apollo-lhc/Cornell_CM_Rev1_HW/README.md

# CU_PCB_6089-103
Cornell files for 6089-103 PCB, including schematics, layout, documentation
