apollo-lhc/Cornell_CM_Rev1_HW/Docs/TM4C_controller_pin_specs.xlsx

 | GPIO pin that needs to be configured
 | Alternate function pin that needs to be configured
 | Analog input
 | Pin with a pre-defined function
Pin Number | Pin Name | Pin Type | Buffer Type | Description | Signal Name
1 | AIN15 | I | Analog | Analog-to-digital converter input 15 | VCC_M1V8, direct measure of always-on 1.8v maintenance supply
2 | AIN14 | I | Analog | Analog-to-digital converter input 14 | VCC_M3V3, divided-by-2 measure of always-on 3.3v maintenance supply
3 | AIN13 | I | Analog | Analog-to-digital converter input 13 | VCC_2V5, divided-by-2 measure of 2.5v legacy timing supply.
4 | AIN12 | I | Analog | Analog-to-digital converter input 12 | VCC_12V, divided-by-6 measure of always-on 12v main input supply.
5 | PQ0 | O | TTL | GPIO port Q bit 0 | TM4C_TO_VU7P_0: This output to the VU7P is currently undefined
6 | PQ1 | I | TTL | GPIO port Q bit 1 | TM4C_FROM_VU7P_0: This input from the VU7P is currently undefined
7 | VDD | Power |  | Positive supply for I/O and some logic | VCC_M3V3: 3.3 volts from the management regulator. It is present whenever the board has 12v supplied.
8 | VDDA | Power |  | The positive supply for the analog circuits (ADC, Analog Comparators, etc.). | VCC_M3V3
9 | VREFA+ | Power |  | A reference voltage used to specify the voltage at which the ADC converts to a maximum value. | VREF_2.5V: This 2.5v voltage sets the value that will correspond to the ADC full scale valu of 4095 (0xfff)
10 | GNDA | Power |  | The ground reference for the analog circuits (ADC, Analog Comparators, etc.). | GND
11 | PQ2 | I | TTL | GPIO port Q bit 2 | TM4C_DIP_SW_2: Wired to position #4 of switch SW5, the VU7P DIP SWITCH. A HI level means that the VU7P should be powered; a LO level means that the VU7P should be left unpowered. The pullup on the switch is energized from the VCC_M3V3 source, so it is valid whenever the board has 12V supplied.
12 | AIN0 | I | Analog | Analog-to-digital converter input 0 | V_MGTY1_AVTT, direct measure of 1.2v VU7P GTY AVTT supply
13 | AIN1 | I | Analog | Analog-to-digital converter input 1 | V_MGTY1_AVCC, direct measure of 0.9v VU7P GTY AVCC supply
14 | AIN2 | I | Analog | Analog-to-digital converter input 2 | V_MGTY1_VCCAUX, direct measure of 1.8v VU7P GTY VCCAUX supply
15 | AIN3 | I | Analog | Analog-to-digital converter input 3 | V_VCCINT, direct measure of 0.85v VU7P VCCINT supply
16 | VDD | Power |  | Positive supply for I/O and some logic | VCC_M3V3: 3.3 volts from the management regulator. It is present whenever the board has 12v supplied.
17 | GND | Power |  | Ground reference for logic and I/O pins | GND
18 | AIN16 | I | Analog | Analog-to-digital converter input 16 | VCC_3V3, divided-by-2 measure of 3.3v board-wide supply
19 | AIN17 | I | Analog | Analog-to-digital converter input 17 | V_MGTY2_VCCAUX, direct measure of 1.8v VU7P GTY VCCAUX supply
20 | AIN18 | I | Analog | Analog-to-digital converter input 18 | V_MGTY2_AVCC, direct measure of 0.9v VU7P GTY AVCC supply
21 | AIN19 | I | Analog | Analog-to-digital converter input 19 | V_MGTY2_AVTT, direct measure of 1.2v VU7P GTY AVTT supply
22 | PC7 | I | TTL | GPIO port C bit 7 | V_MGTY1_AVTT_OK
23 | PC6 | I | TTL | GPIO port C bit 6 | V_MGTY1_AVCC_OK
24 | PC5 | I | TTL | GPIO port C bit 5 | V_MGTY2_AVCC_OK
25 | PC4 | I | TTL | GPIO port C bit 4 | V_MGTY2_AVTT_OK
26 | VDD | Power |  | Positive supply for I/O and some logic | VCC_M3V3: 3.3 volts from the management regulator. It is present whenever the board has 12v supplied.
27 | PQ3 | O | TTL | GPIO port Q bit 3 | V_FPGA_PROGRAM: Momentarily pulse this output HI to force the VU7P to restart its configuration process
28 | VDD | Power |  | Positive supply for I/O and some logic | VCC_M3V3: 3.3 volts from the management regulator. It is present whenever the board has 12v supplied.
29 | PH0 | I | TTL | GPIO port H bit 0 | VCC_1V8_PG
30 | PH1 | I | TTL | GPIO port H bit 1 | VCC_3V3_PG
31 | PH2 | I | TTL | GPIO port H bit 2 | V_VCCINT_PG_B
32 | PH3 | I | TTL | GPIO port H bit 3 | V_VCCINT_PG_A
33 | U0Rx | I | TTL | UART Module 0 receive | BLADE_IPMC_TX
34 | U0Tx | O | TTL | UART Module 0 transmit | BLADE_IPMC_RX
35 | U4Rx | I | TTL | UART Module 4 receive | FRONT_PANEL_UART_RX
36 | U4Tx | O | TTL | UART Module 4 transmit | FRONT_PANEL_UART_TX
37 | PA4 | O | TTL | GPIO port A bit 4 | CTRL_V_VCCINT_PWR_EN
38 | PA5 | O | TTL | GPIO port A bit 5 | CTRL_VCC_1V8_PWR_EN
39 | VDD | Power |  | Positive supply for I/O and some logic | VCC_M3V3: 3.3 volts from the management regulator. It is present whenever the board has 12v supplied.
40 | I2C6SCL | I/O | OD | I2C module 6 clock. Note that this signal has an active pull-up. The corresponding port pin should not be configured as open drain. | FPGA_I2C_SCL
41 | I2C6SDA | I/O | OD | I2C module 6 data | FPGA_I2C_SDA
42 | PF0 | O | TTL | GPIO port F bit 0 | /FPGA_I2C_RESET
43 | PF1 | O | TTL | GPIO port F bit 1 | CTRL_VCC_3V3_PWR_EN
44 | PF2 | O | TTL | GPIO port F bit 2 | CTRL_K_VCCINT_PWR_EN
45 | PF3 | O | TTL | GPIO port F bit 3 | /PWR_I2C_RESET
46 | PF4 | I/O | TTL | GPIO port F bit 4 | TM4C_TP1: The use and direction of this pin is currently undefined. Configure it as an input. It connects to a surface-pad on the bottom side of the PCB.
47 | VDD | Power |  | Positive supply for I/O and some logic | VCC_M3V3: 3.3 volts from the management regulator. It is present whenever the board has 12v supplied.
48 | GND | Power |  | Ground reference for logic and I/O pins | GND
49 | I2C1SCL | I/O | OD | I2C module 1 clock. Note that this signal has an active pull-up. The corresponding port pin should not be configured as open drain. | PWR_I2C_SCL
50 | I2C1SDA | I/O | OD | I2C module 1 data | PWR_I2C_SDA
51 | I2C2SCL | I/O | OD | I2C module 2 clock. Note that this signal has an active pull-up. The corresponding port pin should not be configured as open drain. | CLOCKS_I2C_SCL
52 | I2C2SDA | I/O | OD | I2C module 2 data | CLOCKS_I2C_SDA
53 | I2C3SCL | I/O | OD | I2C module 3 clock. Note that this signal has an active pull-up. The corresponding port pin should not be configured as open drain. | V_OPTICS_I2C_SCL
54 | I2C3SDA | I/O | OD | I2C module 3 data | V_OPTICS_I2C_SDA
55 | I2C4SCL | I/O | OD | I2C module 4 clock. Note that this signal has an active pull-up. The corresponding port pin should not be configured as open drain. | K_OPTICS_I2C_SCL
56 | I2C4SDA | I/O | OD | I2C module 4 data | K_OPTICS_I2C_SDA
57 | PQ5 | O | TTL | GPIO port Q bit 5 | /CLOCKS_I2C_RESET
58 | PQ6 | O | TTL | GPIO port Q bit 6 | /V_OPTICS_I2C_RESET
59 | PK7 | O | TTL | GPIO port K bit 7 | /K_OPTICS_I2C_RESET
60 | PK6 | I | TTL | GPIO port K bit 6 | K_VCCINT_PG_B
61 | PK5 | I | TTL | GPIO port K bit 5 | K_VCCINT_PG_A
62 | PK4 | O | TTL | GPIO port K bit 4 | BLADE_POWER_OK: Assert this signal HI when the power-up sequence is done.
63 | VDD | Power |  | Positive supply for I/O and some logic | VCC_M3V3: 3.3 volts from the management regulator. It is present whenever the board has 12v supplied.
64 | /WAKE | I | TTL | An external input that brings the processor out of Hibernate mode when asserted. | Tied to GND. This function is not used.
65 | /HIB | O | TTL | An output that indicates the processor is in Hibernate mode | No connect
66 | XOSC0 | I | Analog | Hibernation module oscillator crystal input or an external clock reference input. Note that this is either a crystal or a 32.768-kHz oscillator for the Hibernation module RTC. | Tied to GND.
67 | XOSC1 | O | Analog | Hibernation module oscillator crystal output. Leave unconnected when using a single-ended clock source. | No connect
68 | VBAT | Power |  | Power source for the Hibernation module. It is normally connected to the positive terminal of a battery and serves as the battery backup/Hibernation module power-source supply. | VCC_M3V3: 3.3 volts from the management regulator. It is present whenever the board has 12v supplied. If a battery is not used, this pin connects directly to the VDD source.
69 | VDD | Power |  | Positive supply for I/O and some logic | VCC_M3V3: 3.3 volts from the management regulator. It is present whenever the board has 12v supplied.
70 | /RESET | I | TTL | System reset input | TM4C_ENABLE: This will be asserted high when: a) BLADE_POWER_EN is HI (either from the board being operated "stand alone" or the signal driven HI by the service module) b) AND both management supplies are good (VCC_M3V3 and VCC_M1V8) c) AND the front panel "RESET" switch is not activated.
71 | PM7 | I/O | TTL | GPIO port M bit 7 | BLADE_POWER_EN: this signal is used by the ZYNQ to signal to the MCU to enable or disable blade power on the CM. Configure it as an input with 2 mA internal pull-up.
72 | PM6 | I/O | TTL | GPIO port M bit 6 | BLADE_ZYNQ_GPIO1: The use and direction of this pin is currently undefined. Configure it as an input.
73 | PM5 | I/O | TTL | GPIO port M bit 5 | BLADE_ZYNQ_GPIO2: The use and direction of this pin is currently undefined. Configure it as an input.
74 | PM4 | I | TTL | GPIO port M bit 4 | K_MGTH_AVTT_OK
75 | PM3 | I | TTL | GPIO port M bit 3 | K_MGTH_AVCC_OK
76 | PM2 | I | TTL | GPIO port M bit 2 | K_MGTY_AVCC_OK
77 | PM1 | I | TTL | GPIO port M bit 1 | K_MGTY_AVTT_OK
78 | PM0 | I | TTL | GPIO port M bit 0 | /K_FPGA_DONE: This input will be asserted LO when the KU15P configuration process has completed successfully.
79 | VDD | Power |  | Positive supply for I/O and some logic | VCC_M3V3: 3.3 volts from the management regulator. It is present whenever the board has 12v supplied.
80 | GND | Power |  | Ground reference for logic and I/O pins | GND
81 | PL0 | O | TTL | GPIO port L bit 0 | K_FPGA_PROGRAM: Momentarily pulse this output HI to force the KU15P to restart its configuration process
82 | PL1 | I | TTL | GPIO port L bit 1 | TM4C_DIP_SW_1: Wired to position #4 of switch SW4, the KU15P DIP SWITCH. A HI level means that the KU15P should be powered; a LO level means that the KU15P should be left unpowered. The pullup on the switch is energized from the VCC_M3V3 source, so it is valid whenever the board has 12V supplied.
83 | PL2 | O | TTL | GPIO port L bit 2 | CTRL_K_MGTY_VCCAUX_PWR_EN
84 | PL3 | O | TTL | GPIO port L bit 3 | CTRL_K_MGTH_VCCAUX_PWR_EN
85 | PL4 | O | TTL | GPIO port L bit 4 | CTRL_K_MGTY_AVCC_PWR_EN
86 | PL5 | O | TTL | GPIO port L bit 5 | CTRL_K_MGTH_AVCC_PWR_EN
87 | VDDC | Power |  | Positive supply for most of the logic function, including the processor core and most peripherals. The voltage on this pin is 1.2 V and is supplied by the on-chip LDO. The VDDC pins should only be connected to each other and an external capacitor as specified in Table 26-15 on page 1577 . | TM4C_VDDC: Tied to TM4C pin #115 and capacitor C791.
88 | OSC0 | I | Analog | Main oscillator crystal input or an external clock reference input. | TIed to GND. This design uses the 16 MHz internal oscillator "PIOSC".
89 | OSC1 | O | Analog | Main oscillator crystal output. Leave unconnected when using a single-ended clock source. | No connect
90 | VDD | Power |  | Positive supply for I/O and some logic | VCC_M3V3: 3.3 volts from the management regulator. It is present whenever the board has 12v supplied.
91 | I2C0SCL | I/O | OD | I2C module 0 clock. Note that this signal has an active pull-up. The corresponding port pin should not be configured as open drain. | BLADE_MASTER_I2C_SCL
92 | I2C0SDA | I/O | OD | I2C module 0 data | BLADE_MASTER_I2C_SDA
93 | PL7 | I | TTL | GPIO port L bit 7 | TM4C_FROM_KU15P_0: This input from the KU15P is currently undefined
94 | PL6 | O | TTL | GPIO port L bit 6 | TM4C_TO_KU15P_0: This output to the KU15P is currently undefined
95 | U1Rx | I | TTL | UART Module 1 receive | BLADE_ZYNQ_TX
96 | U1Tx | O | TTL | UART Module 1 transmit | BLADE_ZYNQ_RX
97 | TDO | O | TTL | JTAG TDO | JTAG_TDO | DO NOT PROGRAM
98 | TDI | I | TTL | JTAG TDI | JTAG_TDI | DO NOT PROGRAM
99 | TMS | I | TTL | JTAG TMS | JTAG_TMS | DO NOT PROGRAM
100 | TCK | I | TTL | JTAG TCK | JTAG_TCK | DO NOT PROGRAM
101 | VDD | Power |  | Positive supply for I/O and some logic | VCC_M3V3: 3.3 volts from the management regulator. It is present whenever the board has 12v supplied.
102 | PQ4 | O | TTL | GPIO port Q bit 4 | CTRL_K_MGTY_AVTT_PWR_EN
103 | PP2 | O | TTL | GPIO port P bit 2 | CTRL_K_MGTH_AVTT_PWR_EN
104 | PP3 | I/O | TTL | GPIO port P bit 3 | TM4C_TP2: The use and direction of this pin is currently undefined. Configure it as an input. It connects to a surface-pad on the bottom side of the PCB.
105 | PP4 | I/O | TTL | GPIO port P bit 4 | TM4C_TP3: The use and direction of this pin is currently undefined. Configure it as an input. It connects to a surface-pad on the bottom side of the PCB.
106 | PP5 | O | TTL | GPIO port P bit 5 | ID_EEPROM_WP: If jumper J16 is in the 2-to-3 position, then this pin controlls the write-protect pin on the ID EEPROM. A logic-0 allows writing. A logic-1 disables writing.
107 | PN0 | O | TTL | GPIO port N bit 0 | CTRL_V_MGTY2_AVTT_PWR_EN
108 | PN1 | O | TTL | GPIO port N bit 1 | CTRL_V_MGTY1_AVTT_PWR_EN
109 | PN2 | O | TTL | GPIO port N bit 2 | CTRL_V_MGTY2_AVCC_PWR_EN
110 | PN3 | O | TTL | GPIO port N bit 3 | CTRL_V_MGTY1_AVCC_PWR_EN
111 | PN4 | O | TTL | GPIO port N bit 4 | CTRL_V_MGTY2_VCCAUX_PWR_EN
112 | PN5 | O | TTL | GPIO port N bit 5 | CTRL_V_MGTY1_VCCAUX_PWR_EN
113 | VDD | Power |  | Positive supply for I/O and some logic | VCC_M3V3: 3.3 volts from the management regulator. It is present whenever the board has 12v supplied.
114 | GND | Power |  | Ground reference for logic and I/O pins | GND
115 | VDDC | Power |  | Positive supply for most of the logic function, including the processor core and most peripherals. The voltage on this pin is 1.2 V and is supplied by the on-chip LDO. The VDDC pins should only be connected to each other and an external capacitor as specified in Table 26-15 on page 1577 . | TM4C_VDDC: Tied to TM4C pin #87 and capacitor C791.
116 | PJ0 | O | TTL | GPIO port J bit 0 | TM4C_LED_BLUE: Assert this output HI to light the BLUE element of the TM4C RGB LED.
117 | PJ1 | O | TTL | GPIO port J bit 1 | TM4C_LED_GREEN: Assert this output HI to light the GREEN element of the TM4C RGB LED.
118 | PP0 | O | TTL | GPIO port P bit 0 | TM4C_LED_RED: Assert this output HI to light the RED element of the TM4C RGB LED.
119 | PP1 | I | TTL | GPIO port P bit 1 | /V_FPGA_DONE: This input will be asserted LO when the VU7P configuration process has completed successfully.
120 | AIN11 | I | Analog | Analog-to-digital converter input 11 | K_MGTH_AVTT, direct measure of 1.2v KU15P GTH AVTT supply
121 | AIN10 | I | Analog | Analog-to-digital converter input 10 | K_MGTH_AVCC, direct measure of 0.9v KU15P GTH AVCC supply
122 | VDD | Power |  | Positive supply for I/O and some logic | VCC_M3V3: 3.3 volts from the management regulator. It is present whenever the board has 12v supplied.
123 | AIN9 | I | Analog | Analog-to-digital converter input 9 | K_MGTH_VCCAUX, direct measure of 1.8v KU15P GTH VCCAUX supply
124 | AIN8 | I | Analog | Analog-to-digital converter input 8 | K_VCCINT, direct measure of 0.85v KU15P VCCINT supply
125 | AIN7 | I | Analog | Analog-to-digital converter input 7 | VCC_1V8, direct measure of 1.8v board-wide supply
126 | AIN6 | I | Analog | Analog-to-digital converter input 6 | K_MGTY_VCCAUX, direct measure of 1.8v KU15P GTY VCCAUX supply
127 | AIN5 | I | Analog | Analog-to-digital converter input 5 | K_MGTY_AVCC, direct measure of 0.9v KU15P GTY AVCC supply
128 | AIN4 | I | Analog | Analog-to-digital converter input 4 | K_MGTY_AVTT, direct measure of 1.2v KU15P GTY AVTT supply
