apollo-lhc/Cornell_CM_Rev1_HW/Orcad/6089-103-RevB_summary_BOM_with_inventory_23Jul2019.xlsx

Sheet: SCHEMATIC PARTS
6089-103
ATCA MEZZANINE BOARD, KU15P AND VU7P, MK1
Qty | 7
Item | quan/board | Reference | Description | Vendor | Vendor Number | Manufacturer | Manufacturer Number | Value | Footprint | Required | Min Excess | Min Qty | On Hand | At MPL | Short | Ordered | Received | Short | To MPL | Item | Unit Cost | Board Cost | Total Cost | Cost Source
1 | 3 | BR1,BR2,BR3 | BRACKET FOR FRONT PANEL, SCREW M3 4 PIN PCB RA | DigiKey | 36-7761-ND | Keystone | 7761 | KEYSTONE_7761 | KEYSTONE_7761 | 21 | 3 | 24 | 40 |  | -16 |  |  | -16 | 50 | 1 | $0.29 | $0.86 | $0.00
2 | 24 | C435,C436,C437,C438,C439,C440,C441,C442,C443,C444,C447,C448,C492,C493,C494,C495,C496,C497,C498,C499,C500,C501,C504,C505 | RES SMD 0 OHM JUMPER 1/16W 0402 | DigiKey | 311-0.0JRCT-ND | Yageo | RC0402JR-070RL | 0 | CAPC_EIA0402 | 168 | 10 | 178 |  |  |  |  |  | 0 | see item 40 | 2 |  | $0.00 | $0.00
3 | 8 | C579,C580,C581,C582,C953,C954,C957,C958 | CAP CER 820PF 50V NP0 0603 | DigiKey | 311-1775-1-ND | Yageo | CC0603JRNPO9BN821 | 820 PF | CAPC_EIA0603 | 56 | 4 | 60 | 30 | 40 | -10 |  |  | 0 | 100 | 3 | $0.11 | $0.91 | $0.00
4 | 5 | C882,C917,C918,C956,C959 | CAP CER 1000PF 50V X7R 0402 | DigiKey | 709-1133-1-ND | Johanson | 500R07W102KV4T | 1000 PF | CAPC_EIA0402 | 35 | 3 | 38 | 31 | 40 | -33 |  |  | 0 | 100 | 4 | $0.16 | $0.82 | $0.00
5 | 1 | C834 | CAP CER 3300PF 50V C0G/NP0 0603 | DigiKey | 490-6385-1-ND | Murata | GRM1885C1H332JA01D | 3.3 NF | CAPC_EIA0603 | 7 | 2 | 9 | 60 | 30 | -81 |  |  | 0 | 100 | 5 | $0.13 | $0.13 | $0.00
6 | 1 | C271 | CAP CER 10000PF 25V X7R 0402 | DigiKey | 490-1312-6-ND | Murata | GRM155R71E103KA01D | 0.01 UF | CAPC_EIA0402 | 7 | 2 | 9 | 47 | 40 | -78 |  |  | 0 | 100 | 6 | $0.08 | $0.08 | $0.00
7 | 16 | C17,C19,C21,C23,C25,C27,C29,C31,C365,C367,C369,C371,C373,C375,C377,C379 | CAP CER 0.047UF 25V X7R 0402 | DigiKey | 399-15998-1-ND | kemet | C0402C473K3RACAUTO | 0.047 UF | CAPC_EIA0402 | 112 | 7 | 119 | 290 | 51 | -222 |  |  | 0 | 150 | 7 | $0.11 | $1.71 | $0.00
8 | 20 | C770,C775,C779,C782,C785,C788,C797,C802,C806,C810,C811,C813,C814,C815,C816,C817,C818,C819,C820,C821 | CAP FILM 0.1UF 20% 16VDC 0805 | DigiKey | PCF1126CT-ND | Panasonic | ECP-U1C104MA5 | 0.1 UF | CAPC_EIA0805 | 140 | 9 | 149 | 136 | 47 | -34 |  |  | 0 | 150 | 8 | $0.32 | $6.34 | $0.00
9 | 342 | C1,C2,C3,C4,C9,C12,C13,C16,C20,C22,C24,C36,C37,C38,C39,C78,C90,C92,C93,C96,C97,C98,C99,C100,C101,C102,C103,C104,C109,C110,C113,C115,C116,C121,C124,C126,C127,C128,C129,C132,C133,C136,C137,C140,C141,C148,C149,C151,C155,C158,C159,C160,C161,C162,C165,C166,C171,C172,C173,C174,C181,C182,C185,C188,C189,C190,C191,C197,C200,C201,C204,C205,C210,C211,C214,C215,C216,C217,C222,C225,C227,C228,C230,C232,C233,C234,C235,C241,C242,C243,C244,C248,C249,C250,C251,C252,C257,C260,C264,C265,C268,C269,C270,C273,C281,C283,C284,C285,C286,C289,C293,C294,C295,C296,C297,C298,C300,C301,C302,C303,C304,C305,C308,C309,C310,C357,C358,C359,C360,C368,C372,C376,C380,C435,C436,C437,C438,C439,C440,C441,C442,C443,C444,C445,C446,C447,C448,C492,C493,C494,C495,C496,C497,C498,C499,C500,C501,C502,C503,C504,C505,C583,C584,C585,C586,C587,C588,C589,C590,C591,C592,C593,C594,C595,C596,C597,C598,C599,C600,C601,C602,C603,C604,C605,C606,C607,C608,C609,C610,C611,C612,C613,C614,C615,C616,C617,C618,C619,C620,C621,C622,C623,C624,C667,C668,C669,C670,C671,C672,C673,C674,C675,C676,C677,C678,C679,C680,C681,C682,C683,C684,C685,C686,C687,C688,C689,C690,C691,C692,C693,C694,C723,C724,C725,C726,C728,C729,C732,C733,C734,C735,C738,C739,C740,C741,C747,C752,C755,C756,C758,C760,C761,C762,C765,C766,C768,C769,C771,C772,C773,C774,C777,C778,C781,C783,C784,C786,C787,C789,C790,C792,C793,C794,C795,C796,C798,C799,C800,C801,C803,C804,C807,C808,C809,C812,C823,C824,C825,C826,C827,C828,C831,C832,C859,C860,C861,C862,C863,C864,C865,C866,C867,C868,C86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
27 | 1 | J1 | MGRID HDR SHRD RA /SLOTSTDF | DigiKey | WM9841-ND | Molex | 878335320 | CON_2X7_RA | CON_2X7_2MM_RA_XILINX | 7 | 2 | 9 | 12 |  | -3 |  |  | 0 | 15 | 27 | $1.09 | $1.09 | $0.00
28 | 6 | J2,J3,J4,J5,J7,J8 | CONN HEADER R/A 8POS 2MM | DigiKey | WM18614-ND | Molex | 877600816 | JUMPER_4X2 | HEADER_2MM_2X4_RA | 42 | 4 | 46 | 81 |  | -35 |  |  | 0 | 100 | 28 | $0.43 | $2.57 | $0.00
29 | 1 | J6 | HEADER 2X3 2MM RA, RS232 FOR CONTROLLER | DigiKey | WM18613-ND | Molex | 0877600616 | JUMPER_4X2 | HEADER_2MM_2x3_RA | 7 | 2 | 9 | 21 |  | -12 |  |  | 0 | 25 | 29 | $0.44 | $0.44 | $0.00
30 | 3 | J9,J10,J11 | HEADER 2X3 50MIL | DigiKey | SAM1156-03-ND | Samtec | FTS-103-01-L-D | JUMPER_DIFF | JUMPER_2X3_50MIL | 21 | 3 | 24 | 40 |  | -16 |  |  | 0 | 50 | 30 | $0.59 | $1.76 | $0.00
31 | 1 | J12 | HEADER 1X2 50MIL | DigiKey | SAM1156-01-ND | Samtec | FTS-101-01-L-D | JUMPER | JUMPER_1X2_50MIL | 7 | 2 | 9 | 30 |  | -21 |  |  | 0 | 50 | 31 | $0.22 | $0.22 | $0.00
32 | 3 | J13,J14,J15 | HEADER 2X2 50MIL | DigiKey | SAM1156-02-ND | Samtec | FTS-102-01-L-D | JUMPER_2X2 | JUMPER_2X2_50MIL | 21 | 3 | 24 | 39 |  | -15 |  |  | 0 | 50 | 32 | $0.41 | $1.22 | $0.00
33 | 1 | J16 | CONN HEADER VERT 3POS 1.27MM | DigiKey | S9014E-03-ND | Sullins | GRPB031VWVN-RC | JUMPER_3X1 | JUMPER_1X3_50MIL | 7 | 2 | 9 | 11 |  | -2 |  |  | 0 | 15 | 33 | $0.23 | $0.23 | $0.00
34 | 1 | J17 | TERM BLOCK HDR 4POS VERT 3.81MM | DigiKey | A98202-ND | TE | 284517-4 | TB4 | TB4 | 7 | 2 | 9 | 9 |  | 0 |  |  | 0 | 12 | 34 | $0.94 | $0.94 | $0.00
35 | 4 | L1,L2,L3,L4 | FERRITE BEAD 600 OHM 0805 1LN | DigiKey | 240-2399-2-ND | Laird | HZ0805E601R-10 | 600 OHM | IND_EIA0805 | 28 | 3 | 31 | 53 | 30 | -52 |  |  | 0 | 100 | 35 | $0.13 | $0.53 | $0.00
36 | 75 | L5,L6,L7,L8,L9,L10,L11,L12,L13,L14,L15,L16,L17,L18,L19,L20,L21,L22,L23,L24,L25,L26,L27,L28,L29,L30,L31,L32,L33,L34,L35,L36,L37,L38,L39,L40,L41,L42,L43,L44,L45,L46,L47,L48,L49,L50,L51,L52,L53,L54,L55,L56,L57,L58,L59,L60,L61,L62,L63,L64,L65,L66,L67,L68,L69,L70,L71,L72,L73,L74,L75,L76,L77,L78,L79 | 1µH Shielded Multilayer Inductor 2.5A 55 mOhm 1008 | DigiKey | 732-9689-6-ND | Wurth | 74479887210C | 1.0 UH | IND_1008 | 525 | 28 | 553 | 728 | 40 | -215 |  |  | 0 | 1000 | 36 | $0.47 | $35.18 | $0.00
37 | 1 | P1 | CONN, RIGHT-ANGLE POWER/SIGNAL HEADER | Samtec | ET60T-D02-3-08-000-S-R1-S | Samtec | ET60T-D02-3-08-000-S-R1-S | ET60T | ET60T-02-24-00-X-RT1-GP | 7 | 2 | 9 | 7 |  | 2 | 4 |  | 4 | 10 | 37 | $6.11 | $6.11 | $24.44
38 | 2 | P2,P3 | CONN, RIGHT-ANGLE ERM8 2X13 | Samtec | ERM8-013-01-S-D-RA-TR | Samtec | ERM8-013-01-S-D-RA-TR | ERM8 | ERM8-RA-2X13 | 14 | 2 | 16 | 22 |  | -6 |  |  | 0 | 21 | 38 | $5.94 | $11.88 | $0.00
39 | 27 | Q1,Q2,Q3,Q4,Q5,Q6,Q7,Q8,Q9,Q10,Q11,Q12,Q13,Q14,Q15,Q16,Q17,Q18,Q19,Q20,Q21,Q22,Q23,Q24,Q25,Q26,Q27 | MOSFET N-CH 20V 1.5A 1.8V LOGIC LEVEL TUMT3 | DigiKey | RUF015N02TLDKR-ND | Rohm | RUF015N02TL | FET_N_1.8V | RUF015N02_FET | 189 | 11 | 200 | 250 | 18 | -68 |  |  | 0 | 100 | 39 | $0.36 | $9.59 | $0.00 | get more
40 | 6 | R90,R91,R145,R146,R448,R489 | RES SMD 0 OHM JUMPER 1/16W 0402 | DigiKey | 311-0.0JRCT-ND | Yageo | RC0402JR-070RL | 0 | RESC_EIA0402 | 42 | 4 | 46 | 1000 |  | -954 |  |  | 0 | 10000 | 40 | $0.0013 | $0.01 | $0.00
41 | 80 | R73,R74,R75,R76,R77,R78,R79,R80,R153,R154,R155,R156,R157,R158,R159,R160,R191,R192,R230,R251,R252,R253,R254,R255,R256,R337,R338,R342,R343,R379,R381,R387,R389,R393,R394,R399,R400,R418,R420,R421,R427,R428,R429,R430,R439,R440,R441,R442,R449,R450,R461,R462,R472,R474,R479,R480,R481,R485,R518,R521,R522,R523,R527,R535,R661,R662,R663,R665,R698,R699,R700,R702,R703,R714,R717,R718,R726,R727,R728,R729 | RES SMD 0.0OHM JUMPER 1/10W 0603 | DigiKey | 311-0.0GRTR-ND | Yageo | RC0603JR-070RL | 0 | RESC_EIA0603 | 560 | 30 | 590 | 1000 |  | -410 |  |  | 0 | 5000 | 41 |  | $0.00 | $0.00
42 | 19 | R11,R25,R27,R72,R81,R83,R85,R92,R95,R98,R101,R107,R109,R113,R116,R123,R130,R133,R136 | RES SMD 33 OHM 1% 1/10W 0603 | DigiKey | 311-33.0HRDKR-ND | Yageo | RC0603FR-0733RL | 33 | RESC_EIA0603 | 133 | 8 | 141 | 1000 |  | -859 |  |  | 0 | 5000 | 42 | $0.0029 | $0.06 | $0.00
43 | 138 | R12,R18,R33,R34,R35,R36,R37,R38,R39,R40,R41,R42,R43,R44,R45,R46,R47,R48,R49,R50,R51,R52,R53,R54,R55,R56,R57,R58,R59,R60,R61,R62,R63,R64,R65,R66,R67,R119,R120,R129,R131,R138,R139,R161,R162,R163,R164,R165,R166,R167,R168,R169,R170,R171,R172,R173,R174,R175,R176,R177,R178,R179,R180,R181,R182,R183,R184,R185,R186,R187,R188,R189,R190,R348,R349,R350,R351,R352,R353,R354,R355,R356,R357,R358,R359,R360,R361,R362,R363,R364,R365,R366,R367,R368,R369,R370,R371,R372,R373,R374,R375,R376,R377,R540,R541,R542,R543,R544,R545,R546,R547,R548,R549,R550,R551,R552,R553,R554,R555,R556,R557,R558,R559,R560,R561,R562,R563,R564,R565,R566,R567,R568,R569,R570,R571,R572,R573,R574 | RES SMD 49.9 OHM 1% 1/10W 0402 | DigiKey | 311-49.9LRDKR-ND | Yageo | RC0402FR-0749R9L | 49p9 | RESC_EIA0402 | 966 | 50 | 1016 | 2000 |  | -984 |  |  | 0 | 10000 | 43 | $0.0018 | $0.25 | $0.00
~~44~~ | ~~6~~ | ~~R3,R4,R8,R9,R679,R680~~ | ~~RES SMD 59 OHM 1% 1/10W 0603~~ | ~~DigiKey~~ | ~~311-59.0HRDKR-ND~~ | ~~Yageo~~ | ~~RC0603FR-0759RL~~ | ~~59~~ | ~~RESC_EIA0603~~ | ~~42~~ | ~~4~~ | ~~46~~ |  |  |  |  |  | ~~0~~ | ~~5000~~ | ~~44~~ | ~~$0.00321~~ | ~~$0.02~~ | ~~$0.00~~
44 | 6 | R3,R4,R8,R9,R679,R680 | RES SMD 150 OHM 1% 1/10W 0603 | DigiKey | 311-150HRDKR-ND | Yageo | RC0603FR-07150RL | 150 | RESC_EIA0603 | 42 | 4 | 46 | 1000 |  | -954 |  |  | 0 | 5000 | 44 | $0.00321 | $0.02 | $0.00
45 | 49 | R84,R87,R88,R97,R100,R110,R111,R112,R117,R121,R125,R127,R132,R137,R142,R143,R147,R150,R151,R152,R452,R483,R486,R487,R490,R491,R492,R493,R494,R496,R497,R500,R502,R503,R504,R505,R506,R507,R508,R509,R510,R511,R512,R513,R514,R515,R516,R517,R519 | RES SMD 100 OHM 0.1% 1/16W 0402 | DigiKey | YAG2301CT-ND | Yageo | RT0402BRD07100RL | 100 | RESC_EIA0402 | 343 | 19 | 362 | 800 | 50 | -488 |  |  | 0 | 1000 | 45 | $0.06 | $2.94 | $0.00
46 | 6 | R89,R99,R141,R465,R466,R467 | RES SMD 240 OHM 1% 1/16W 0402 | DigiKey | 311-240LRCT-ND | Yageo | RC0402FR-07240RL | 240 | RESC_EIA0402 | 42 | 4 | 46 | 1000 |  | -954 |  |  | 0 | 10000 | 46 | $0.0018 | $0.01 | $0.00
47 | 2 | R524,R534 | RES SMD 249 OHM 0.1% 1/5W 0805 | DigiKey | TNP249ABCT-ND | Vishay | TNP249ABCT-ND | 249 | RESC_EIA0805 | 14 | 2 | 16 | 59 |  | -43 |  |  | 0 | 100 | 47 | $0.38 | $0.76 | $0.00
48 | 7 | R1,R5,R6,R10,R677,R678,R681 | RES SMD 270 OHM 1% 1/10W 0603 | DigiKey | 311-270HRDKR-ND | Yageo | RC0603FR-07270RL | 270 | RESC_EIA0603 | 49 | 4 | 53 | 1000 |  | -947 |  |  | 0 | 5000 | 48 | $0.0029 | $0.02 | $0.00
49 | 8 | R329,R330,R331,R332,R579,R580,R581,R582 | RES SMD 300 OHM 1% 1/10W 0603 | DigiKey | 311-300HRTR-ND | Yageo | RC0603FR-07300RL | 300 | RESC_EIA0603 | 56 | 4 | 60 | 1000 |  | -940 |  |  | 0 | 5000 | 49 | $0.0029 | $0.02 | $0.00
50 | 17 | R13,R19,R20,R30,R31,R69,R71,R102,R468,R469,R470,R471,R473,R475,R476,R676,R682 | RES SMD 1K OHM 1% 1/16W 0402 | DigiKey | 311-1.00KLRCT-ND | Yageo | RC0402FR-071KL | 1K | RESC_EIA0402 | 119 | 7 | 126 | 1000 |  | -874 |  |  | 0 | 10000 | 50 | $0.0018 | $0.03 | $0.00
51 | 92 | R257,R258,R261,R262,R265,R266,R269,R270,R273,R274,R277,R278,R281,R282,R285,R286,R289,R290,R293,R294,R297,R298,R301,R302,R305,R306,R309,R310,R341,R344,R345,R378,R380,R382,R383,R385,R388,R391,R395,R398,R401,R404,R406,R410,R411,R412,R414,R415,R416,R417,R587,R588,R603,R604,R607,R608,R611,R612,R615,R616,R619,R620,R623,R624,R627,R628,R631,R632,R635,R636,R639,R640,R643,R644,R650,R651,R652,R655,R656,R657,R674,R675,R683,R684,R686,R687,R689,R690,R692,R693,R695,R696 | RES SMD 2.2K OHM 1% 1/10W 0603 | DigiKey | 311-2.20KHRCT-ND | Yageo | RC0603FR-072K2L | 2.2k | RESC_EIA0603 | 644 | 34 | 678 | 1000 |  | -322 |  |  | 0 | 5000 | 51 | $0.0029 | $0.27 | $0.00
~~52~~ | ~~50~~ | ~~R259,R260,R263,R264,R267,R268,R271,R272,R275,R276,R279,R280,R283,R284,R287,R288,R291,R292,R295,R296,R299,R300,R303,R304,R307,R308,R311,R312,R601,R602,R605,R606,R609,R610,R613,R614,R617,R618,R621,R622,R625,R626,R629,R630,R633,R634,R637,R638,R641,R642~~ | ~~RES SMD 3.3K OHM 1% 1/10W 0603~~ | ~~DigiKey~~ | ~~311-3.30KHRDKR-ND~~ | ~~Yageo~~ | ~~RC0603FR-073K3L~~ | ~~3.3K~~ | ~~RESC_EIA0603~~ | ~~350~~ | ~~19~~ | ~~369~~ |  |  |  |  |  | ~~0~~ | ~~5000~~ | ~~52~~ |  | ~~$0.00~~ | ~~$0.00~~
52 | 58 | R259,R260,R263,R264,R267,R268,R271,R272,R275,R276,R279,R280,R283,R284,R287,R288,R291,R292,R295,R296,R299,R300,R303,R304,R307,R308,R311,R312,R314,R317,R320,R323,R590,R593,R596,R599,R601,R602,R605,R606,R609,R610,R613,R614,R617,R618,R621,R622,R625,R626,R629,R630,R633,R634,R637,R638,R641,R642 | RES SMD 3.3K OHM 1% 1/10W 0603 | DigiKey | 311-3.30KHRDKR-ND | Yageo | RC0603FR-073K3L | 3.3K | RESC_EIA0603 | 406 | 22 | 428 | 1000 |  | -572 |  |  | 0 | 5000 | 52 |  | $0.00 | $0.00
~~53~~ | ~~12~~ | ~~R213,R214,R219,R220,R333,R334,R335,R336,R575,R576,R577,R578~~ | ~~RES SMD 3.74K OHM 1% 1/10W 0603~~ | ~~DigiKey~~ | ~~P3.74KHDKR-ND~~ | ~~Panasonic~~ | ~~ERJ-3EKF3741V~~ | ~~3.74K~~ | ~~RESC_EIA0603~~ | ~~84~~ | ~~6~~ | ~~90~~ |  |  |  |  |  | ~~0~~ | ~~200~~ | ~~53~~ | ~~$0.06~~ | ~~$0.71~~ | ~~$0.00~~
53 | 4 | R213,R214,R219,R220 | RES SMD 3.74K OHM 1% 1/10W 0603 | DigiKey | P3.74KHDKR-ND | Panasonic | ERJ-3EKF3741V | 3.74K | RESC_EIA0603 | 28 | 3 | 31 | 115 | 38 | -122 |  |  | 0 | 200 | 53 | $0.06 | $0.24 | $0.00
54 | 63 | R2,R7,R14,R15,R16,R17,R21,R22,R23,R24,R93,R96,R103,R104,R105,R106,R114,R118,R122,R124,R126,R128,R135,R140,R144,R148,R149,R313,R316,R319,R322,R405,R407,R409,R413,R422,R443,R453,R454,R455,R456,R457,R460,R484,R498,R501,R591,R594,R597,R600,R647,R648,R649,R653,R654,R658,R659,R666,R667,R704,R705,R712,R713 | RES SMD 4.7K OHM 1% 1/10W 0603 | DigiKey | 311-4.70KHRDKR-ND | Yageo | RC0603FR-074K7L | 4.7K | RESC_EIA0603 | 441 | 24 | 465 | 1000 |  | -535 |  |  | 0 | 5000 | 54 |  | $0.00 | $0.00
~~55~~ | ~~111~~ | ~~R26,R70,R82,R86,R94,R108,R115,R134,R193,R196,R197,R200,R201,R204,R205,R208,R209,R212,R215,R216,R217,R218,R221,R222,R223,R224,R225,R226,R242,R314,R315,R317,R318,R320,R321,R323,R324,R339,R340,R346,R347,R384,R386,R390,R392,R396,R397,R402,R403,R408,R423,R424,R425,R426,R431,R432,R433,R434,R436,R438,R444,R445,R446,R447,R458,R495,R499,R520,R525,R526,R528,R529,R530,R531,R532,R533,R536,R537,R538,R539,R589,R590,R592,R593,R595,R596,R598,R599,R668,R669,R670,R671,R672,R673,R685,R688,R691,R694,R697,R706,R707,R708,R709,R710,R711,R720,R721,R722,R723,R724,R725~~ | ~~RES SMD 10K OHM 1% 1/10W 0603~~ | ~~DigiKey~~ | ~~311-10.0KHRDKR-ND~~ | ~~Yageo~~ | ~~RC0603FR-0710KL~~ | ~~10K~~ | ~~RESC_EIA0603~~ | ~~777~~ | ~~40~~ | ~~817~~ |  |  |  |  |  | ~~0~~ | ~~5000~~ | ~~55~~ |  | ~~$0.00~~ | ~~$0.00~~
55 | 92 | R26,R70,R82,R86,R94,R108,R115,R134,R215,R216,R217,R218,R221,R222,R223,R224,R225,R226,R315,R318,R321,R324,R339,R340,R346,R347,R384,R386,R390,R392,R396,R397,R402,R403,R408,R423,R424,R425,R426,R431,R432,R433,R434,R436,R438,R444,R445,R446,R447,R458,R495,R499,R520,R525,R526,R528,R529,R530,R531,R532,R533,R536,R537,R538,R539,R589,R592,R595,R598,R668,R669,R670,R671,R672,R673,R685,R688,R691,R694,R697,R706,R707,R708,R709,R710,R711,R720,R721,R722,R723,R724,R725 | RES SMD 10K OHM 1% 1/10W 0603 | DigiKey | 311-10.0KHRDKR-ND | Yageo | RC0603FR-0710KL | 10K | RESC_EIA0603 | 644 | 34 | 678 | 1000 |  | -322 |  |  | 0 | 5000 | 55 |  | $0.00 | $0.00
56 | 2 | R228,R242 | RES SMD 11K OHM 1% 1/10W 0603 | DigiKey | 311-11.0KHRDKR-ND | Yageo | RC0603FR-0711KL | 11.0K | RESC_EIA0603 | 14 | 2 | 16 | 1000 |  | -984 |  |  | 0 | 5000 | 56 | $0.0029 | $0.01 | $0.00
57 | 1 | R227 | RES SMD 12.1K OHM 1% 1/10W 0603 | DigiKey | 311-12.1KHRDKR-ND | Yageo | RC0603FR-0712K1L | 12.1K | RESC_EIA0603 | 7 | 2 | 9 | 1000 |  | -991 |  |  | 0 | 5000 | 57 | $0.0029 | $0.0029 | $0.00
58 | 1 | R233 | RES SMD 13.3K OHM 1% 1/10W 0603 | DigiKey | 311-13.3KHRDKR-ND | Yageo | RC0603FR-0713K3L | 13.3K | RESC_EIA0603 | 7 | 2 | 9 | 1000 |  | -991 |  |  | 0 | 5000 | 58 | $0.0029 | $0.0029 | $0.00
59 | 1 | R232 | RES SMD 14.7K OHM 1% 1/10W 0603 | DigiKey | 311-14.7KHRDKR-ND | Yageo | RC0603FR-0714K7L | 14.7K | RESC_EIA0603 | 7 | 2 | 9 | 1000 |  | -991 |  |  | 0 | 5000 | 59 | $0.0029 | $0.0029 | $0.00
60 | 4 | R245,R246,R248,R249 | RES SMD 16.2KOHM 0.1% 1/10W 0603 | DigiKey | P16.2KDBCT-ND | Panasonic | ERA-3AEB1622V | 16.2K | RESC_EIA0603 | 28 | 3 | 31 | 34 | 39 | -42 |  |  | 0 | 100 | 60 | $0.17 | $0.69 | $0.00
61 | 4 | R326,R328,R584,R586 | RES SMD 20K OHM 0.1% 1/10W 0603 | DigiKey | P20KDBCT-ND | Panasonic | ERA-3AEB203V | 20K | RESC_EIA0603 | 28 | 3 | 31 | 42 | 40 | -51 |  |  | 0 | 100 | 61 | $0.17 | $0.69 | $0.00
62 | 1 | R229 | RES SMD 21.5K OHM 1% 1/10W 0603 | DigiKey | 311-21.5KHRDKR-ND | Yageo | RC0603FR-0721K5L | 21.5K | RESC_EIA0603 | 7 | 2 | 9 | 1000 |  | -991 |  |  | 0 | 5000 | 62 | $0.0029 | $0.0029 | $0.00
63 | 1 | R234 | RES SMD 23.7K OHM 1% 1/10W 0603 | DigiKey | 311-23.7KHRDKR-ND | Yageo | RC0603FR-0723K7L | 23.7K | RESC_EIA0603 | 7 | 2 | 9 | 1000 |  | -991 |  |  | 0 | 5000 | 63 | $0.0029 | $0.0029 | $0.00
64 | 1 | R29 | RES SMD 34.8KOHM 0.1% 1/10W 0603 | DigiKey | P34.8KDBCT-ND | Panasonic | ERA-3AEB3482V | 34.8K | RESC_EIA0603 | 7 | 2 | 9 | 47 | 40 | -78 |  |  | 0 | 100 | 64 | $0.17 | $0.17 | $0.00
 | 1 | R231 | RES SMD 38.3KOHM 0.1% 1/10W 0603 | DigiKey | 311-38.3KHRTR-ND | Yageo | RC0603FR-0738K3L | 38,3K | RESC_EIA0603 | 7 | 2 | 9 | 5000 |  | -4991 |  |  | 0 | 100 | 64 | $0.17 | $0.17 | $0.00
65 | 4 | R325,R327,R583,R585 | RES SMD 40K OHM 0.1% 0.15W 0603 | DigiKey | PAT40KACT-ND | Vishay | PAT0603E4002BST1 | 40K | RESC_EIA0603 | 28 | 3 | 31 | 14 | 20 | -3 |  |  | 0 | 50 | 65 | $0.88 | $3.52 | $0.00
66 | 2 | R645,R646 | RES SMD 47K OHM 1% 1/10W 0603 | DigiKey | 311-47.0KHRDKR-ND | Yageo | RC0603FR-0747KL | 47K | RESC_EIA0603 | 14 | 2 | 16 | 1000 |  | -984 |  |  | 0 | 5000 | 66 | $0.0029 | $0.01 | $0.00
67 | 1 | R250 | RES SMD 61.9KOHM 0.1% 1/10W 0603 | DigiKey | P61.9KDBCT-ND | Panasonic | ERA-3AEB6192V | 61.9K | RESC_EIA0603 | 7 | 2 | 9 | 48 | 40 | -79 |  |  | 0 | 100 | 67 | $0.17 | $0.17 | $0.00
68 | 2 | R240,R243 | RES SMD 90.9K OHM 1% 1/10W 0603 | DigiKey | 311-90.9KHRDKR-ND | Yageo | RC0603FR-0790K9L | 90.9K | RESC_EIA0603 | 14 | 2 | 16 | 1000 |  | -984 |  |  | 0 | 5000 | 68 | $0.0029 | $0.01 | $0.00
69 | 2 | R241,R244 | RES SMD 100K OHM 1% 1/10W 0603 | DigiKey | 311-100KHRDKR-ND | Yageo | RC0603FR-07100KL | 100K | RESC_EIA0603 | 14 | 2 | 16 | 1000 |  | -984 |  |  | 0 | 5000 | 69 | $0.0029 | $0.01 | $0.00
70 | 1 | R28 | RES SMD 110K OHM 0.1% 1/10W 0603 | DigiKey | P110KDBCT-ND | Panasonic | ERA-3AEB114V | 110K | RESC_EIA0603 | 7 | 2 | 9 | 51 | 40 | -82 |  |  | 0 | 100 | 70 | $0.17 | $0.17 | $0.00
71 | 1 | R247 | RES SMD 147K OHM 0.1% 1/16W 0603 | DigiKey | A124705CT-ND | TE | RN73C1J147KBTD | 147K | RESC_EIA0603 | 7 | 2 | 9 | 48 | 40 | -79 |  |  | 0 | 100 | 71 | $0.47 | $0.47 | $0.00
72 | 3 | SW1,SW2,SW3 | SWITCH TACTILE SPST-NO 0.05A 12V | DigiKey | SW1103CT-ND | Omron | B3U-3100P-B | SPST-NO | SWITCH_B3U_3100P_B | 21 | 3 | 24 | 40 | 1 | -17 |  |  | 0 | 50 | 72 | $0.70 | $2.11 | $0.00
73 | 2 | SW4,SW5 | SWITCH SLIDE DIP SPST 25MA 24V | DigiKey | CT2184LPST-ND | CTS | 218-4LPST | DIP-4 | SW_DIP_4POS_50MIL | 14 | 2 | 16 | 44 |  | -28 |  |  | 0 | 50 | 73 | $0.97 | $1.94 | $0.00
74 | 7 | U1,U5,U6,U92,U93,U102,U103 | IC I/O EXPANDER I2C 16B 24TSSOP | DigiKey | 296-24827-1-ND | TI | TCA9555PWR | TCA9555 | TSSOP-24 | 49 | 4 | 53 | 62 | 10 | -19 |  |  | 0 | 100 | 74 | $1.05 | $7.32 | $0.00
75 | 8 | U2,U3,U4,U36,U91,U94,U100,U101 | IC I2C SW 8CH W/RESET 24TSSOP | DigiKey | 296-34905-2-ND | TI | TCA9548APWR | TCA9548A | TSSOP-24 | 56 | 4 | 60 | 60 | 10 | -10 |  |  | 0 | 100 | 75 | $1.05 | $8.44 | $0.00
76 | 10 | U7,U9,U37,U41,U50,U55,U60,U67,U78,U86 | IC BUFFER NON-INVERT 5.5V SOT5 | DigiKey | 296-18012-1-ND | TI | SN74LVC1G125DRLR | 74LVC1G125 | SOT5_DRL | 70 | 5 | 75 | 59 | 29 | -13 |  |  | 0 | 125 | 76 | $0.29 | $2.85 | $0.00
77 | 1 | U8 | IC REDRIVER 1CH 2GBPS 8VSSOP | Mouser | 296-13625-5-ND | TI | SN65LVDS100DGK | 65LVDS100 | TSSOP-8 | 7 | 2 | 9 | 9 |  | 0 |  |  | 0 | 12 | 77 | $5.57 | $5.57 | $0.00
78 | 1 | U10 | IC CLK BUFFER 1:3 2GHZ 16MLF | DigiKey | SY89872UMG-DKR-ND | Microchip | SY89872UMG | SY89872 | QFN-16 | 7 | 2 | 9 | 10 |  | -1 |  |  | 0 | 12 | 78 | $9.68 | $9.68 | $0.00 | CHANGE DIGIKEY NUMBER IN SCHEMATIC
79 | 1 | U11 | IC CLK BUFFER 1:4 2.5GHZ 16MLF | DigiKey | SY89832UMG-TR-ND | Microchip | SY89832UMG-TR | SY89832U | QFN-16 | 7 | 2 | 9 | 10 |  | -1 |  |  | 0 | 12 | 79 | $6.55 | $6.55 | $0.00
80 | 1 | U12 | IC FF D-TYPE SNGL 16QFN | DigiKey | NB7V52MMNHTBGOSCT-ND | ON Semi | NB7V52MMNHTBG | NB7V52M | QFN-16 | 7 | 2 | 9 | 10 | 3 | -4 |  |  | 0 | 12 | 80 | $12.83 | $12.83 | $0.00
81 | 1 | U13 | CONN SFP RCPT 20POS SLD R/A SMD | DigiKey | UE75-A20-6000TCT-ND | Amphenol | UE75-A20-6000T | SFP_CONN_WITH_CAGE | SFP_CONN_NATE | 7 | 2 | 9 | 11 |  | -2 |  |  | 0 | 12 | 81 | $1.02 | $1.02 | $0.00 | on-hand
82 | 1 | U13A | CONN SFP CAGE PRESS-FIT R/A | DigiKey | U77-A1118-200TCT-ND | Amphenol | U77-A1118-200T | SFP_CONN_WITH_CAGE | SFP_CONN_NATE | 7 | 2 | 9 | 11 |  | -2 |  |  | 0 | 9 | 82 | $1.61 | $1.61 | $0.00 | on-hand
83 | 1 | U14 | IC CLOCK/DATA RECOVERY 32LFCSP | DigiKey | ADN2814ACPZ-ND | Analog Devices | ADN2814ACPZ | ADN2814 | LFCSP_5MM_32 | 7 | 2 | 9 | 10 |  | -1 |  |  | 0 | 12 | 83 | $21.36 | $21.36 | $0.00
84 | 8 | U15,U16,U17,U18,U118,U119,U120,U121 | DC DC CONVERTER 0.6-3.3V 66W 20 AMP | DigiKey | 555-1430-6-ND | GE | IND072 | IND072 | IND072 | 56 | 4 | 60 | 67 |  | -7 |  |  | 0 | 67 | 84 | $16.30 | $130.42 | $0.00
85 | 1 | U19 | IC REG LINEAR 2.5V 1.5A SOT223-3 | DigiKey | LT1963AEST-2.5#PBF-ND | Linear | LT1963AEST-2.5#PBF | LT1963A | LT1963A_SOT-223 | 7 | 2 | 9 | 10 | 3 | -4 |  |  | 0 | 12 | 85 | $6.18 | $6.18 | $0.00
86 | 25 | U20A,U29A,U104A,U106A,U108A,U116A, U21A,U30A,U105A,U107A,U109A,U117A, U22A,U23A,U24A,U25A,U26A,U27A,U28A,U110A,U111A,U112A,U113A,U114A,U115A | CONN, FIREFLY POWER | Samtec | UCC8-010-1-H-S-1-A | Samtec | UCC8-010-1-H-S-1-A | UCC8 | CONN_SAMTEC_UCC8 | 175 | 10 | 185 | 186 |  | -1 |  |  | 0 | 248 | 86 | $2.67 | $66.75 | $0.00
87 | 25 | U20B,U29B,U104B,U106B,U108B,U116B, U21B,U30B,U105B,U107B,U109B,U117B, U22B,U23B,U24B,U25B,U26B,U27B,U28B,U110B,U111B,U112B,U113B,U114B,U115B | CONN, FIREFLY SIGNAL | Samtec | UEC5-019-2-H-D-RA-1 | Samtec | UEC5-019-2-H-D-RA-1 | UEC5 | CONN_SAMTEC_UEC5 | 175 | 10 | 185 | 192 |  | -7 |  |  | 0 | 248 | 87 | $9.49 | $237.25 | $0.00
88 | 1 | U31 | DC DC CONVERTER 0.9-5V, 3A | DigiKey | 296-43922-1-ND | TI | TPS82130SILT | TPS82130 | TPS82130 | 7 | 2 | 9 | 10 |  | -1 |  |  | 0 | 15 | 88 | $3.58 | $3.58 | $0.00
89 | 1 | U32 | IC VOLT SUPERVISOR 3.3V SOT23-6 | DigiKey | 296-17195-1-ND | TI | TPS3808G33DBVR | TPS3808-3.3 | SOT23-6 | 7 | 2 | 9 | 0 | 10 | -1 |  |  | 0 | 25 | 89 | $1.75 | $1.75 | $0.00
90 | 1 | U33 | IC VOLT SUPERVISOR 1.8V SOT23-6 | DigiKey | 296-17192-1-ND | TI | TPS3808G18DBVR | TPS3808-1.8 | SOT23-6 | 7 | 2 | 9 | 6 | 10 | -7 |  |  | 0 | 25 | 90 | $1.71 | $1.71 | $0.00
91 | 9 | U34,U69,U70,U71,U72,U73,U74,U75,U76 | IC GATE AND 1CH 2-INP SOT5 | DigiKey | 296-18011-1-ND | TI | SN74LVC1G08DRLR | 74LVC1G08 | SOT5_DRL | 63 | 5 | 68 | 57 | 30 | -19 |  |  | 0 | 120 | 91 | $0.26 | $2.35 | $0.00
92 | 1 | U35 | IC EEPROM 2K I2C 400KHZ 8SOIC | DigiKey | 24LCS52-I/SN-ND | Microchip | 24LCS52-I/SN | 24LCS52 | SOIC050P240-8 | 7 | 2 | 9 | 9 |  | 0 |  |  | 0 | 12 | 92 | $0.91 | $0.91 | $0.00 | P/N IS 24LCS52T - DOES THE 'T' MAKE A DIFFERENCE
93 | 6 | U38,U40,U45,U46,U47,U48 | IC TRNSLTR UNIDIRECTIONAL SC70-5 | DigiKey | 296-34900-6-ND | TI | SN74AUP1T34DCKR | 74AUP1T34 | SC-70-5 | 42 | 4 | 46 | 40 | 11 | -5 |  |  | 0 | 30 | 93 | $0.74 | $4.47 | $0.00
94 | 1 | U39 | IC VREF SERIES 2.5V SOT23-6 | DigiKey | LT1790BIS6-2.5#TRMPBFCT-ND | Linear | LT1790BIS6-2.5#TRMPBF | LT1790-2.5V | TSOT23-6 | 7 | 2 | 9 | 8 | 1 | 0 |  |  | 0 | 12 | 94 | $4.40 | $4.40 | $0.00
95 | 7 | U42,U49,U53,U57,U62,U77,U84 | IC BUFFER NON-INVERT 5.5V SOT5 | DigiKey | 296-18013-1-ND | TI | SN74LVC1G126DRLR | 74LVC1G126 | SOT5_DRL | 49 | 4 | 53 | 42 | 31 | -20 |  |  | 0 | 100 | 95 | $0.30 | $2.09 | $0.00
96 | 4 | U43,U59,U88,U97 | 312.5MHz LVDS XO Oscillator 3.3V Enable/Disable | DigiKey | 336-2696-ND | Silicon Labs | 530BC312M500DG | OSC_SI530_312.5MHZ | OSC_SI530 | 28 | 3 | 31 | 36 |  | -5 |  |  | 0 | 38 | 96 | $24.57 | $98.29 | $0.00
97 | 12 | U44,U56,U58,U61,U64,U68,U79,U80,U83,U87,U89,U96 | Clock Fanout Buffer, Multiplexer IC 1.25GHz 16-VFQFN | DigiKey | 336-4763-6-ND | Silicon Labs | SI53340-B-GM | SI53340 | QFN-16 | 84 | 6 | 90 | 99 |  | -9 |  |  | 0 | 110 | 97 | $1.82 | $21.86 | $0.00
98 | 4 | U51,U54,U85,U99 | IC REG LINEAR 1.8V 2A 20HTSSOP | DigiKey | 296-20791-1-ND | TI | TPS75218QPWPREP | TPS75218 | TPS75218 | 28 | 3 | 31 | 33 |  | -2 |  |  | 0 | 50 | 98 | $4.92 | $19.66 | $0.00
99 | 1 | U52 | IC MCU 32BIT 1MB FLASH 128TQFP | DigiKey | 296-43658-1-ND | TI | TM4C1290NCPDTI3R | TM4C1290NCPDT | LQFP128 | 7 | 2 | 9 | 10 |  | -1 |  |  | 0 | 12 | 99 | $10.99 | $10.99 | $0.00
100 | 2 | U63,U82 | 200MHz LVDS XO Oscillator 3.3V Enable/Disable | DigiKey | 336-2666-ND | Silicon Labs | 510BBA200M000AAG | OSC_SI510_200MHZ | OSC_SI510 | 14 | 2 | 16 | 20 |  | -4 |  |  | 0 | 20 | 100 | $4.19 | $8.38 | $0.00 | 14 back ordered
101 | 1 | U81 | SI5340 FREQUENCY SYNTHESIZER | DigiKey | 336-3768-ND | Silicon Labs | SI5340A-D-GM | SI5340 | QFN44 | 7 | 2 | 9 | 10 |  | -1 |  |  | 0 | 12 | 101 | $13.78 | $13.78 | $0.00 | look into programming issue
102 | 1 | U90 | IC REG LDO 1.8V 0.3A TSOT23-5 | DigiKey | ADP1713AUJZ-1.8-R7CT-ND | Analog Devices | ADP1713AUJZ-1.8-R7 | ADP1713_1V8 | SOT23-5 | 7 | 2 | 9 | 16 | 15 | -22 |  |  | 0 | 40 | 102 | $1.54 | $1.54 | $0.00
103 | 2 | U95,U98 | NOR Flash Serial-SPI 1.8V 1Gbit 4bit 6ns 16-Pin SOP-II | Mouser | MT25QU01GBBB8ESF-0SIT | Micron | MT25QU01GBBB8ESF-0SIT | MT25QU01 | MT25QU01_SO16 | 14 | 2 | 16 | 16 |  | 0 |  |  | 0 | 20 | 103 | $16.09 | $32.18 | $0.00
104 | 5 | U122,U123,U124,U125,U126 | DC DC CONVERTER, 2 X 0.6-5.2V 40 AMP | DigiKey | 454-1792-6-ND | Artesyn | LGA80D-00DADJJ | LGA80D | LGA80D | 35 | 3 | 38 | 42 |  | -4 |  |  | 0 | 43 | 104 | $34.69 | $173.43 | $0.00
105a | 1 | X1 | CRYSTAL 48.0000MHZ 8PF SMD | DigiKey | 1253-1377-1-ND | Kyocera | CX3225SB48000D0FPJC1 | 48 MHz | CRYSTAL_SMD4 | 7 | 2 | 9 | 0 | 3 | 6 | 10 |  | 10 | 12 | 105 | $1.52 | $1.52 | #REF!
105b |  |  |  |  | 535-14093-1-ND | Abracon | ABM8W-48.0000MHZ-8-B1U-T3 |  |  |  |  |  | 10
106 | 1 | C830 | CAP CER TBD |  |  |  |  | DNP | CAPC_EIA0603 | 0 |  |  |  |  |  |  |  |  |  | 106 |  | $0.00 | $0.00
107 | 18 | H1,H2,H3,H4,H5,H6,H7,H8,H9,H10,H11,H12,H13,H14,H15,H16,H17,H18 | HOLE FOR M2.5 SCREW, PART OF PCB |  |  |  |  | DNP | HOLE_M2P5_STANDOFF | 0 |  |  |  |  |  |  |  |  |  | 107 |  | $0.00 | $0.00
108 | 2 | J18,J19 | FPGA TEST CONN, CONN_2MM_2X7_VERT |  |  |  |  | DNP | CONN_2MM_2X7_VERT | 0 |  |  |  |  |  |  |  |  |  | 108 |  | $0.00 | $0.00
109 | 26 | PM1,PM2,PM3,PM4,PM5,PM6,PM7,PM8,PM9,PM10,PM11,PM12,PM13,PM14,PM15,PM16,PM17,PM18,PM19,PM20,PM21,PM22,PM23,PM24,PM25,PM26 | THRU_HOLE TEST POINT, PART OF PCB |  |  |  |  | DNP | TESTPT_C55H35 | 0 |  |  |  |  |  |  |  |  |  | 109 |  | $0.00 | $0.00
110 | 17 | R419,R435,R437,R451,R459,R463,R464,R477,R478,R482,R488,R660,R664,R701,R715,R716,R719 | RES SMD 0.0OHM JUMPER 1/10W 0603 | DigiKey | 311-0.0GRDKR-ND | Yageo | RC0603JR-070RL | DNP | RESC_EIA0603 | 0 |  |  |  |  |  |  |  |  |  | 110 |  | $0.00 | x
~~111~~ | ~~10~~ | ~~R194,R195,R198,R199,R202,R203,R206,R207,R210,R211~~ | ~~RES SMD 10K OHM 1% 1/10W 0603~~ | ~~DigiKey~~ | ~~311-10.0KHRDKR-ND~~ | ~~Yageo~~ | ~~RC0603FR-0710KL~~ | ~~DNP~~ | ~~RESC_EIA0603~~ | ~~0~~ |  |  |  |  |  |  |  |  |  | 111 |  | $0.00 | $0.00
111 | 20 | R193,R194,R195,R196,R197R198,R199,R200,R201,R202,R203,R204,R205,R206,R207,R208,R209,R210,R211,R212 | RES SMD 10K OHM 1% 1/10W 0603 | DigiKey | 311-10.0KHRDKR-ND | Yageo | RC0603FR-0710KL | DNP | RESC_EIA0603 | 0
112 | 5 | R235,R236,R237,R238,R239, | RES SMD TBD 1/10W 0603 | DigiKey | TBD | TBD | TBD | DNP | RESC_EIA0603 | 0 |  |  |  |  |  |  |  |  |  | 112 |  | $0.00 | $0.00
113 | 2 | R32,R68 | RESISTOR | DigiKey |  |  |  | DNP | RESC_EIA0402 | 0 |  |  |  |  |  |  |  |  |  | 113 |  | $0.00 | $0.00
114 | 2 | SP1,SP2 | SPLICE PLATE, CORNELL DWG 6089-114-RevA | - | - | - | - | DNP | SPLICE_PLATE_APOLLO | 0 |  |  |  |  |  |  |  |  |  | 114 |  | $0.00 | $0.00
115 | 3 | TP1,TP2,TP3 | TEST POINT, PART OF PCB |  |  |  |  | DNP | TESTPT_SMPAD | 0 |  |  |  |  |  |  |  |  |  | 115 |  | $0.00 | $0.00
116 | 1 | U65 | FPGA KU15P IN A1760 PACKAGE |  |  |  |  | DNP | FPGA_A1760_IRONWOOD_6082 | 0 |  |  |  |  |  |  |  |  |  | 116 |  | $0.00 | $0.00
117 | 1 | U66 | FPGA VU7P IN B2104 PACKAGE |  |  |  |  | DNP | FPGA_B2104_IRONWOOD_6444 | 0 |  |  |  |  |  |  |  |  |  | 117 |  | $0.00 | $0.00
118 | 148 | VA1,VA2,VA3,VA4,VA5,VA6,VA7,VA8,VA9,VA10,VA11,VA12,VA13,VA14,VA15,VA16,VA17,VA18,VA19,VA20,VA21,VA22,VA23,VA24,VA25,VA26,VA27,VA28,VA29,VA30,VA31,VA32,VA33,VA34,VA35,VA36,VA37,VA38,VA39,VA40,VA41,VA42,VA43,VA44,VA45,VA46,VA47,VA48,VA49,VA50,VA51,VA52,VA53,VA54,VA55,VA56,VA57,VA58,VA59,VA60,VA61,VA62,VA63,VA64,VA65,VA66,VA67,VA68,VA69,VA70,VA71,VA72,VA73,VA74,VA75,VA76,VA77,VA78,VA79,VA80,VA81,VA82,VA83,VA84,VA85,VA86,VA87,VA88,VA89,VA90,VA91,VA92,VA93,VA94,VA95,VA96,VA97,VA98,VA99,VA100,VA101,VA102,VA103,VA104,VA105,VA106,VA107,VA108,VA109,VA110,VA111,VA112,VA113,VA114,VA115,VA116,VA117,VA118,VA119,VA120,VA121,VA122,VA123,VA124,VA125,VA126,VA127,VA128,VA129,VA130,VA131,VA132,VA133,VA134,VA135,VA136,VA137,VA138,VA139,VA140,VA141,VA142,VA143,VA144,VA145,VA146,VA147,VA148 | VIA ARRAY, PART OF PCB |  |  |  |  | DNP | VIA_ARRAY_19H10 | 0 |  |  |  |  |  |  |  |  |  | 118 |  | $0.00 | $0.00
119 | 8 | R333,R334,R335,R336,R575,R576,R577,R578 | RESISTOR |  |  |  |  | DNP | RESC_EIA0603
 | 2396
 |  |  |  |  |  |  |  |  |  |  |  |  |  |  |  |  |  |  |  |  |  | $1217.50 | #REF!

Sheet: OTHER PARTS PER BOARD
6089-103
ATCA MEZZANINE BOARD, KU15P AND VU7P, MK1
Qty | 10
Item | quan/board | Description | Vendor | Vendor Number | Manufacturer | Manufacturer Number | Value | Required | Min Excess | Min Qty | On Hand | Get More | Ordered | Received | Short | Unit Cost | Board Cost | Total Cost | Cost Source
 | 1 | HEAT SINK, KU15P, CORNELL DWG 6089-104-RevA | Xometry |  |  |  | KU15P HEATSINK | 10 | 2 | 12 |  |  | 10 |  | 10 | $172.00 | $172.00 | $1720.00 | $34 in quantity
 | 1 | HEAT SINK, VU7P, CORNELL DWG 6089-107-RevA | Xometry |  |  |  | VU7P HEATSINK | 10 | 2 | 12 |  |  | 10 |  | 10 | $172.00 | $172.00 | $1720.00 | $34 in quantity
 | 2 | HEAT SINK MOUNTING PLATE, CORNELL DWG 6089-108-RevA |  |  |  |  | HEATSINK PLATE | 20 | 3 | 23 | 16 |  |  |  | 0 | $21.95 | $43.90 | $0.00
 | 1 | HEAT SINK, FIREFLY (LEFT SIDE), CORNELL DWG 6089-110-RevA |  |  |  |  | FIREFLY HEATSINK (LEFT SIDE) | 10 | 2 | 12 |  |  | 10 |  | 10 | $126.63 | $126.63 | $1266.30
 | 1 | HEAT SINK, FIREFLY (RIGHT SIDE), CORNELL DWG 6089-111-RevA |  |  |  |  | FIREFLY HEATSINK (RIGHT SIDE) | 10 | 2 | 12 |  |  | 10 |  | 10 | $126.63 | $126.63 | $1266.30
 | 2 | SPLICE PLATE, CORNELL DWG 6089-114-RevA | - | - | - | - | DNP | 20 | 3 | 23 |  |  |  |  | 0 | $18.04 | $36.09 | $0.00
 | 1 | FRONT SUBPANEL, CORNELL DWG 6089-115-RevA | - | - | - | - | DNP | 10 | 2 | 12 |  |  |  |  | 0 | $70.00 | $70.00 | $0.00
 | 12 | PEMNUT, M3 THREAD, 3 MM LONG 12 FOR SPLICE PLATES | D.B. Roberts | SOA-M3-3 | Penn Engineering | SOA-M3-3 |  | 120 | 8 | 128 |  |  | 119 | 119 | 0 | $0.18 | $2.22 | $22.02
 | 12 | SPRING, PRESSURE 12 FOR FPGA HEAT SINK | Alpha Novatech | S001YJ24 | Alpha Novatech | S001YJ24 |  | 120 | 8 | 128 |  |  | 125 | 125 | 0 | $0.95 | $11.40 | $118.75
 | 12 | HEX STANDOFF M3 SS 10 MM 12 FOR FPGA HEATSINK | DigiKey | 36-24473-ND | Keystone | 24473 | 10 MM X M3 | 120 | 8 | 128 |  |  | 150 | 150 | 0 | $1.42 | $17.08 | $213.45
 | 6 | HEX STANDOFF M2.5X0.45 BRASS 8MM 6 FOR FIREFLY HEATSINK | DigiKey | AE10868-ND | Assmann | V6516B | 8 MM X M2.5 | 60 | 5 | 65 |  |  | 100 | 100 | 0 | $0.13 | $0.76 | $12.70
 | 8 | HEX STANDOFF M2.5 30 MM 8 FOR FRONT PANEL FIBER FEEDTHRUS | DigiKey | 732-12883-ND | Wurth | 970300154 | 30 MM X M2.5 | 80 | 6 | 86 |  |  | 100 | 100 | 0 | $0.87 | $6.95 | $86.86
 | 8 | HEX STANDOFF M2.5 45 MM 8 FOR FRONT PANEL FIBER FEEDTHRUS | DigiKey | 732-13036-ND | Wurth | 970450155 | 45 MM X M2.5 | 80 | 6 | 86 |  |  | 100 | 0 | 100 | $1.04 | $8.32 | $104.06
 | 4 | HEX STANDOFF M2.5 20 MM 4 FOR TOP COVER | DigiKey | 732-12874-ND | Wurth | 970200154 | 20 MM X M2.5 | 40 | 4 | 44 |  |  | 50 | 50 | 0 | $0.55 | $2.20 | $27.44
 | 6 | HEX STANDOFF M2.5 10 MM, MALE-FEMALE 6 FOR TOP COVER | DigiKey | AE10793-ND | Assmann | V6622C | 10 MM X M2.5 M-F | 60 | 5 | 65 |  |  | 100 | 100 | 0 | $0.16 | $0.98 | $16.40
 | 12 | SCREW, M3-0.5, 6 MM LONG, FLAT HEAD, 12 FOR FPGA HEATSINK | Grainger | 6HB74 |  |  |  | 120 | 8 | 128 |  |  | 200 | 200 | 0 | $0.05 | $0.65 | $10.90
 | 27 | SCREW,M3-0.5, 6 MM LONG, CHEESEHEAD 12 FOR FPGA HEATSINK 12 FOR SPLICE PLATE 3 FOR FRONT SUBPANEL | Grainger | 6GE39 |  |  |  | 270 | 15 | 285 |  |  | 400 | 400 | 0 | $0.06 | $1.51 | $22.40
 | 12 | FLAT WASHER, M3, 7 MM OD, 0.5 MM THICK 12 FOR FPGA HEATSINK | Grainger | 26WC30 |  |  |  | 120 | 8 | 128 |  |  | 600 | 600 | 0 | $0.01 | $0.17 | $8.40
 | 0 | FLAT WASHER, M2.5, 6 MM OD, 0.5 MM THICK | Grainger | 22UH30 |  |  |  | 0 | 2 | 2 |  |  | 500 | 500 | 0 | $0.01 | $0.00 | $7.00
 | 27 | LOCK WASHER, M3 12 FOR FPGA HEATSINK 12 FOR SPLICE PLATE 3 FOR FRONT SUBPANEL | Grainger | 22UK30 |  |  |  | 270 | 15 | 285 |  |  | 350 | 350 | 0 |  | $0.00
 | 28 | LOCK WASHER, M2.5 12 FOR FIREFLY HEATSINKS 16 FOR FRONT PANEL FIBER FEEDTHRUS | Grainger | 22UK29 |  |  |  | 280 | 16 | 296 |  |  | 500 | 500 | 0 |  | $0.00
 | 4 | MTP FEEDTHRU, GANGED 1X6, STRAIGHT | FiberTronics | 12697 | US Conec | 12697 |  | 40 | 4 | 44 |  |  | 12 | 12 | 0 | $32.48 | $129.92 | $389.76
 | 7 | LIGHTPIPE, CLEAR, 0.125" LENGTH | DigiKey | 350-3721-ND | Dialight | 51513010125F |  | 70 | 5 | 75 |  |  | 100 | 0 | 100 | $0.43 | $2.99 | $42.70
 | 1 | FPGA SOCKET FOR VU7P IN B2104 PACKAGE | Ironwood |  |  |  | FPGA_VU7P_B2104 | 10 | 2 | 12 |  |  |  |  | 0 |  | $0.00
 | 1 | FPGA SOCKET FOR KU150 IN A1760 PACKAGE | Ironwood |  |  |  | FPGA_KU15P_A1760 | 10 | 2 | 12 |  |  |  |  | 0 |  | $0.00 | $0.00
 |  |  |  |  |  |  |  |  |  |  |  |  |  |  |  |  | $0.00
 |  |  |  |  |  |  |  |  |  |  |  |  |  |  |  |  | $932.40

Sheet: SHARED PARTS
6089-103
ATCA MEZZANINE BOARD, KU15P AND VU7P, MK1
Qty | 10
Item | quan/board | Description | Vendor | Vendor Number | Manufacturer | Manufacturer Number | Value | Footprint | Required | Min Excess | Min Qty | Get More | Ordered | Received | Short | Unit Cost | Total Cost | Cost Source
 | HARDWARE |  |  |  |  |  |  |  |  | 2 | 2 |  |  |  | 0
 |  |  |  |  |  |  |  |  |  | 2 | 2 |  |  |  | 0
 | SHARED | THERM PAD 320MMX320MM W/ADH GRAY | DigiKey | 1168-1222-ND | t-Global | H48-6-320-320-1.0-1A |  |  |  | 2 | 2 |  | 1 | 1 | 0 | $39.85 | $39.85
 | SHARED | CABLE USB EMBD UART 3.3V .1"HDR | DigiKey | 768-1015-ND | FTDI | TTL-232R-3V3 |  |  |  | 2 | 2 |  | 1 | 1 | 0 | $20.00 | $20.00
 | SHARED | CONN HOUSING 2MM 6POS | DigiKey | WM18031-ND | Molex | 0511100650 |  |  | 10 | 2 | 12 |  |  |  | 0 |  | $0.00
 | SHARED | CONN HOUSING 2MM 8POS | DigiKey | WM18032-ND | Molex | 0511100850 |  |  | 10 | 2 | 12 |  |  |  | 0 |  | $0.00
 | SHARED | CONN SOCKET 24-30AWG CRIMP GOLD | DigiKey | WM1128CT-ND | Molex | 0503948051 |  |  | 100 | 7 | 107 |  |  |  | 0 |  | $0.00
 | SHARED | CONN SHUNT 1.27MM BLACK W/HANDLE | DigiKey | 952-1731-ND | Harwin | M50-2000005 |  |  | 100 | 7 | 107 |  |  |  | 0 |  | $0.00
 | SHARED | CONN SHUNT 1.27MM BLACK | DigiKey | 952-1730-ND | Harwin | M50-1900005 |  |  | 100 | 7 | 107 |  |  |  | 0 |  | $0.00
 | SHARED | CONN SHUNT 2MM GOLD W/HANDLE | DigiKey | S9642-ND | Sullins | NPN02SXLN-RC |  |  | 100 | 7 | 107 |  |  |  | 0 |  | $0.00
 | SHARED | CONN SHUNT 2MM GOLD | DigiKey | SAM8748-ND | Samtec | 2SN-BK-G |  |  | 100 | 7 | 107 |  |  |  | 0 |  | $0.00
 |  |  |  |  |  |  |  |  |  | 2 | 2 |  |  |  | 0
 | Ordered but not used |  |  |  |  |  |  |  |  | 2 | 2 |  |  |  | 0 |  | $0.00
 | 0 | CAP TANT POLY 330UF 6.3V 2917 |  | 399-10418-1-ND | kemet | T520D337M006ATE009 | 330 UF | CAPTANT_7343_P1 | 0 | 2 | 2 |  | 500 | 500 | 0 | $0.79 | $392.50
 | 0 | CONN HEADER 8POS 2MM STR DL SMD | DigiKey | 609-2995-1-ND | Amphenol FCI | 98424-G52-08ALF | JUMPER_4X2 | CONN_2MM_2X4_VERT_SMD | 0 | 2 | 2 |  | 60 | 60 | 0 | $0.86 | $51.60
 | 0 | HEADER 1X6 100MIL, RS232 FOR CONTROLLER | DigiKey | 732-5319-ND | Wurth | 61300611121 | CON6 | CONN_1X6_VERT_100MIL | 0 | 2 | 2 |  | 12 | 12 | 0 | $0.28 | $3.35
 |  |  |  |  |  |  |  |  |  | 2 | 2 |  |  |  | 0
 | 1 | FPGA SOCKET FOR VU7P IN B2104 PACKAGE | Ironwood |  |  |  | FPGA_VU7P_B2104 | FPGA_B2104_IRONWOOD_6444 | 7 | 2 | 9 |  |  |  | 0 | 1000
 | 1 | FPGA SOCKET FOR KU150 IN A1760 PACKAGE | Ironwood |  |  |  | FPGA_KU15P_A1760 | FPGA_A1760_IRONWOOD_6082 | 7 | 2 | 9 |  |  |  | 0 | $1000.00 | $0.00
