apollo-lhc/Cornell_CM_Rev1_HW/Docs/IPMC_Inventory.md

The IPMC inventory has been moved to the documentation page: <https://apollo-lhc.gitlab.io/IPMC/04-ipmc-inventory/>
