apollo-lhc/Cornell_CM_Rev1_HW/Docs/ApolloSM_inventory.md

In principle these boards are allocated 5/5 to ATLAS and CMS.  The "Owner" column is an attempt to assign ownership of the working boards.  Once the 15 Rev 2 SM are in play the plan is for all 8 working Rev 1 SM to go to ATLAS temporarily.

Rev 1 SM

|  ID | Location | Working | Remote Access? | FPGAs (CM SN) | notes | (SM) Owner  | local IP |
| --- | --- | --- | --- | --- | --- | --- | --- |
| 001 | CERN TIF | yes | - | Cornell CMXX | VU7P-2 | CMS | |
| 002 | BU (can ship?) | yes | yes | Cornell CM | ATLAS SM/CM? | ATLAS  | 192.168.30.22 |
| 003 | _BU (assembly room)_ | _no_ | - | - | | - | |
| 004 | _BU (assembly room)_ | _no_ | - | - | | - | |
| 005 | CERN TIF | yes | yes | Cornell CMXX | | CMS | |
| 006 | BU (PRB3 lab?) | yes | yes | NO CM | | ATLAS  | 192.168.30.62 |
| 007 | UMASS Amherst | yes | yes | ATLAS Cornell CM | | ATLAS  | |
| 008 | MPI (ATLAS) | yes | - | MPI CM | | ATLAS  | |
| 009 | Cornell | yes | yes | Cornell CM08 | | CMS | |
| 010 | Cornell | yes | yes | Cornell CM07 | | CMS | |

Rev 2 SM

|  ID | Location | Working | Remote Access? | FPGAs (CM SN) | notes | Owner  | local IP|
| --- | --- | --- | --- | --- | --- | --- | --- |
| 201 | BU (Comtel Shelf 0x98) | yes | yes | MPI | | ? | 192.168.30.201 |
| 202 | BU (Comtel Shelf 0x96) | yes | yes | | | ? | 192.168.30.202|

Rev 2a SM

|  ID | Location | Working | Remote Access? | FPGAs (CM SN) | notes | Owner  | local IP|
| --- | --- | --- | --- | --- | --- | --- | --- |
| 1 | BU EDF  | no 3v3STBY short | no | | | ? | |
| 2 | BU (Schroff Shelf 0x90) | yes | yes (Dan only) | cornell | | ? | 192.168.30.12|
