apollo-lhc/Cornell_CM_Rev1_HW/Docs/FF_inventory.md

| Inventory | Used with VU7P | Used with KU15P | unused | total | |
| --- | --- | --- | --- | --- | --- |
| 25G x4 FireFly | 50 | 18 | 7 | 75 | |
| 14G x12 FireFly (long)  | 2 | 9 | 4 | 15 | 3 pieces are missing |
| 14G x12 FireFly (short) | 4 | 1 | 2 | 7 | short will not work in back row |
| VU7P | 7 | | 1 | 8 | |
| KU15P | | 7 | 0 | 7 | 2 on loan were returned |
