apollo-lhc/Cornell_CM_Rev1_HW/(list of files, cad)

Other CAD files:
Inventor/6089-104-RevA_HEATSINK_KU15P.ipt
Inventor/6089-107-RevA_HEATSINK_VU7P.ipt
Inventor/6089-110_FF_left_heatsink.ipt
Inventor/6089-111_FF_right_heatsink.ipt
