apollo-lhc/Cornell_CM_Rev1_HW/Orcad/atca_mezz_ku15p_vu7p_30Aug2019.pdf

# THIS IS A FLAT SCHEMATIC, NOT A HIERARCHICAL ONE. NETS USE "OFFPAGE

CONNECTOR" SYMBOLS TO GO FROM PAGE TO PAGE.

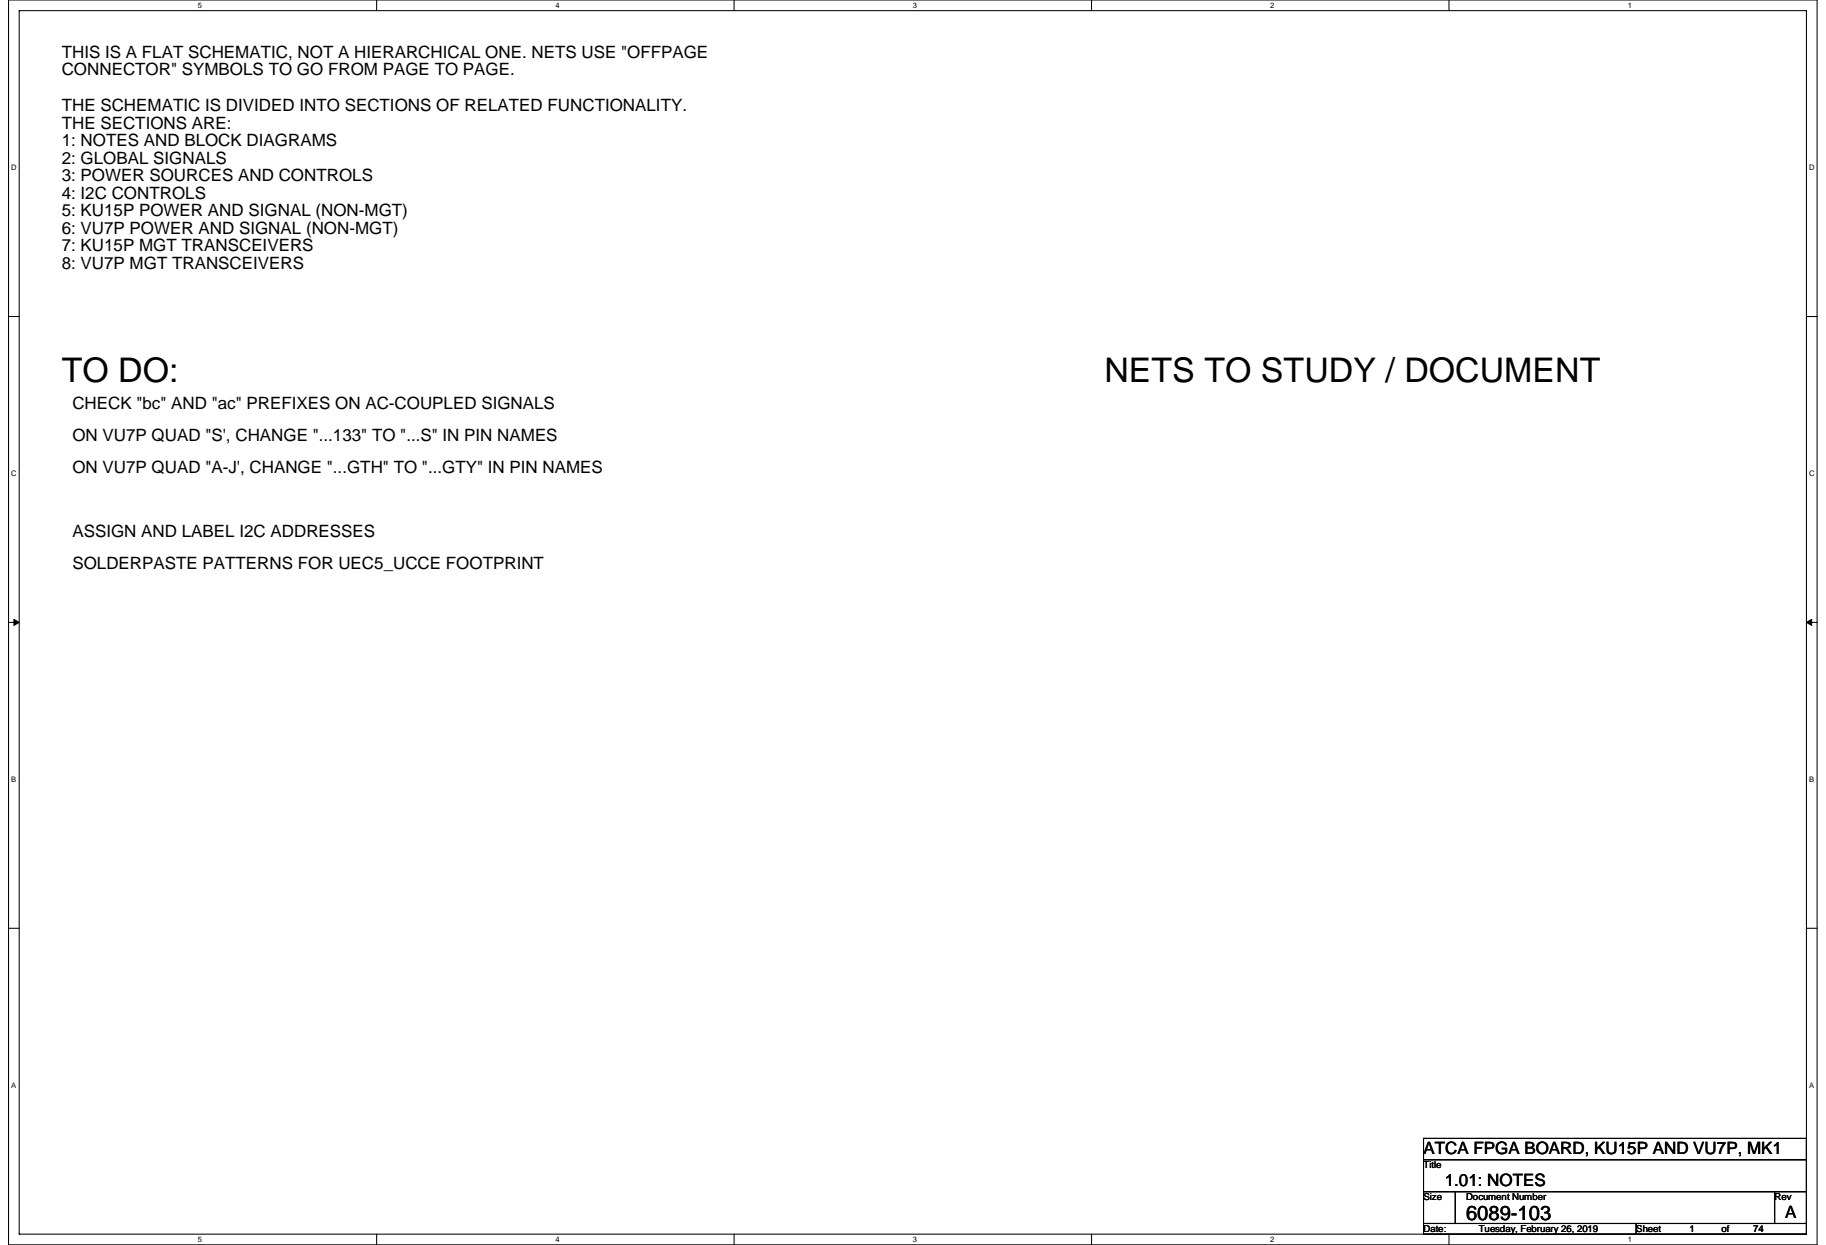
[picture p31: page 1]

THE SCHEMATIC IS DIVIDED INTO SECTIONS OF RELATED FUNCTIONALITY.
THE SECTIONS ARE:
1: NOTES AND BLOCK DIAGRAMS
2: GLOBAL SIGNALS
3: POWER SOURCES AND CONTROLS
4: I2C CONTROLS
5: KU15P POWER AND SIGNAL (NON-MGT)
6: VU7P POWER AND SIGNAL (NON-MGT)
7: KU15P MGT TRANSCEIVERS
8: VU7P MGT TRANSCEIVERS

C | TO DO: NETS TO STUDY / DOCUMENT CHECK "bc" AND "ac" PREFIXES ON AC-COUPLED SIGNALS ON VU7P QUAD "S', CHANGE "...133" TO "...S" IN PIN NAMES ON VU7P QUAD "A-J', CHANGE "...GTH" TO "...GTY" IN PIN NAMES ASSIGN AND LABEL I2C ADDRESSES SOLDERPASTE PATTERNS FOR UEC5_UCCE FOOTPRINT | C

ATCA FPGA BOARD, KU15P AND VU7P, MK1 Title 1.01: NOTES 1.01: NOTES 1.01: NOTES Size Document Number Rev 6089-103 A Date: Tuesday, February 26, 2019 Tuesday, February 26, 2019 Tuesday, February 26, 2019 Sheet 1 1 1 of 74 74 74

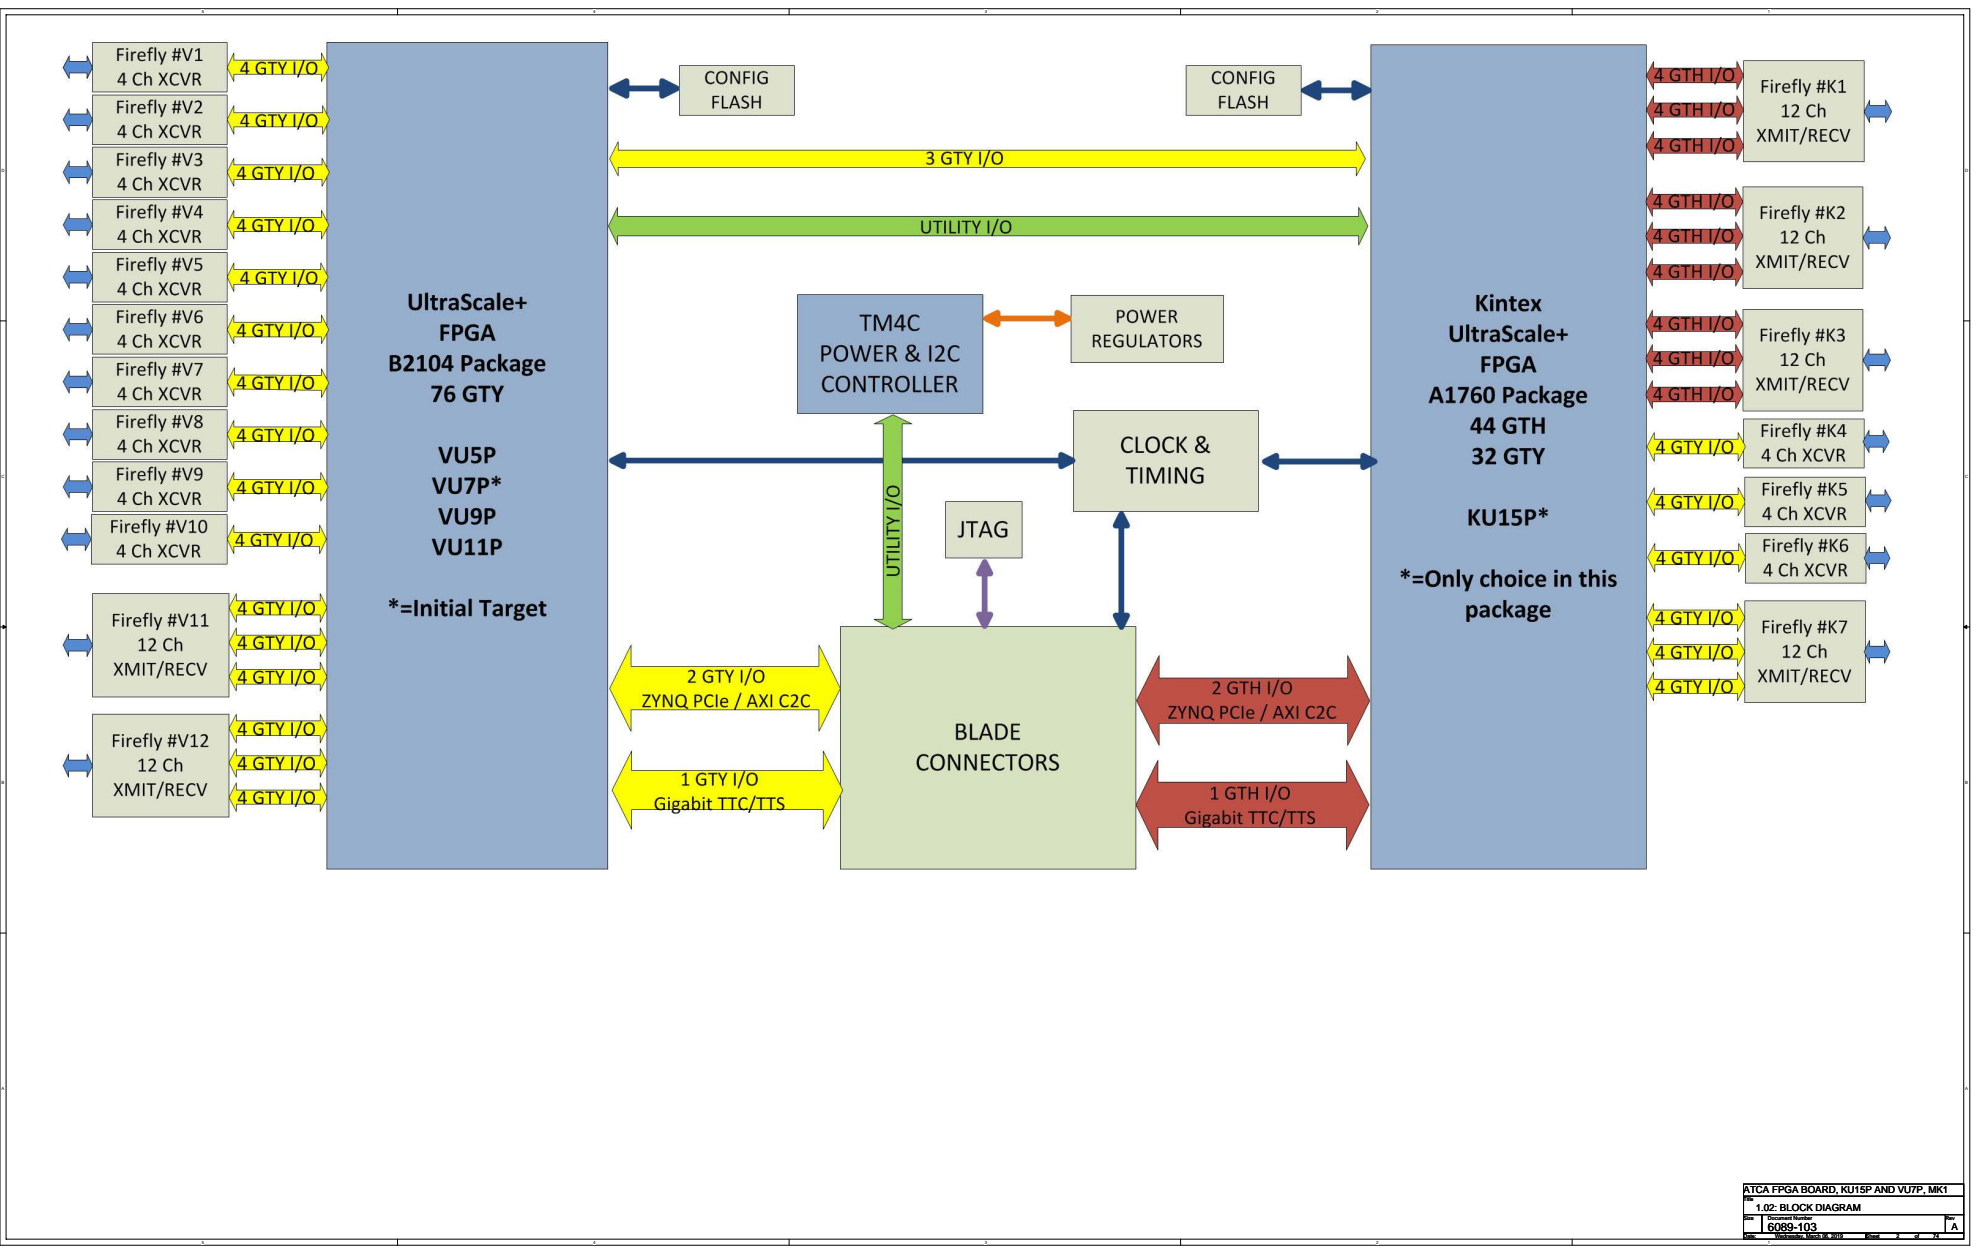
[picture p32: page 2]
1.02: BLOCK DIAGRAM; Wednesday, March 06, 2019

# FIREFLY #K1 12-PORT

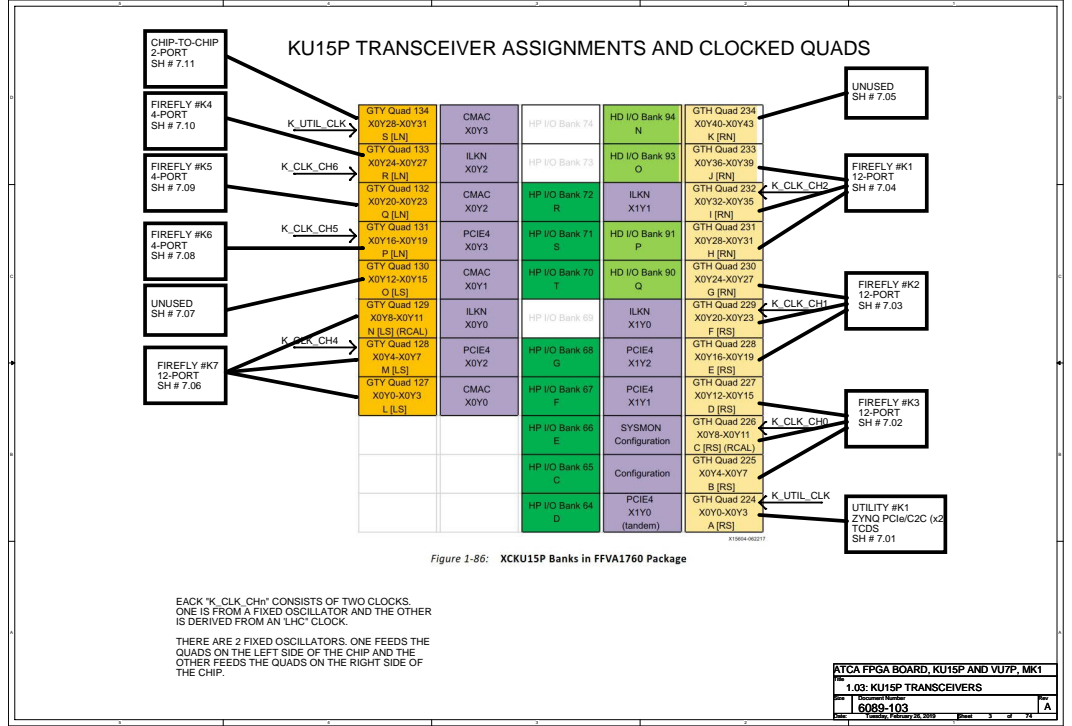
[picture p33: page 3]
FIREFLY #K4 4-PORT SH # 7.10; FIREFLY #K5 4-PORT; UNUSED SH # 7.05; K_CLK_CH2; K_UTIL_CLK; K_CLK_CH6

CHIP-TO-CHIP
2-PORT

KU15P TRANSCEIVER ASSIGNMENTS AND CLOCKED QUADS

C | SH # 7.09 SH # 7.04 K_CLK_CH5 FIREFLY #K6 4-PORT SH # 7.08 FIREFLY #K2 12-PORT UNUSED K_CLK_CH1 SH # 7.03 SH # 7.07 K_CLK_CH4 | C

B | FIREFLY #K7 12-PORT SH # 7.06 FIREFLY #K3 12-PORT K_CLK_CH0 SH # 7.02 K_UTIL_CLK UTILITY #K1 ZYNQ PCIe/C2C (x2) TCDS SH # 7.01 | B

EACK "K_CLK_CHn" CONSISTS OF TWO CLOCKS. ONE IS FROM A FIXED OSCILLATOR AND THE OTHER IS DERIVED FROM AN 'LHC" CLOCK. THERE ARE 2 FIXED OSCILLATORS. ONE FEEDS THE QUADS ON THE LEFT SIDE OF THE CHIP AND THE OTHER FEEDS THE QUADS ON THE RIGHT SIDE OF THE CHIP. 1.03: KU15P TRANSCEIVERS 1.03: KU15P TRANSCEIVERS 1.03: KU15P TRANSCEIVERS Tuesday, February 26, 2019 Tuesday, February 26, 2019 Tuesday, February 26, 2019 3 3 3 74 74 74

# VU7P TRANSCEIVER ASSIGNMENTS AND CLOCKED QUADS

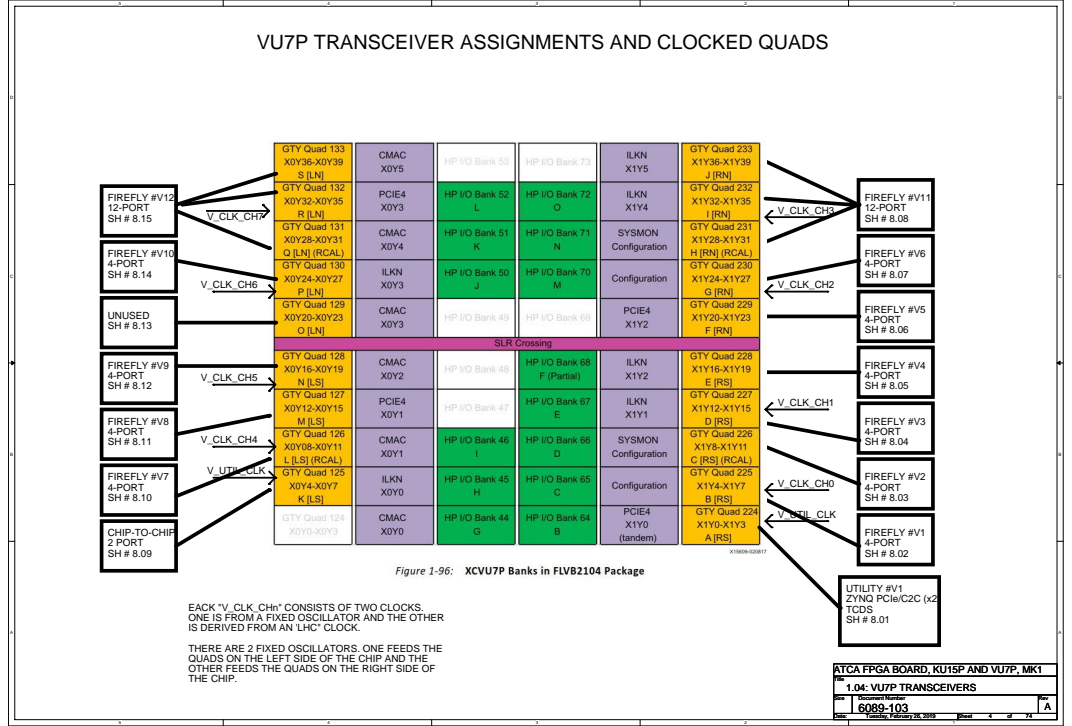
[picture p34: page 4]
4-PORT; 2 PORT

C | FIREFLY #V12 FIREFLY #V11 12-PORT V_CLK_CH3 12-PORT SH # 8.15 V_CLK_CH7 SH # 8.08 FIREFLY #V10 FIREFLY #V6 4-PORT 4-PORT SH # 8.14 SH # 8.07 V_CLK_CH6 V_CLK_CH2 FIREFLY #V5 UNUSED 4-PORT SH # 8.13 SH # 8.06 | C

B | FIREFLY #V9 FIREFLY #V4 4-PORT V_CLK_CH5 4-PORT SH # 8.12 SH # 8.05 V_CLK_CH1 FIREFLY #V8 FIREFLY #V3 4-PORT 4-PORT V_CLK_CH4 SH # 8.11 SH # 8.04 V_UTIL_CLK FIREFLY #V7 FIREFLY #V2 V_CLK_CH0 4-PORT 4-PORT SH # 8.10 SH # 8.03 V_UTIL_CLK CHIP-TO-CHIP FIREFLY #V1 | B

SH # 8.09 SH # 8.02 UTILITY #V1 ZYNQ PCIe/C2C (x2) EACK "V_CLK_CHn" CONSISTS OF TWO CLOCKS. TCDS ONE IS FROM A FIXED OSCILLATOR AND THE OTHER SH # 8.01 IS DERIVED FROM AN 'LHC" CLOCK. THERE ARE 2 FIXED OSCILLATORS. ONE FEEDS THE QUADS ON THE LEFT SIDE OF THE CHIP AND THE OTHER FEEDS THE QUADS ON THE RIGHT SIDE OF THE CHIP. 1.04: VU7P TRANSCEIVERS 1.04: VU7P TRANSCEIVERS 1.04: VU7P TRANSCEIVERS Tuesday, February 26, 2019 Tuesday, February 26, 2019 Tuesday, February 26, 2019 4 4 4 74 74 74

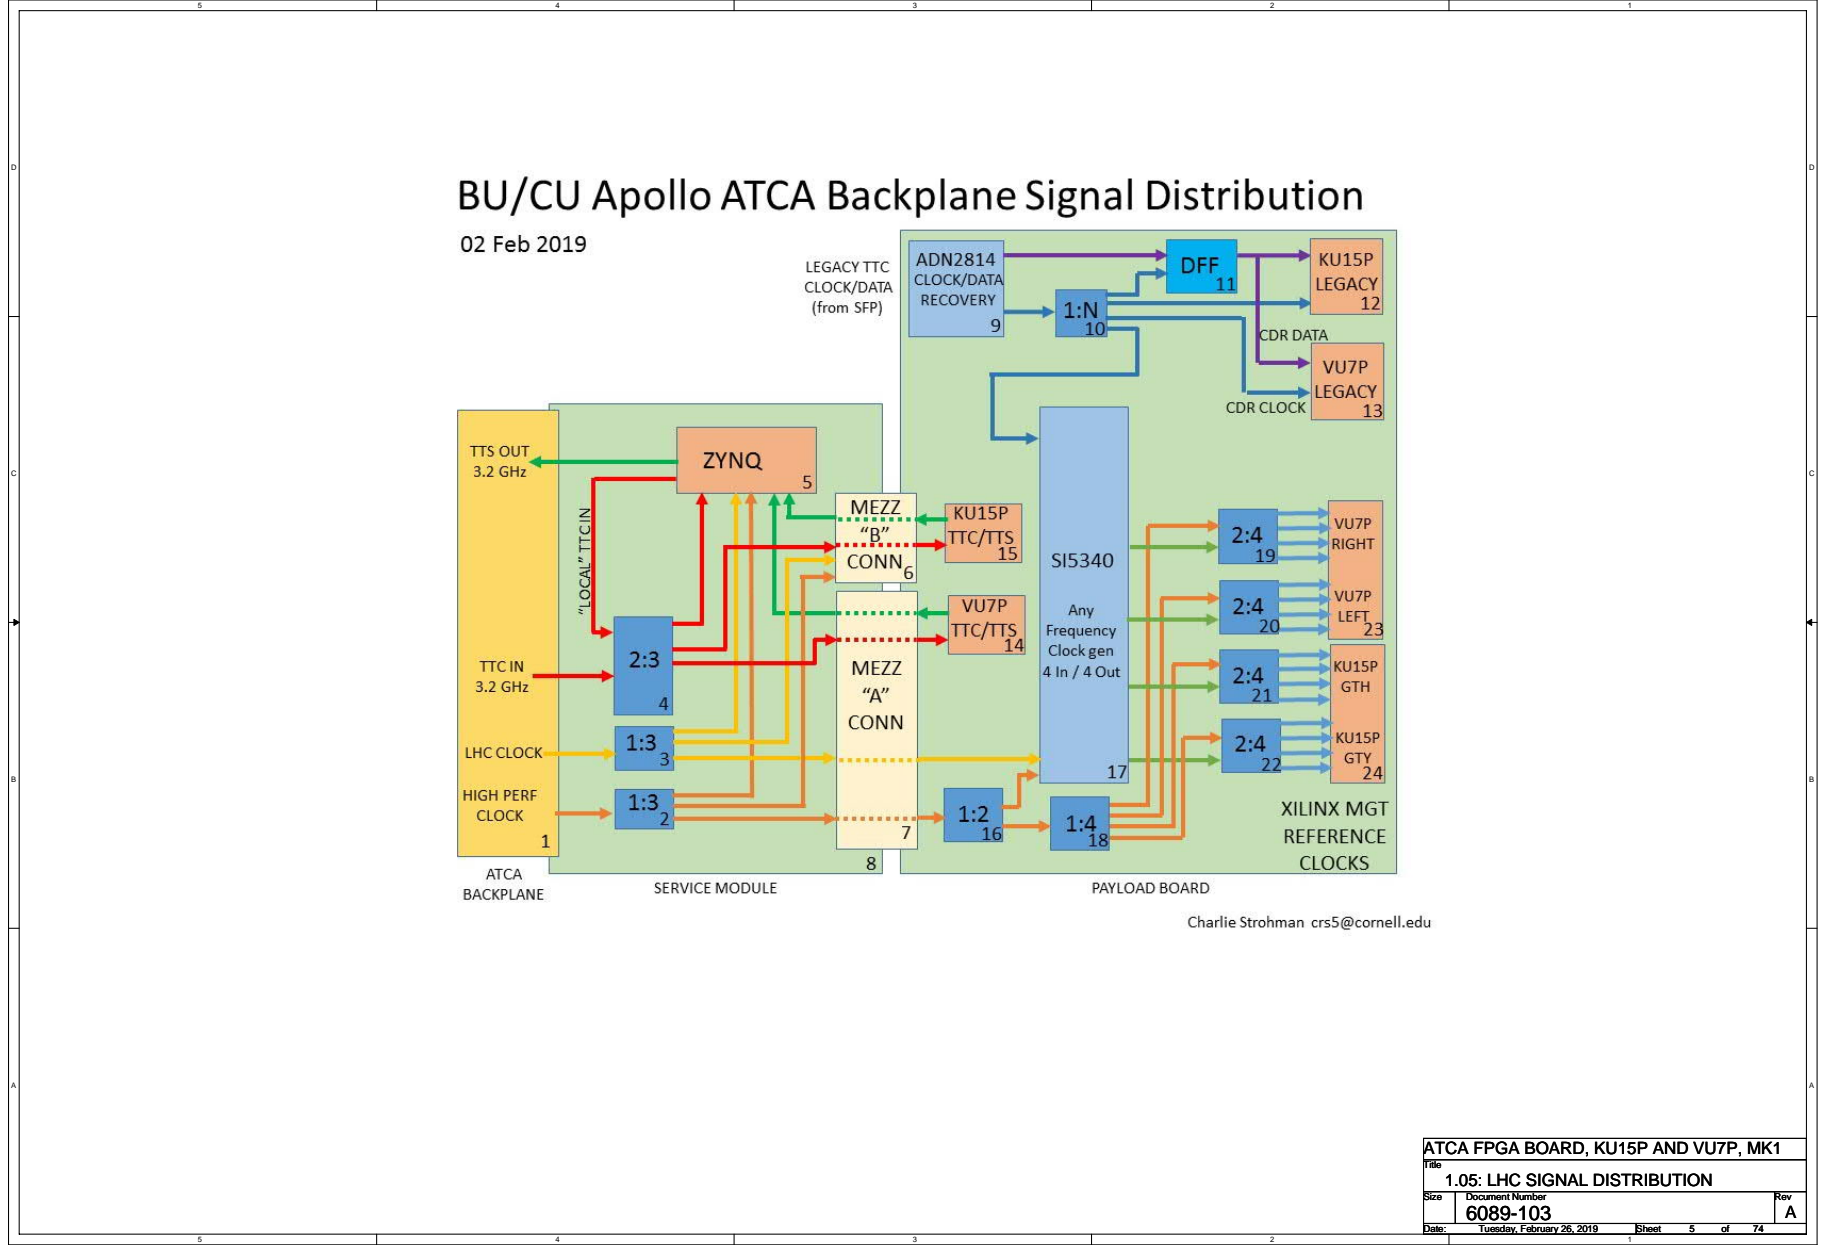
[picture p35: page 5]

1.05: LHC SIGNAL DISTRIBUTION 1.05: LHC SIGNAL DISTRIBUTION 1.05: LHC SIGNAL DISTRIBUTION Tuesday, February 26, 2019 Tuesday, February 26, 2019 Tuesday, February 26, 2019 5 5 5 74 74 74

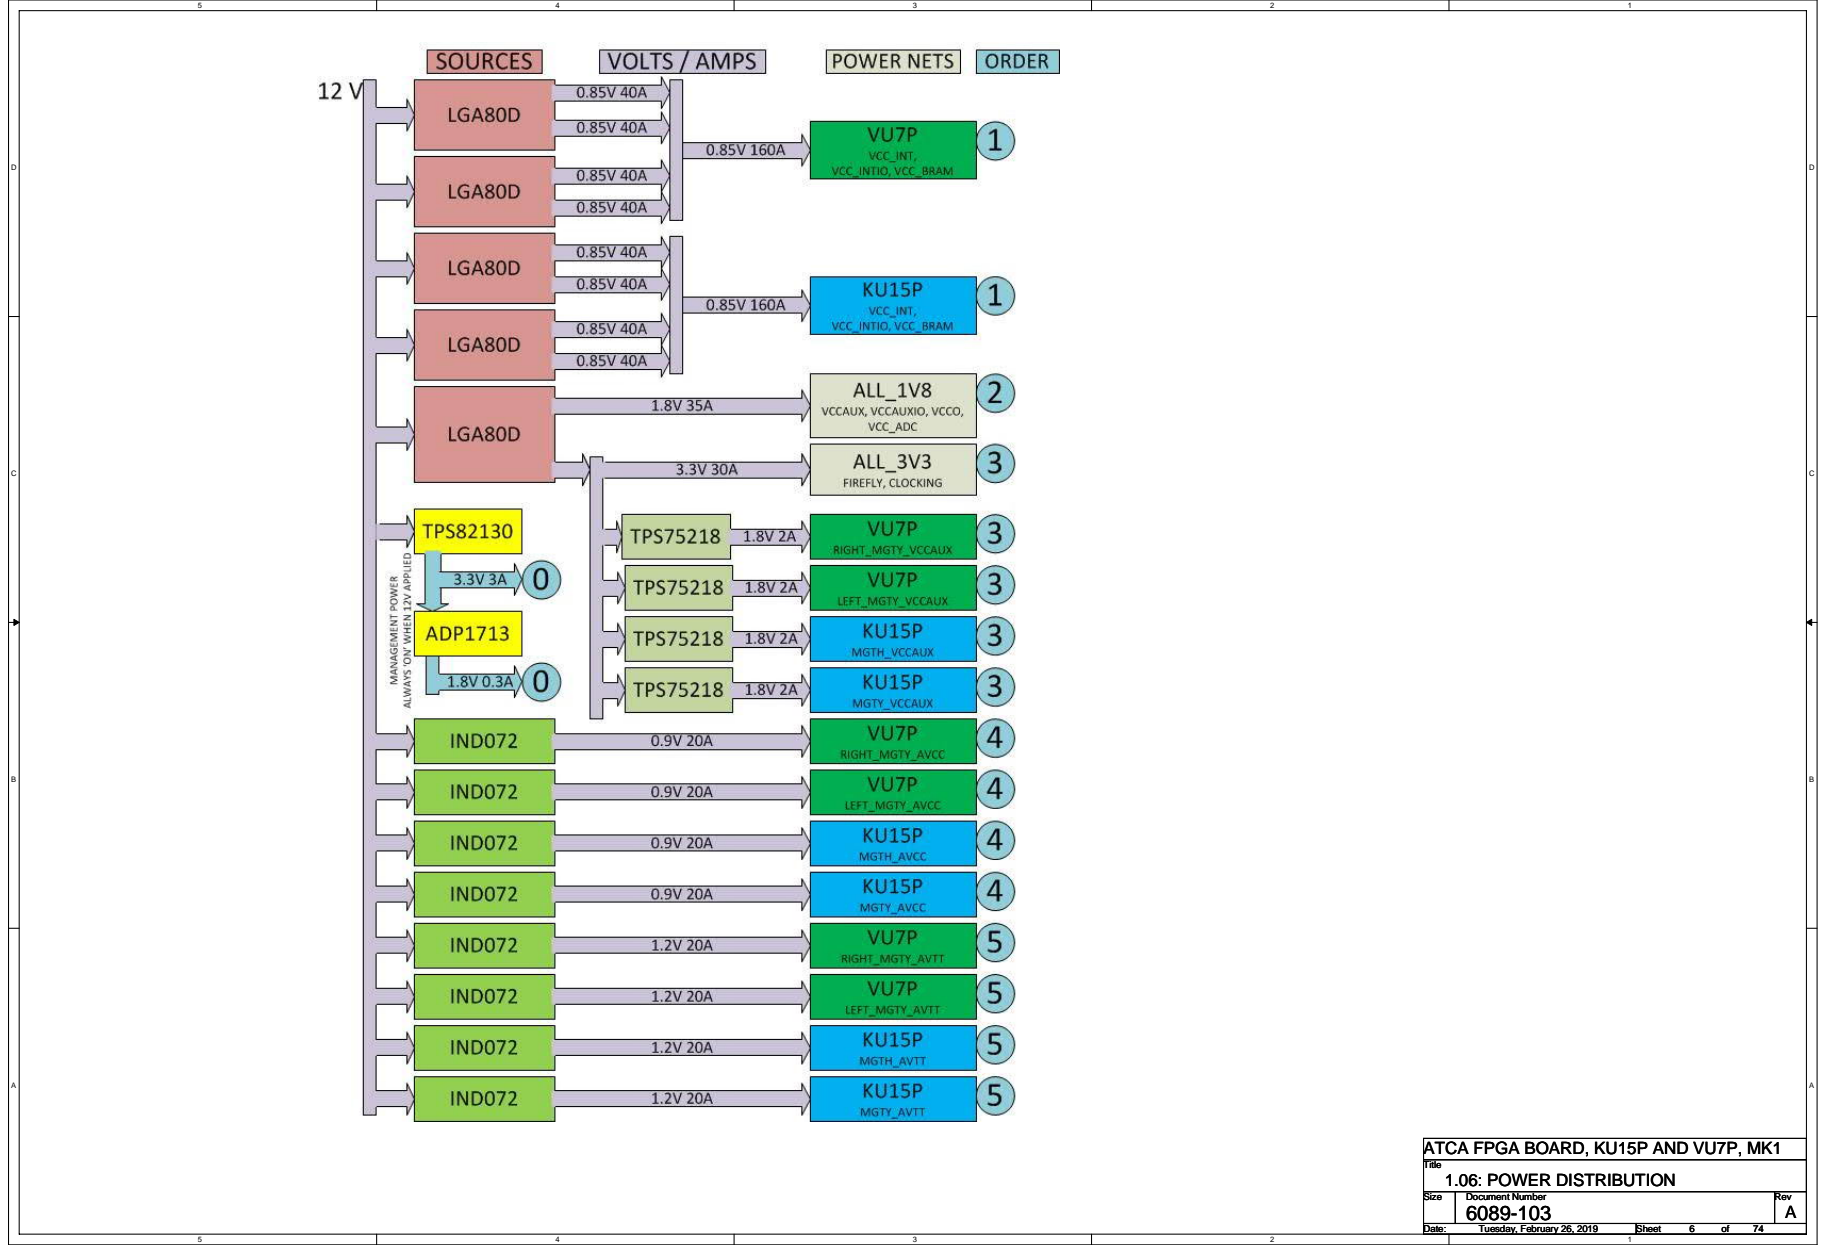
[picture p36: page 6]

1.06: POWER DISTRIBUTION 1.06: POWER DISTRIBUTION 1.06: POWER DISTRIBUTION Tuesday, February 26, 2019 Tuesday, February 26, 2019 Tuesday, February 26, 2019 6 6 6 74 74 74

## Bench Top Power Inlet

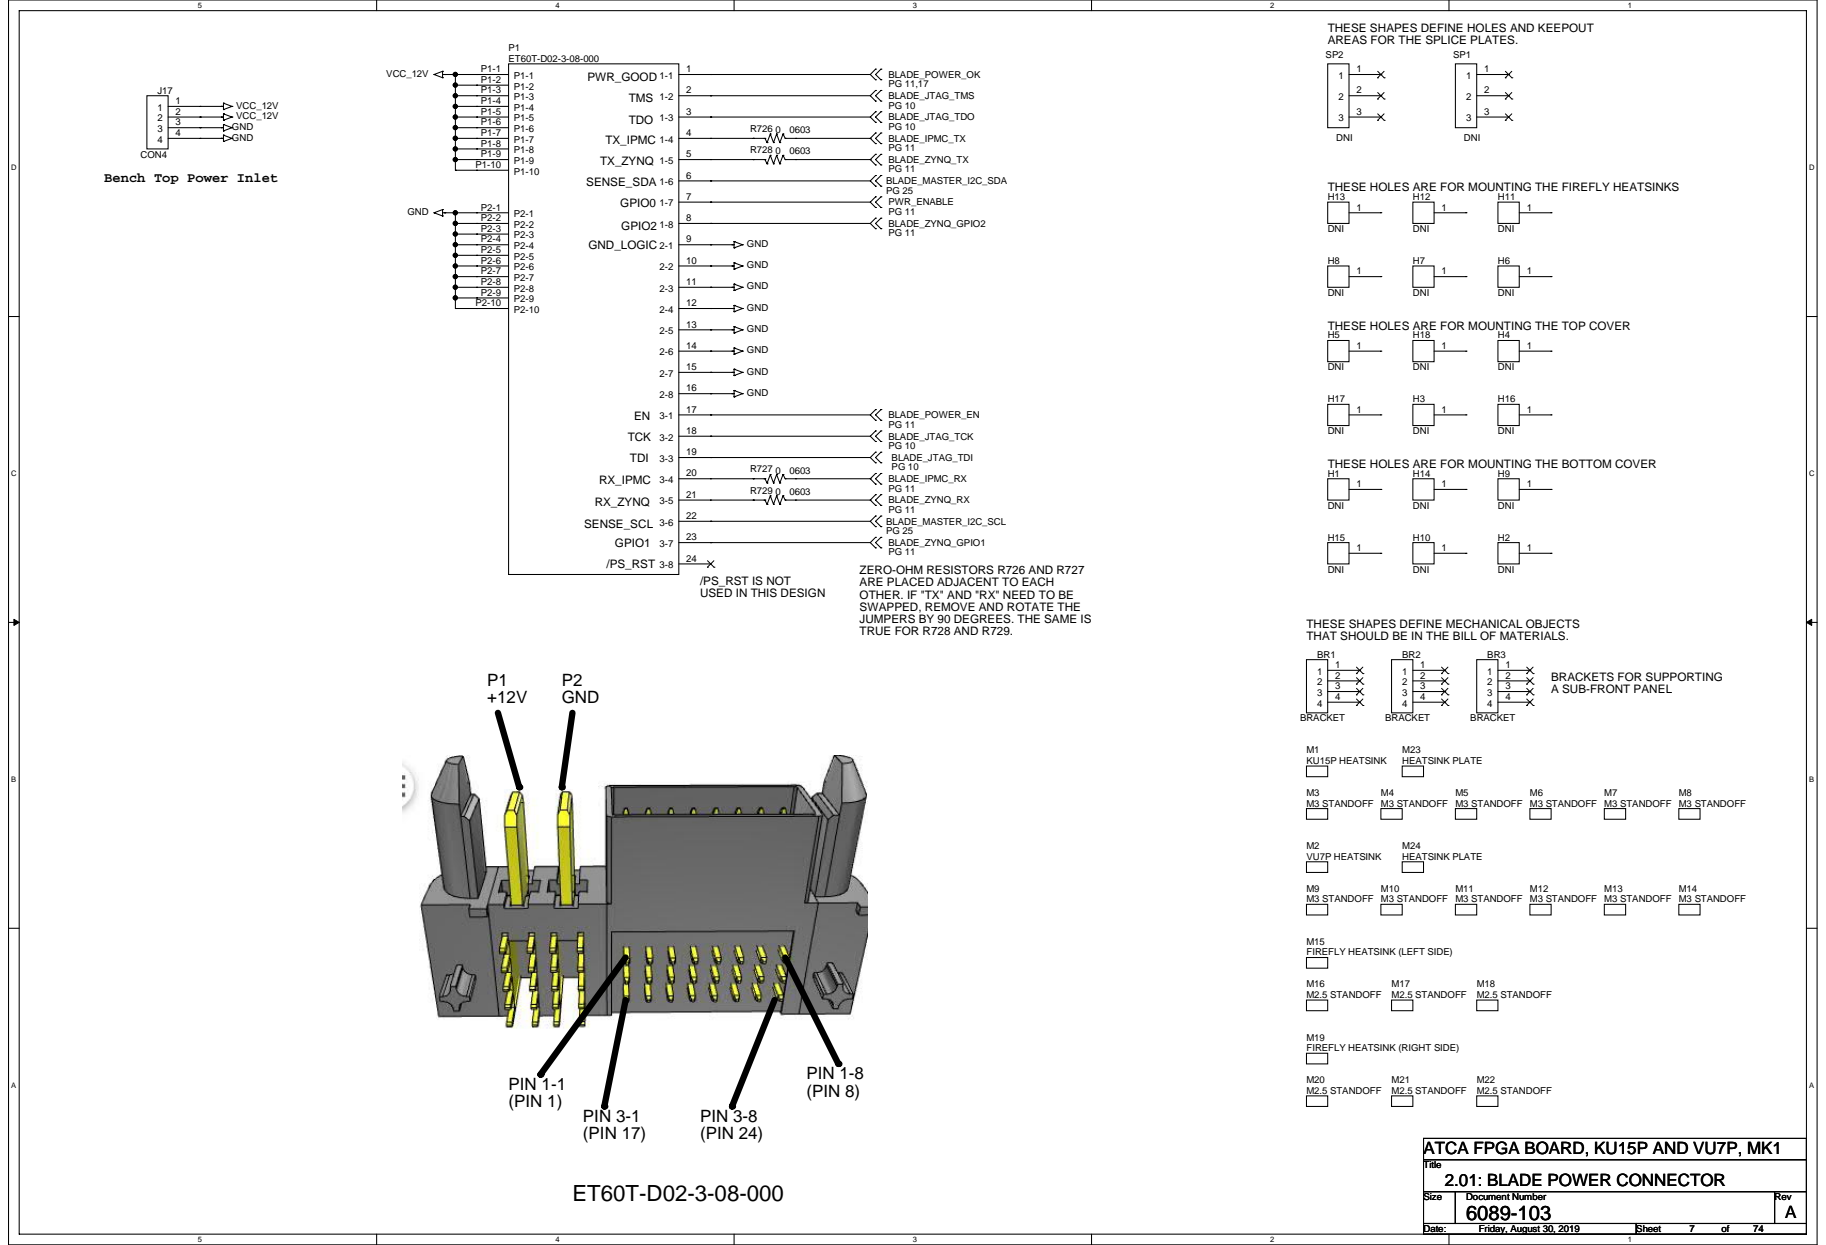
[picture p37: page 7]
SENSE_SCL; TMS; TDO; TCK; TDI; PWR_GOOD; SENSE_SDA; TX_IPMC; TX_ZYNQ; GPIO0; GPIO2; RX_IPMC; RX_ZYNQ; GPIO1; /PS_RST; GND_LOGIC; VCC_12V; GND; BLADE_POWER_OK PG 11,17 BLADE_JTAG_TMS PG 10 BLADE_JTAG_TDO PG 10 BLADE_IPMC_TX PG 11 BLADE_ZYNQ_TX PG 11 BLADE_MASTER_I2C_SDA PG 25 PWR_ENABLE PG 11 BLADE_ZYNQ_GPIO2 PG 11; DNI; CON4

THESE SHAPES DEFINE HOLES AND KEEPOUT
AREAS FOR THE SPLICE PLATES.

THESE HOLES ARE FOR MOUNTING THE FIREFLY HEATSINKS

THESE HOLES ARE FOR MOUNTING THE TOP COVER

BLADE_POWER_EN
BLADE_JTAG_TCK
BLADE_JTAG_TDI
BLADE_IPMC_RX
BLADE_ZYNQ_RX
BLADE_MASTER_I2C_SCL
BLADE_ZYNQ_GPIO1
ZERO-OHM RESISTORS R726 AND R727
ARE PLACED ADJACENT TO EACH
OTHER. IF "TX" AND "RX" NEED TO BE
SWAPPED, REMOVE AND ROTATE THE
JUMPERS BY 90 DEGREES. THE SAME IS

THESE HOLES ARE FOR MOUNTING THE BOTTOM COVER

/PS_RST IS NOT
USED IN THIS DESIGN

THESE SHAPES DEFINE MECHANICAL OBJECTS

B | TRUE FOR R728 AND R729. THAT SHOULD BE IN THE BILL OF MATERIALS. BR1 BR2 BR3 1 1 1 1 1 1 P1 P2 2 2 2 BRACKETS FOR SUPPORTING 2 2 2 3 3 3 A SUB-FRONT PANEL +12V GND 3 3 3 4 4 4 4 4 4 BRACKET BRACKET BRACKET M1 M23 KU15P HEATSINK HEATSINK PLATE M3 M4 M5 M6 M7 M8 M3 STANDOFF M3 STANDOFF M3 STANDOFF M3 STANDOFF M3 STANDOFF M3 STANDOFF M2 M24 VU7P HEATSINK HEATSINK PLATE M9 M10 M11 M12 M13 M14 M3 STANDOFF M3 STANDOFF M3 STANDOFF M3 STANDOFF M3 STANDOFF M3 STANDOFF | B

M15 FIREFLY HEATSINK (LEFT SIDE) M16 M17 M18 M2.5 STANDOFF M2.5 STANDOFF M2.5 STANDOFF M19 FIREFLY HEATSINK (RIGHT SIDE) PIN 1-8 PIN 1-1 M20 M21 M22 (PIN 8) M2.5 STANDOFF M2.5 STANDOFF M2.5 STANDOFF (PIN 1) PIN 3-1 PIN 3-8 (PIN 17) (PIN 24) 2.01: BLADE POWER CONNECTOR 2.01: BLADE POWER CONNECTOR 2.01: BLADE POWER CONNECTOR ET60T-D02-3-08-000 Friday, August 30, 2019 Friday, August 30, 2019 Friday, August 30, 2019 7 7 7 74 74 74

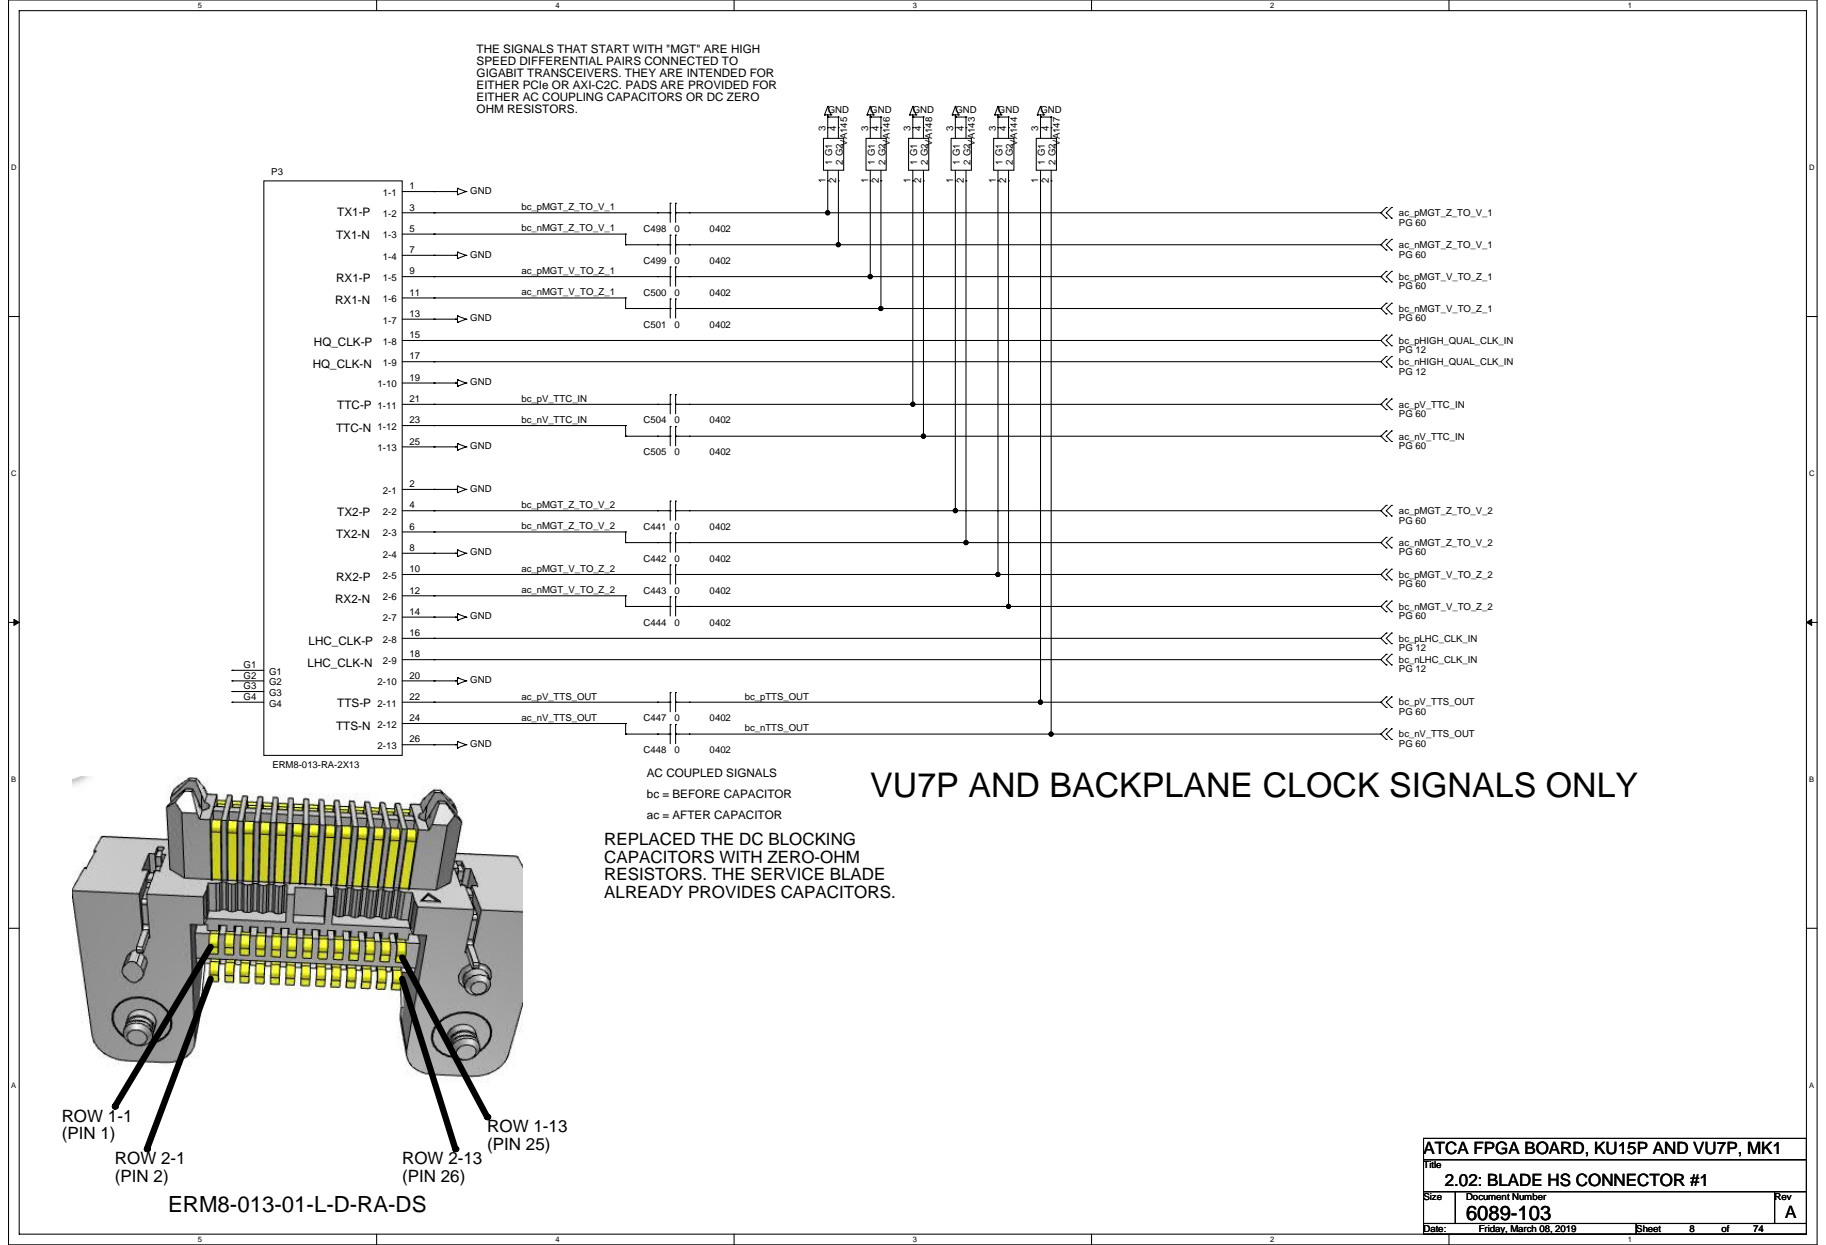
[picture p38: page 8]

THE SIGNALS THAT START WITH "MGT" ARE HIGH
SPEED DIFFERENTIAL PAIRS CONNECTED TO
GIGABIT TRANSCEIVERS. THEY ARE INTENDED FOR
EITHER PCIe OR AXI-C2C. PADS ARE PROVIDED FOR
EITHER AC COUPLING CAPACITORS OR DC ZERO
OHM RESISTORS.

AC COUPLED SIGNALS
bc = BEFORE CAPACITOR
ac = AFTER CAPACITOR
REPLACED THE DC BLOCKING
CAPACITORS WITH ZERO-OHM
RESISTORS. THE SERVICE BLADE
ALREADY PROVIDES CAPACITORS.

VU7P AND BACKPLANE CLOCK SIGNALS ONLY

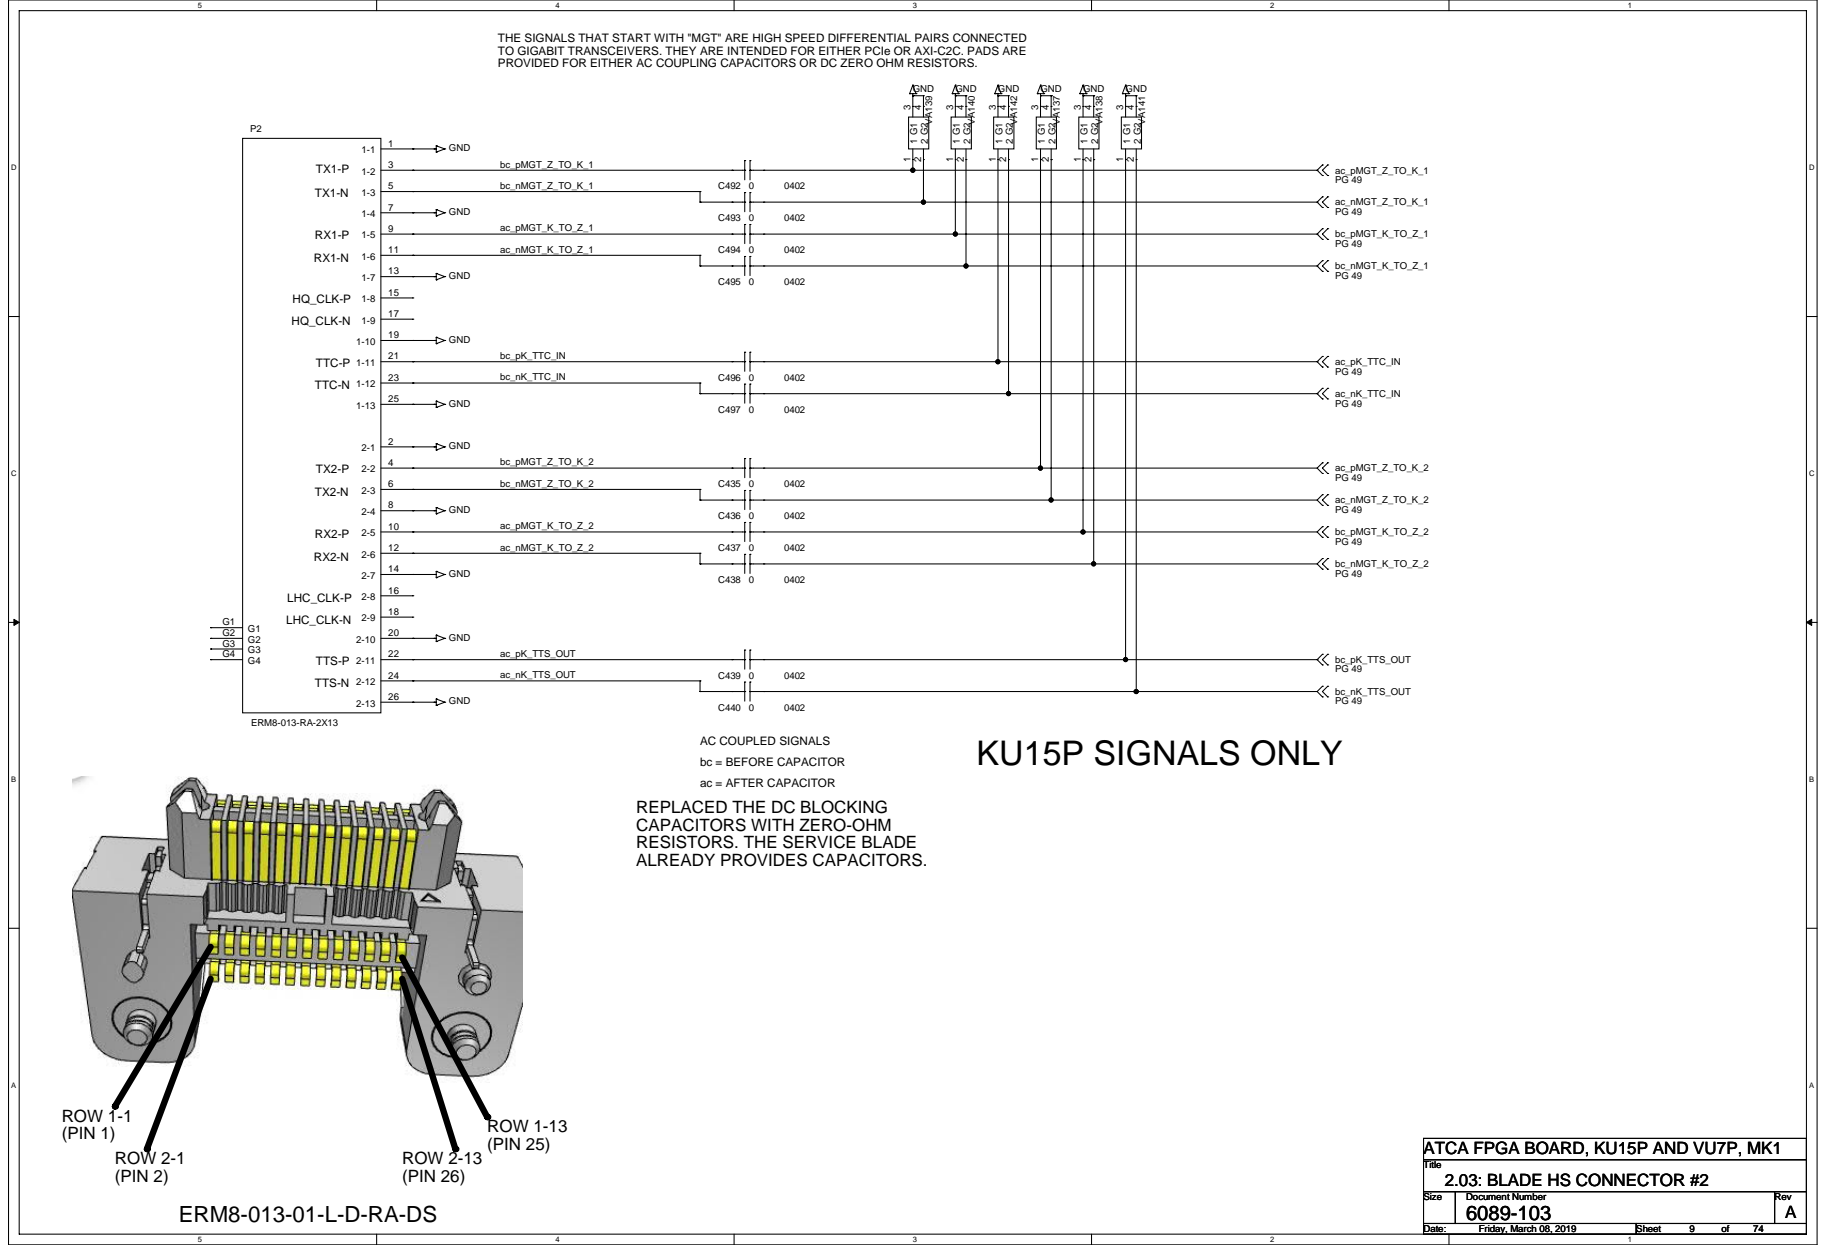
[picture p39: page 9]
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

REPLACED THE DC BLOCKING
CAPACITORS WITH ZERO-OHM
RESISTORS. THE SERVICE BLADE
ALREADY PROVIDES CAPACITORS.

# BLADE JTAG

# BLADE JTAG

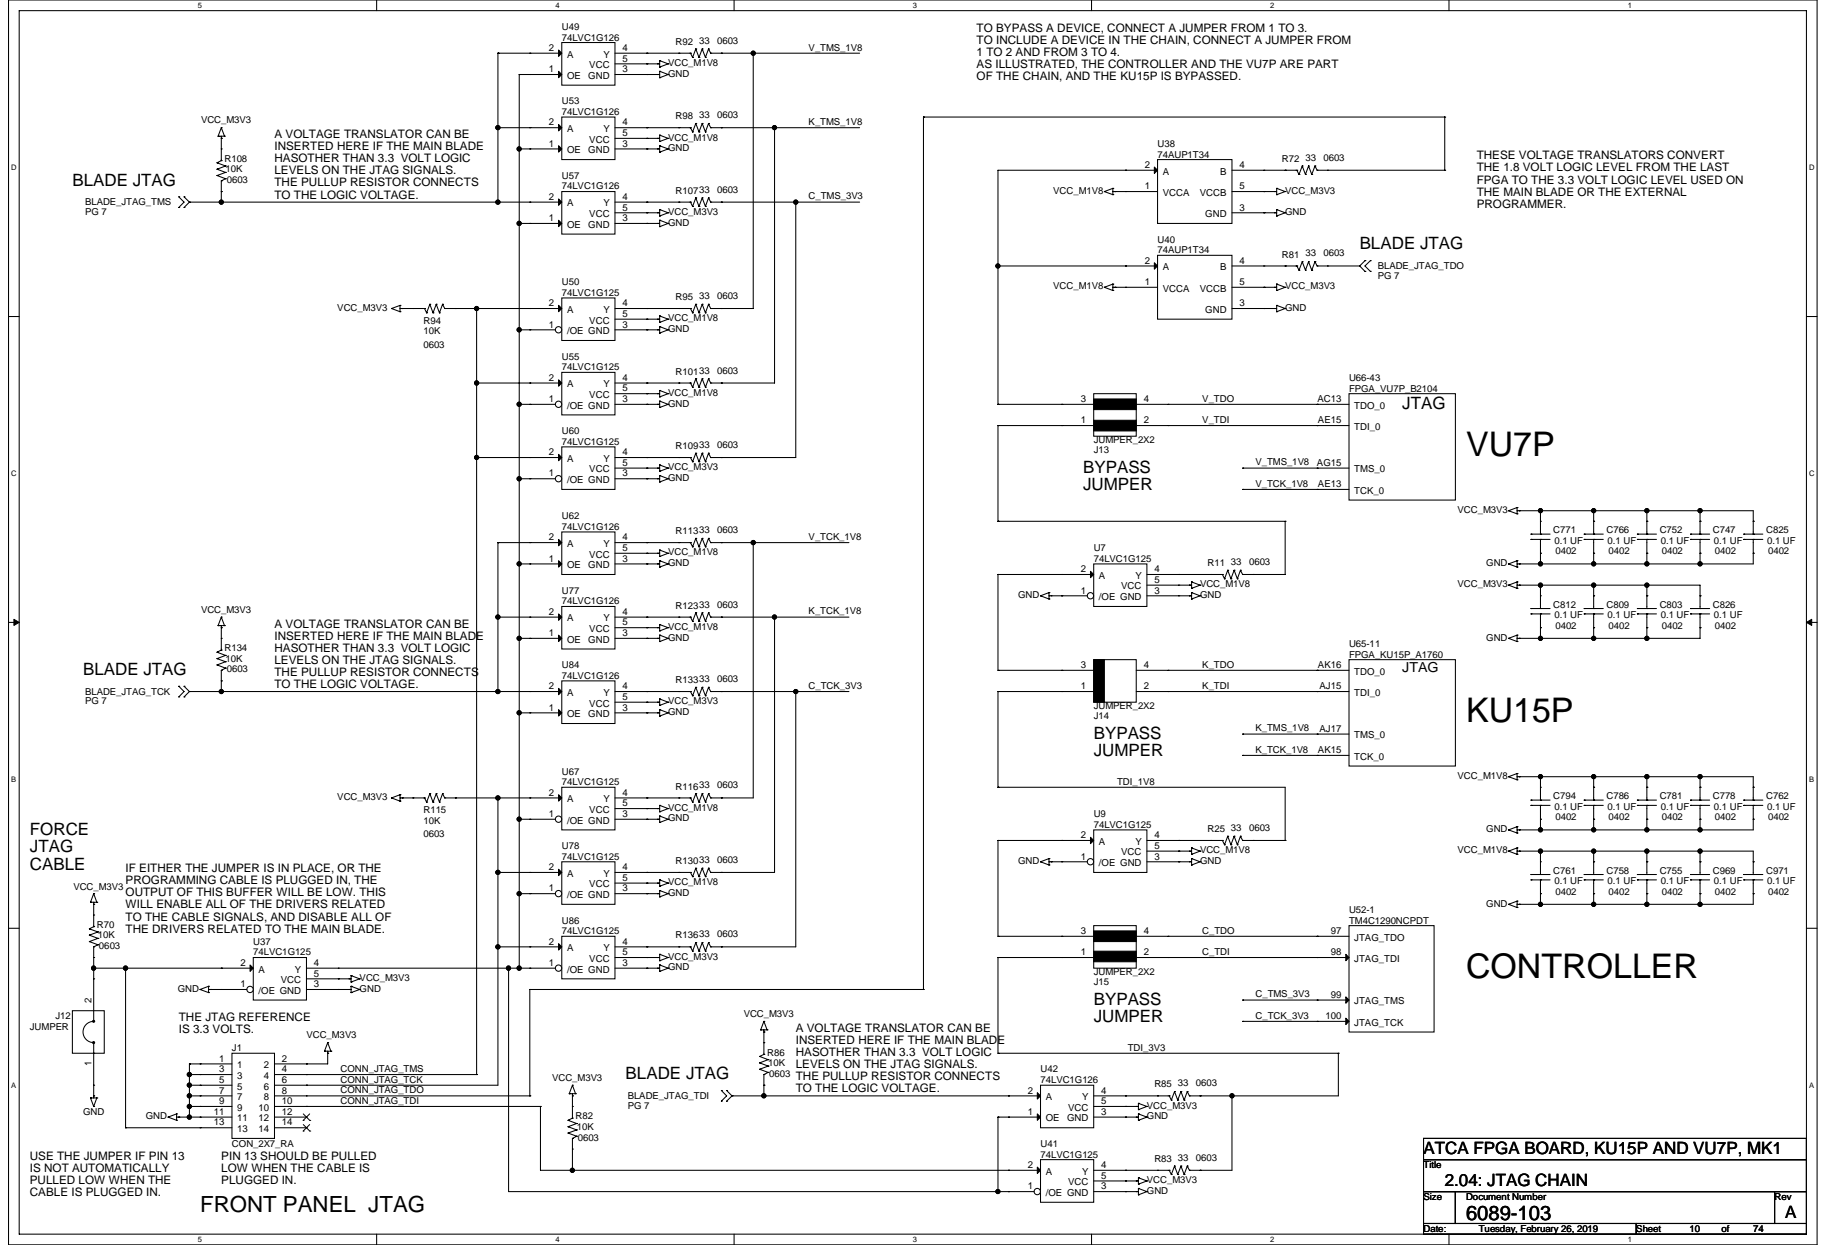
[picture p40: page 10]

TO BYPASS A DEVICE, CONNECT A JUMPER FROM 1 TO 3.
TO INCLUDE A DEVICE IN THE CHAIN, CONNECT A JUMPER FROM
1 TO 2 AND FROM 3 TO 4.
AS ILLUSTRATED, THE CONTROLLER AND THE VU7P ARE PART
OF THE CHAIN, AND THE KU15P IS BYPASSED.

A VOLTAGE TRANSLATOR CAN BE
INSERTED HERE IF THE MAIN BLADE
HASOTHER THAN 3.3 VOLT LOGIC
LEVELS ON THE JTAG SIGNALS.
THE PULLUP RESISTOR CONNECTS
TO THE LOGIC VOLTAGE.

THESE VOLTAGE TRANSLATORS CONVERT
THE 1.8 VOLT LOGIC LEVEL FROM THE LAST
FPGA TO THE 3.3 VOLT LOGIC LEVEL USED ON
THE MAIN BLADE OR THE EXTERNAL
PROGRAMMER.

IF EITHER THE JUMPER IS IN PLACE, OR THE
PROGRAMMING CABLE IS PLUGGED IN, THE
OUTPUT OF THIS BUFFER WILL BE LOW. THIS
WILL ENABLE ALL OF THE DRIVERS RELATED
TO THE CABLE SIGNALS, AND DISABLE ALL OF
THE DRIVERS RELATED TO THE MAIN BLADE.

USE THE JUMPER IF PIN 13
IS NOT AUTOMATICALLY
PULLED LOW WHEN THE
CABLE IS PLUGGED IN.

CON_2X7_RA
PIN 13 SHOULD BE PULLED
LOW WHEN THE CABLE IS
PLUGGED IN.
FRONT PANEL JTAG

# TM4C UART

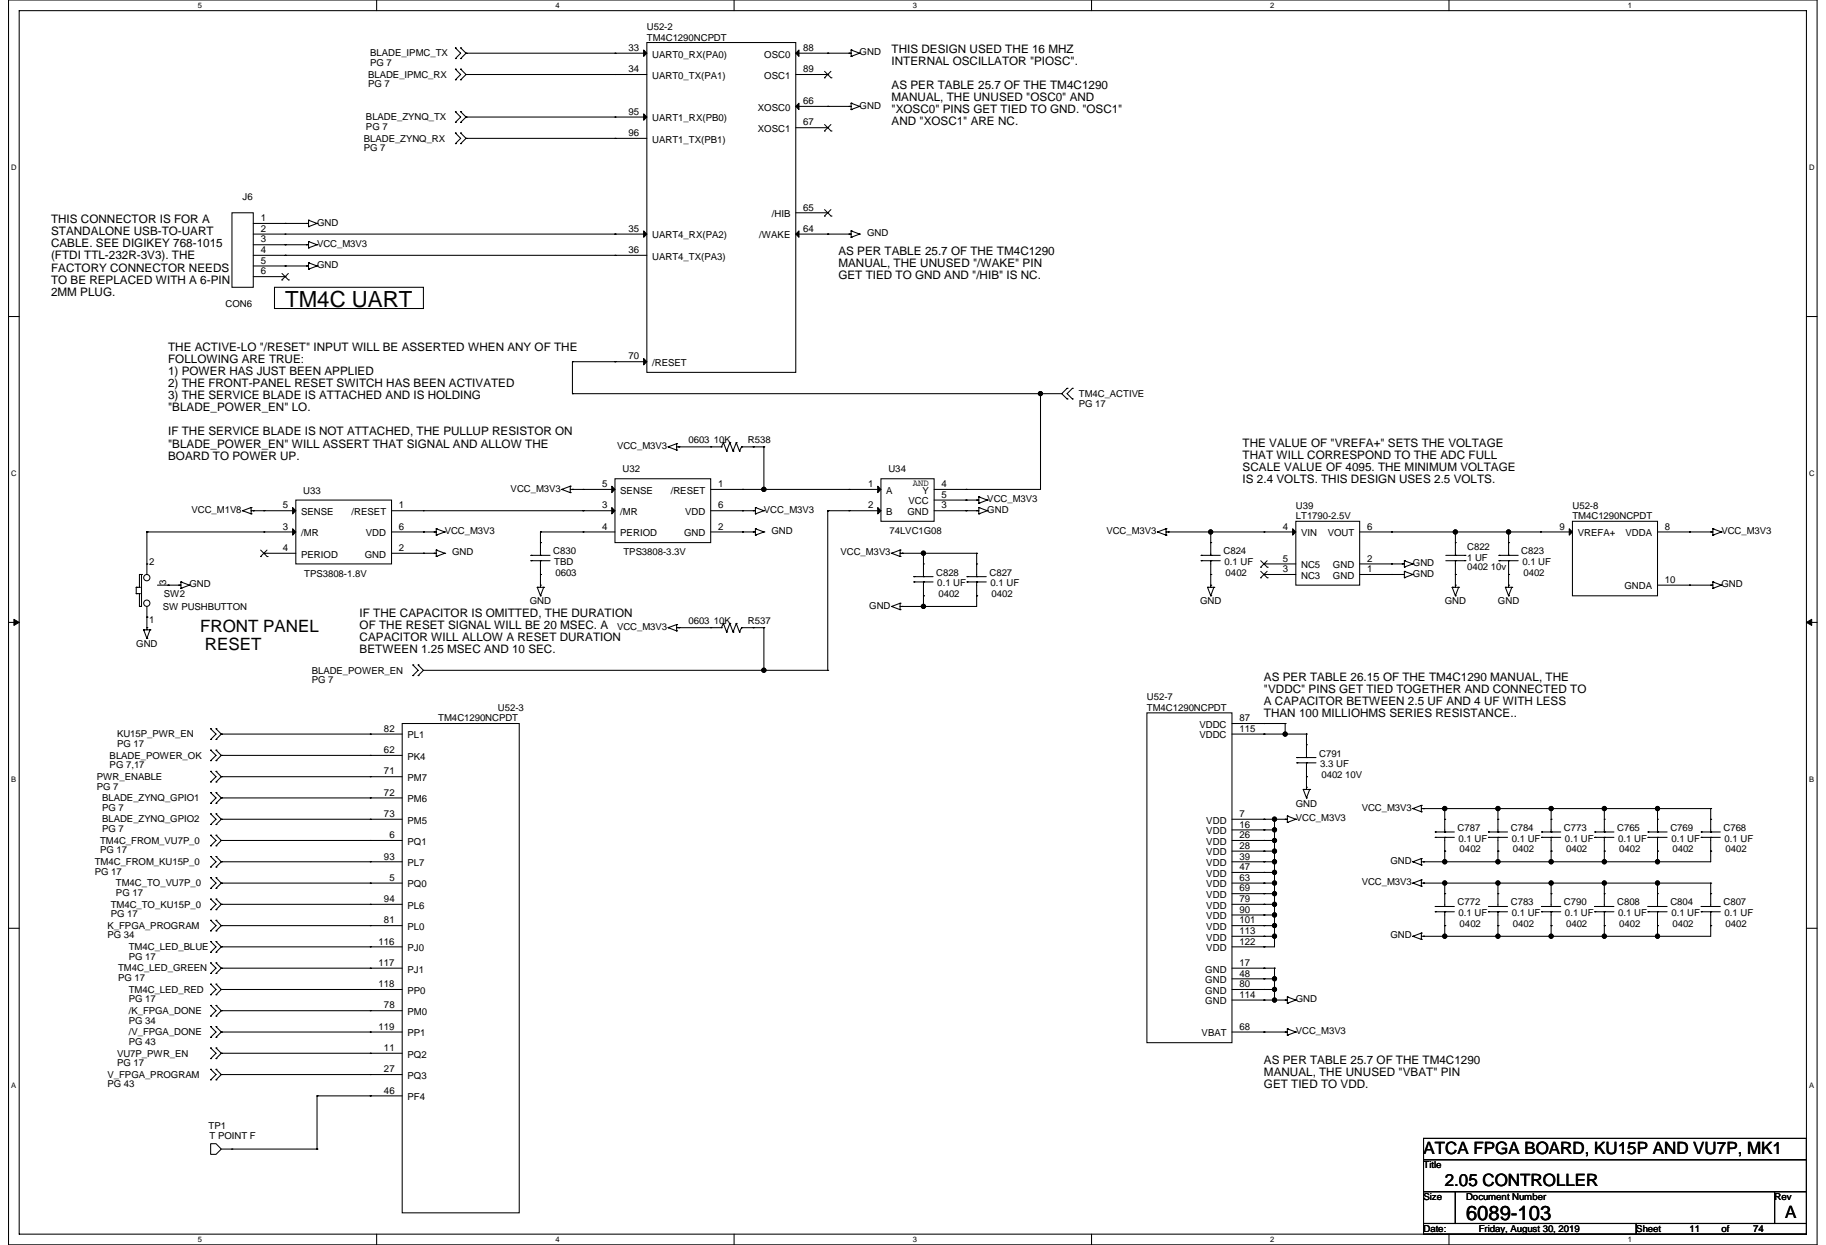
[picture p41: page 11]

THIS DESIGN USED THE 16 MHZ
GND
INTERNAL OSCILLATOR "PIOSC".
AS PER TABLE 25.7 OF THE TM4C1290
MANUAL, THE UNUSED "OSC0" AND
"XOSC0" PINS GET TIED TO GND. "OSC1"
AND "XOSC1" ARE NC.

THIS CONNECTOR IS FOR A
STANDALONE USB-TO-UART
CABLE. SEE DIGIKEY 768-1015
(FTDI TTL-232R-3V3). THE
FACTORY CONNECTOR NEEDS
TO BE REPLACED WITH A 6-PIN
2MM PLUG.

MANUAL, THE UNUSED "/WAKE" PIN
GET TIED TO GND AND "/HIB" IS NC.

C | THE ACTIVE-LO "/RESET" INPUT WILL BE ASSERTED WHEN ANY OF THE /RESET 70 FOLLOWING ARE TRUE: SENSE 5 /RESET 1 /MR 3 VDD 6 | VCC 5 VCC_M3V3 2 GND 3 | U39 U52-8 | C

1) POWER HAS JUST BEEN APPLIED
2) THE FRONT-PANEL RESET SWITCH HAS BEEN ACTIVATED
3) THE SERVICE BLADE IS ATTACHED AND IS HOLDING
"BLADE_POWER_EN" LO.
IF THE SERVICE BLADE IS NOT ATTACHED, THE PULLUP RESISTOR ON
"BLADE_POWER_EN" WILL ASSERT THAT SIGNAL AND ALLOW THE
BOARD TO POWER UP.

THE VALUE OF "VREFA+" SETS THE VOLTAGE
THAT WILL CORRESPOND TO THE ADC FULL
SCALE VALUE OF 4095. THE MINIMUM VOLTAGE
IS 2.4 VOLTS. THIS DESIGN USES 2.5 VOLTS.

IF THE CAPACITOR IS OMITTED, THE DURATION
OF THE RESET SIGNAL WILL BE 20 MSEC. A
CAPACITOR WILL ALLOW A RESET DURATION
BETWEEN 1.25 MSEC AND 10 SEC.

B | AS PER TABLE 26.15 OF THE TM4C1290 MANUAL, THE PG 7 "VDDC" PINS GET TIED TOGETHER AND CONNECTED TO U52-7 A CAPACITOR BETWEEN 2.5 UF AND 4 UF WITH LESS U52-3 TM4C1290NCPDT THAN 100 MILLIOHMS SERIES RESISTANCE.. TM4C1290NCPDT VDDC 87 PM6 72 BLADE_ZYNQ_GPIO1 GND | 3.3 UF | B

PG 17 PJ1 117 GND 17 PM0 78 /K_FPGA_DONE PG 34 PP1 119 VBAT 68 VCC_M3V3 /V_FPGA_DONE PG 43 PQ2 11 VU7P_PWR_EN AS PER TABLE 25.7 OF THE TM4C1290 PG 17 PQ3 27 MANUAL, THE UNUSED "VBAT" PIN V_FPGA_PROGRAM GET TIED TO VDD. PG 43 PF4 46 2.05 CONTROLLER 2.05 CONTROLLER 2.05 CONTROLLER Friday, August 30, 2019 Friday, August 30, 2019 Friday, August 30, 2019 11 11 11 74 74 74

1:2

| | | | DO WE NEED TO ADD A BUFFER U81-1 SI5340 R110 100 0402 SI53340

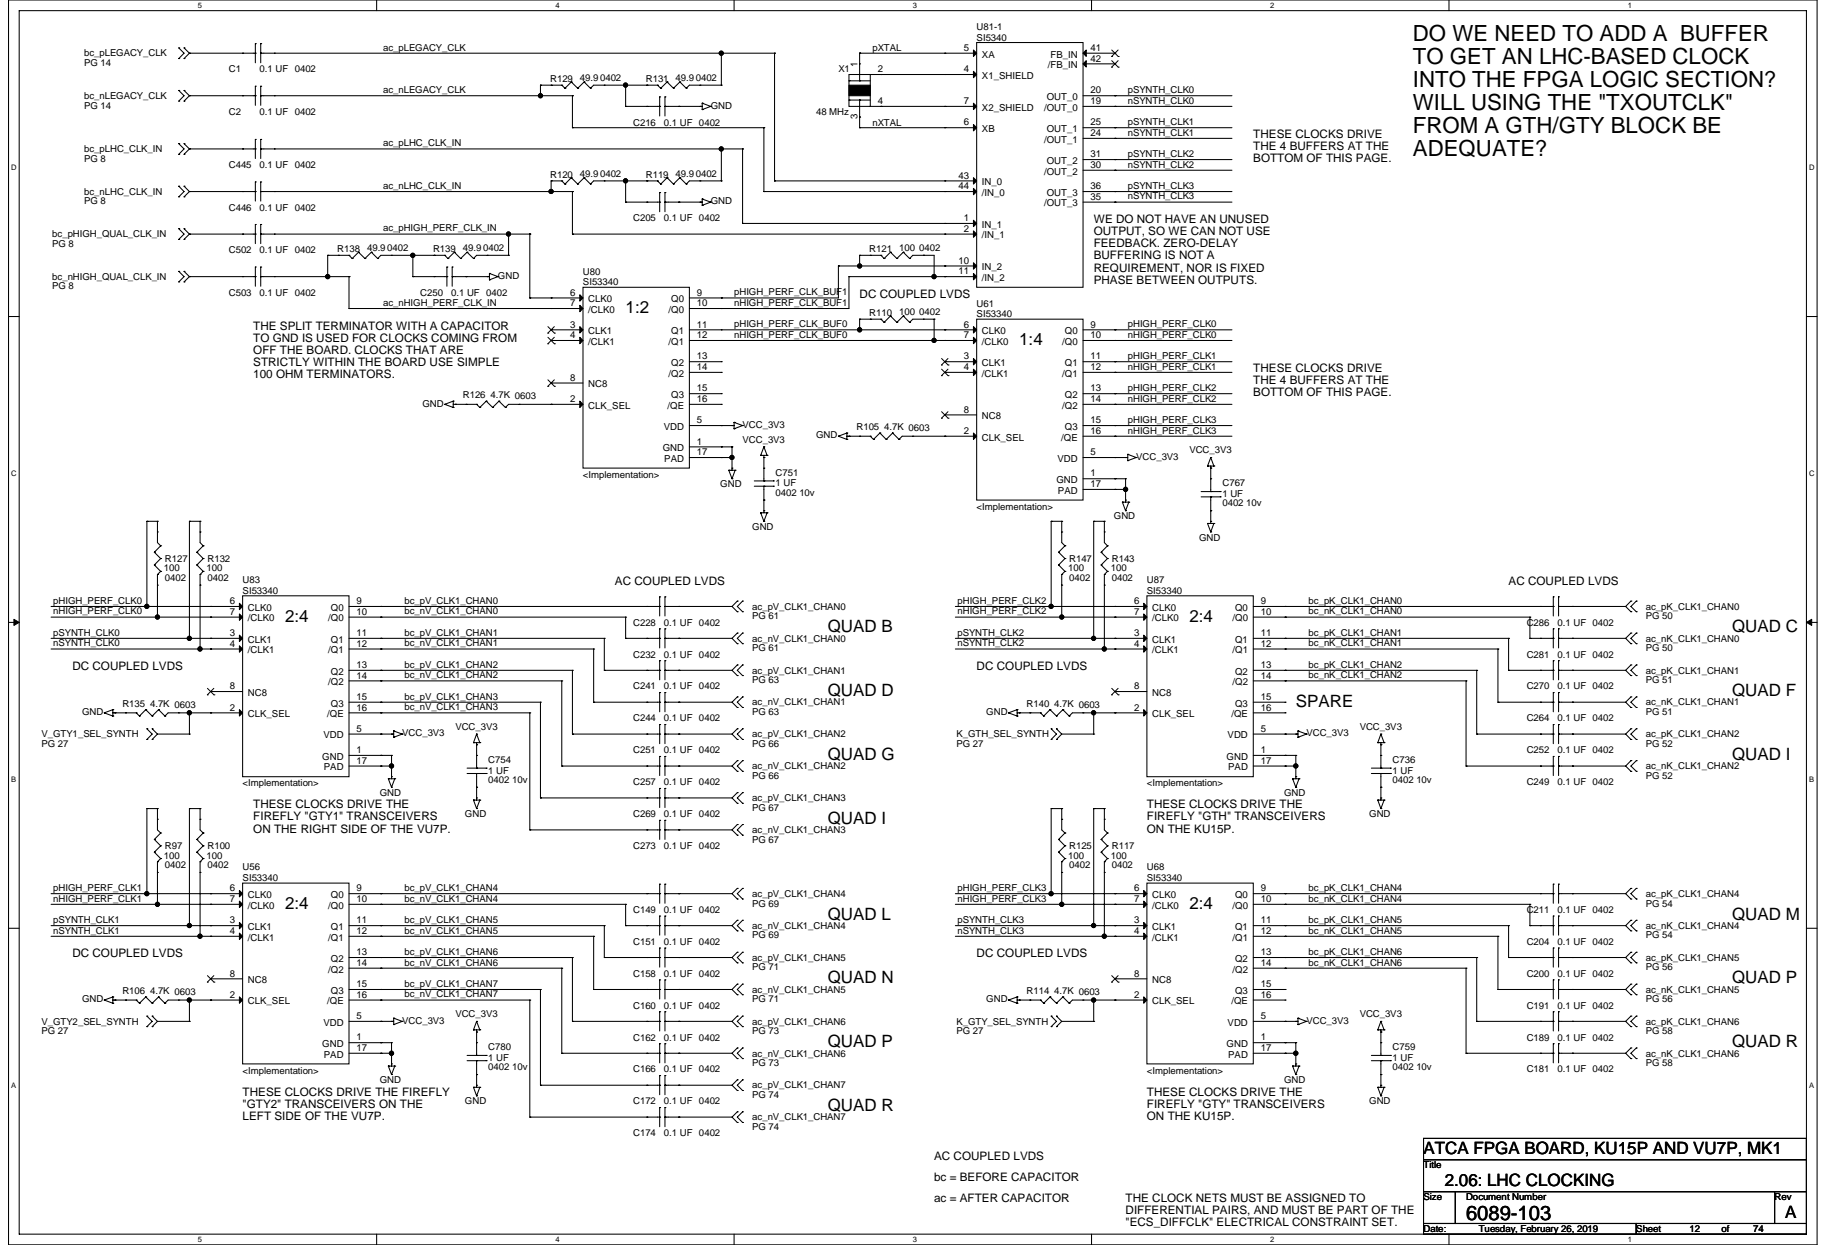
[picture p42: page 12]

TO GET AN LHC-BASED CLOCK
INTO THE FPGA LOGIC SECTION?
WILL USING THE "TXOUTCLK"
FROM A GTH/GTY BLOCK BE
ADEQUATE?

THESE CLOCKS DRIVE
THE 4 BUFFERS AT THE
BOTTOM OF THIS PAGE.

pSYNTH_CLK3
nSYNTH_CLK3
WE DO NOT HAVE AN UNUSED
OUTPUT, SO WE CAN NOT USE
FEEDBACK. ZERO-DELAY
BUFFERING IS NOT A
REQUIREMENT, NOR IS FIXED
PHASE BETWEEN OUTPUTS.

THE SPLIT TERMINATOR WITH A CAPACITOR
TO GND IS USED FOR CLOCKS COMING FROM

C | OFF THE BOARD. CLOCKS THAT ARE Q2 13 STRICTLY WITHIN THE BOARD USE SIMPLE 100 OHM TERMINATORS. /Q2 14 NC8 8 Q3 15 R126 4.7K 0603 CLK_SEL 2 /QE 16 GND VDD 5 GND 1 | VCC_3V3 | CLK1 3 Q1 11 pHIGH_PERF_CLK1 /CLK1 4 /Q1 12 nHIGH_PERF_CLK1 THESE CLOCKS DRIVE THE 4 BUFFERS AT THE Q2 13 pHIGH_PERF_CLK2 BOTTOM OF THIS PAGE. /Q2 14 nHIGH_PERF_CLK2 NC8 8 Q3 15 pHIGH_PERF_CLK3 R105 4.7K 0603 CLK_SEL 2 /QE 16 nHIGH_PERF_CLK3 GND | C

<Implementation>
THESE CLOCKS DRIVE THE
FIREFLY "GTY1" TRANSCEIVERS
ON THE RIGHT SIDE OF THE VU7P.

FIREFLY "GTH" TRANSCEIVERS
ON THE KU15P.

THESE CLOCKS DRIVE THE FIREFLY
"GTY2" TRANSCEIVERS ON THE
LEFT SIDE OF THE VU7P.

FIREFLY "GTY" TRANSCEIVERS

THE CLOCK NETS MUST BE ASSIGNED TO
DIFFERENTIAL PAIRS, AND MUST BE PART OF THE
"ECS_DIFFCLK" ELECTRICAL CONSTRAINT SET.

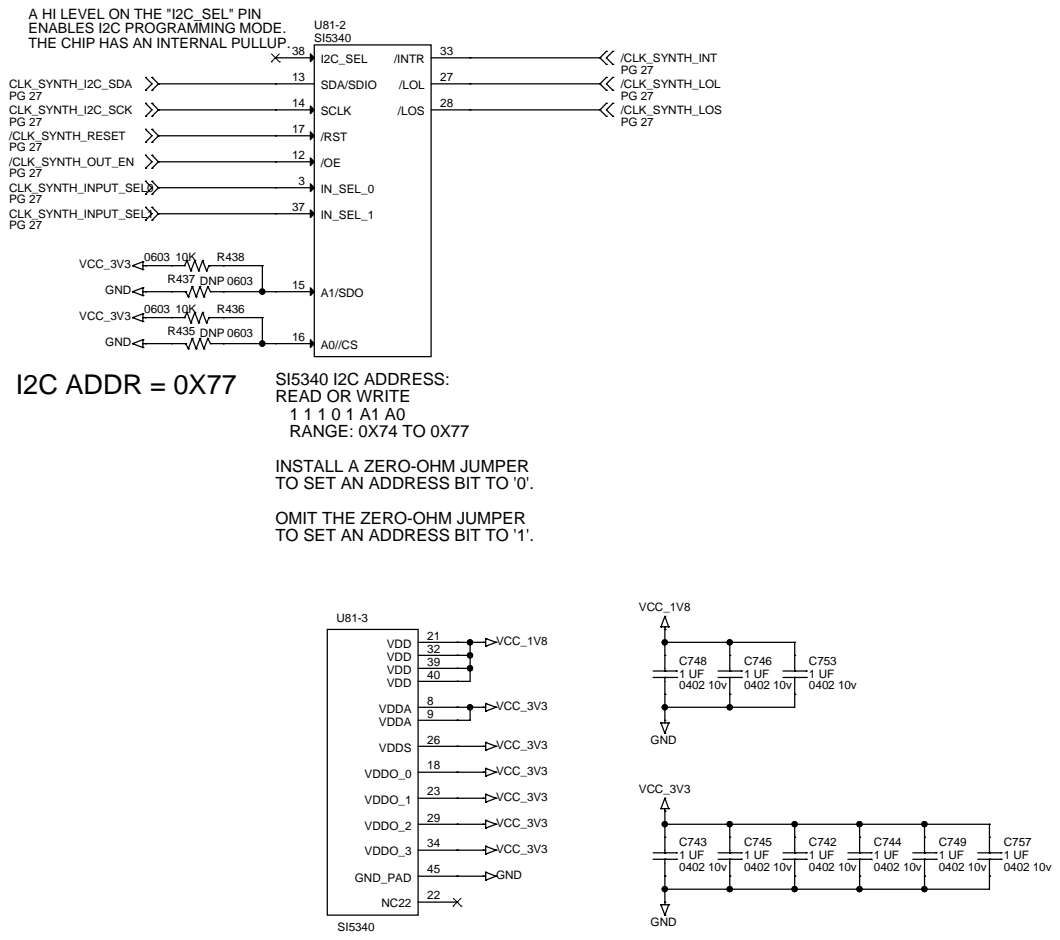
[picture p43: page 13]

A HI LEVEL ON THE "I2C_SEL" PIN
ENABLES I2C PROGRAMMING MODE.
THE CHIP HAS AN INTERNAL PULLUP.

C | 0603 10K R436 I2C ADDR = 0X77 SI5340 I2C ADDRESS: READ OR WRITE 1 1 1 0 1 A1 A0 RANGE: 0X74 TO 0X77 INSTALL A ZERO-OHM JUMPER TO SET AN ADDRESS BIT TO '0'. OMIT THE ZERO-OHM JUMPER TO SET AN ADDRESS BIT TO '1'. VCC_1V8 U81-3 | C

B | VDDS 26 VCC_3V3 VDDO_0 18 VCC_3V3 VDDO_1 23 VCC_3V3 SI5340 | 1 UF | B

2.07: LHC CLOCKING SUPPORT 2.07: LHC CLOCKING SUPPORT 2.07: LHC CLOCKING SUPPORT Friday, March 08, 2019 Friday, March 08, 2019 Friday, March 08, 2019 13 13 13 74 74 74

U13-2 21 21 SFP_CONN_WITH_CAGE | U13-1 THIS CIRCUIT ON THIS PAGE IS FOR USE IN THE GND 12 12 nTTCIN 13 13 pTTCIN THIS JUMPER ALLOWS DIRECT CONNECTION

# PROTOTYPE ONLY. IT ALLOWS US TO FEED

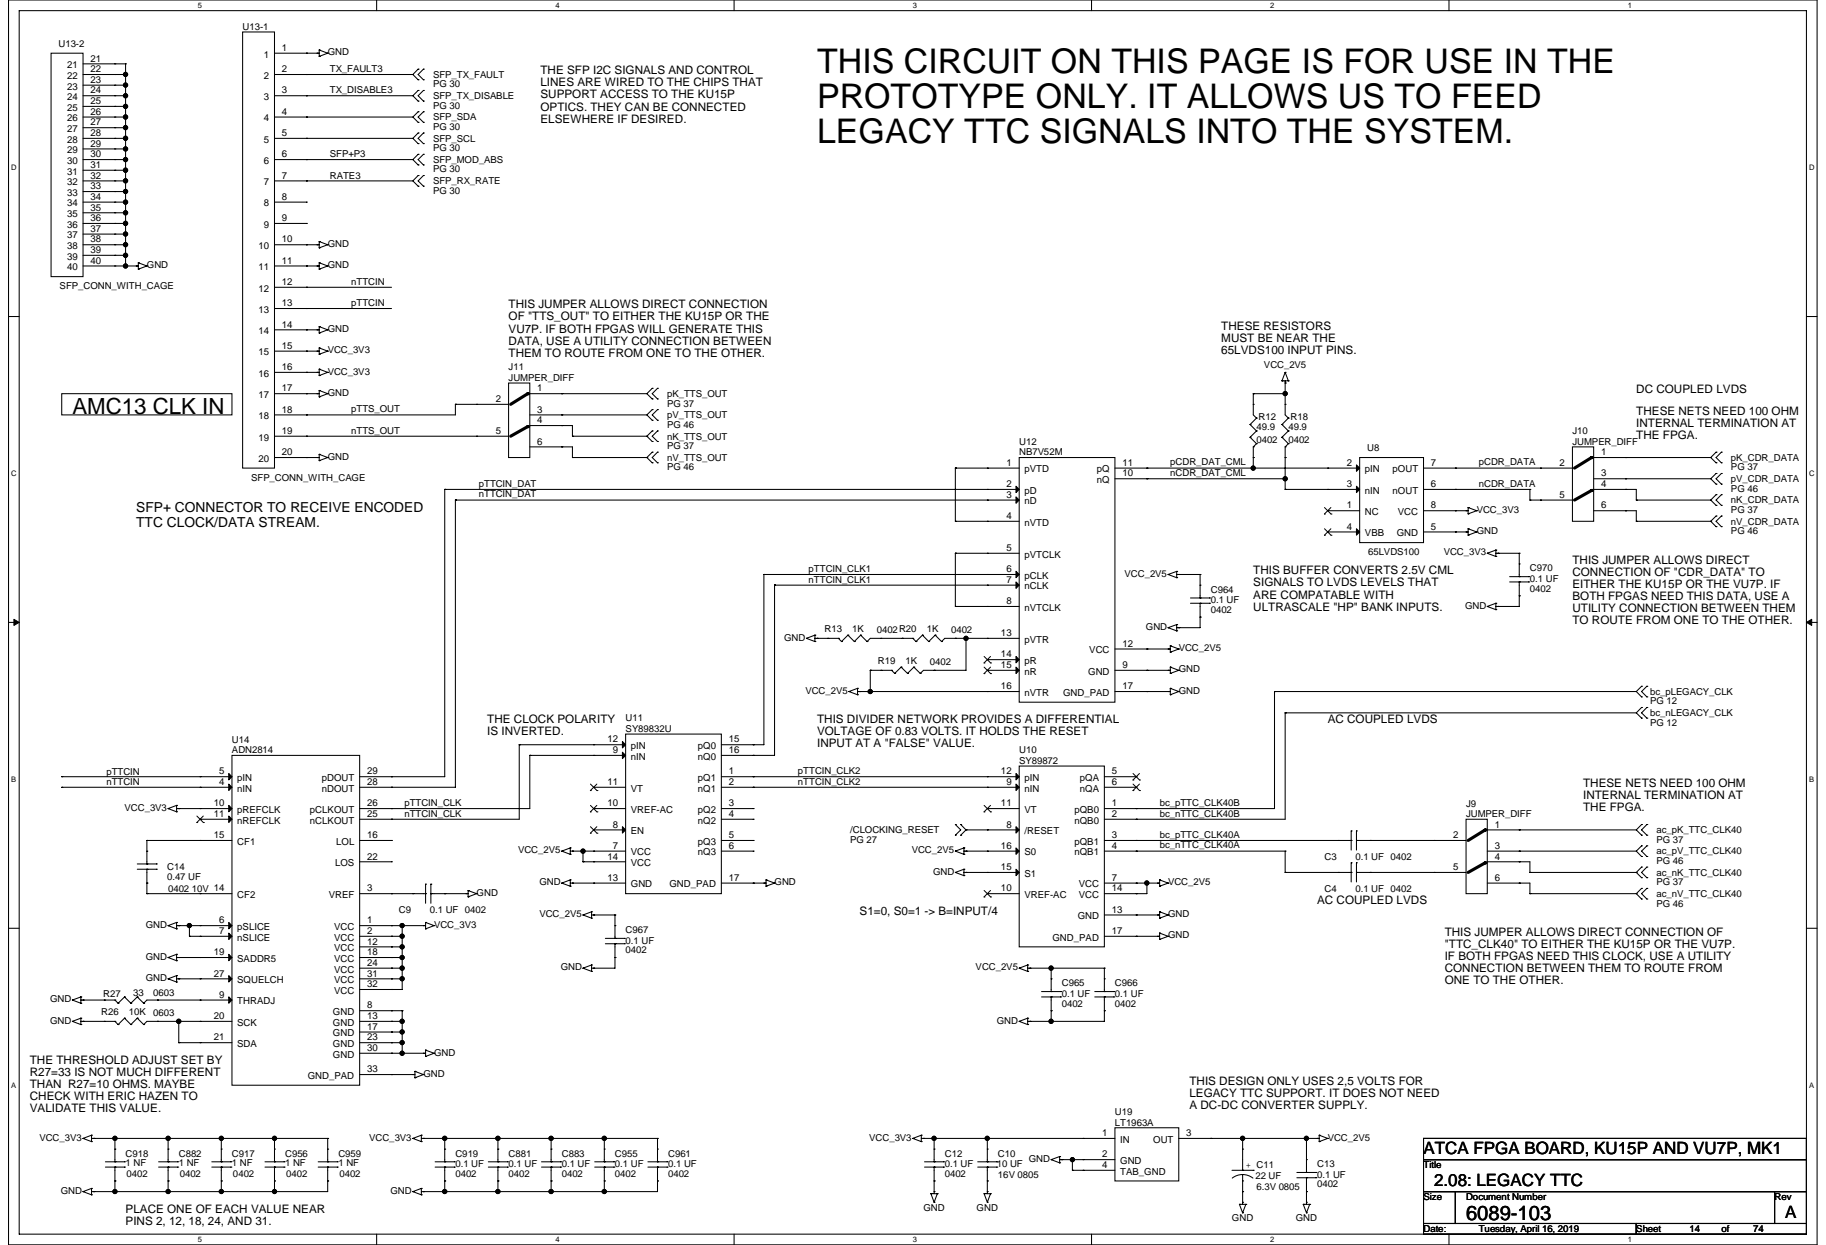
[picture p44: page 14]

THE SFP I2C SIGNALS AND CONTROL
LINES ARE WIRED TO THE CHIPS THAT
SUPPORT ACCESS TO THE KU15P
OPTICS. THEY CAN BE CONNECTED
ELSEWHERE IF DESIRED.

LEGACY TTC SIGNALS INTO THE SYSTEM.

C | 14 14 VU7P. IF BOTH FPGAS WILL GENERATE THIS THESE RESISTORS GND MUST BE NEAR THE DATA, USE A UTILITY CONNECTION BETWEEN 15 15 VCC_3V3 THEM TO ROUTE FROM ONE TO THE OTHER. 65LVDS100 INPUT PINS. VCC_2V5 16 16 J11 VCC_3V3 JUMPER_DIFF R18 4 INTERNAL TERMINATION AT U12 0402 JUMPER_DIFF | C

OF "TTS_OUT" TO EITHER THE KU15P OR THE

DC COUPLED LVDS
THESE NETS NEED 100 OHM
THE FPGA.

SFP+ CONNECTOR TO RECEIVE ENCODED
TTC CLOCK/DATA STREAM.

THIS JUMPER ALLOWS DIRECT
CONNECTION OF "CDR_DATA" TO
EITHER THE KU15P OR THE VU7P. IF
BOTH FPGAS NEED THIS DATA, USE A
UTILITY CONNECTION BETWEEN THEM
TO ROUTE FROM ONE TO THE OTHER.

THIS BUFFER CONVERTS 2.5V CML
SIGNALS TO LVDS LEVELS THAT
ARE COMPATABLE WITH
ULTRASCALE "HP" BANK INPUTS.

THIS DIVIDER NETWORK PROVIDES A DIFFERENTIAL
VOLTAGE OF 0.83 VOLTS. IT HOLDS THE RESET
INPUT AT A "FALSE" VALUE.

B | C9 0.1 UF 0402 | | | EN 8 /RESET 8 S1=0, S0=1 -> B=INPUT/4 GND 13 | B

INTERNAL TERMINATION AT

THIS JUMPER ALLOWS DIRECT CONNECTION OF
"TTC_CLK40" TO EITHER THE KU15P OR THE VU7P.
IF BOTH FPGAS NEED THIS CLOCK, USE A UTILITY
CONNECTION BETWEEN THEM TO ROUTE FROM
ONE TO THE OTHER.

R27 33 0603 THE THRESHOLD ADJUST SET BY R27=33 IS NOT MUCH DIFFERENT THAN R27=10 OHMS. MAYBE CHECK WITH ERIC HAZEN TO VALIDATE THIS VALUE. PLACE ONE OF EACH VALUE NEAR PINS 2, 12, 18, 24, AND 31. | THRADJ 9 GND_PAD 33 | 0.1 UF 0.1 UF GND THIS DESIGN ONLY USES 2,5 VOLTS FOR LEGACY TTC SUPPORT. IT DOES NOT NEED A DC-DC CONVERTER SUPPLY. U19 LT1963A IN 1 OUT 3 GND GND GND GND Tuesday, April 16, 2019 Tuesday, April 16, 2019 Tuesday, April 16, 2019 14 14 14 74 74 74

# SPARE

# QUAD C

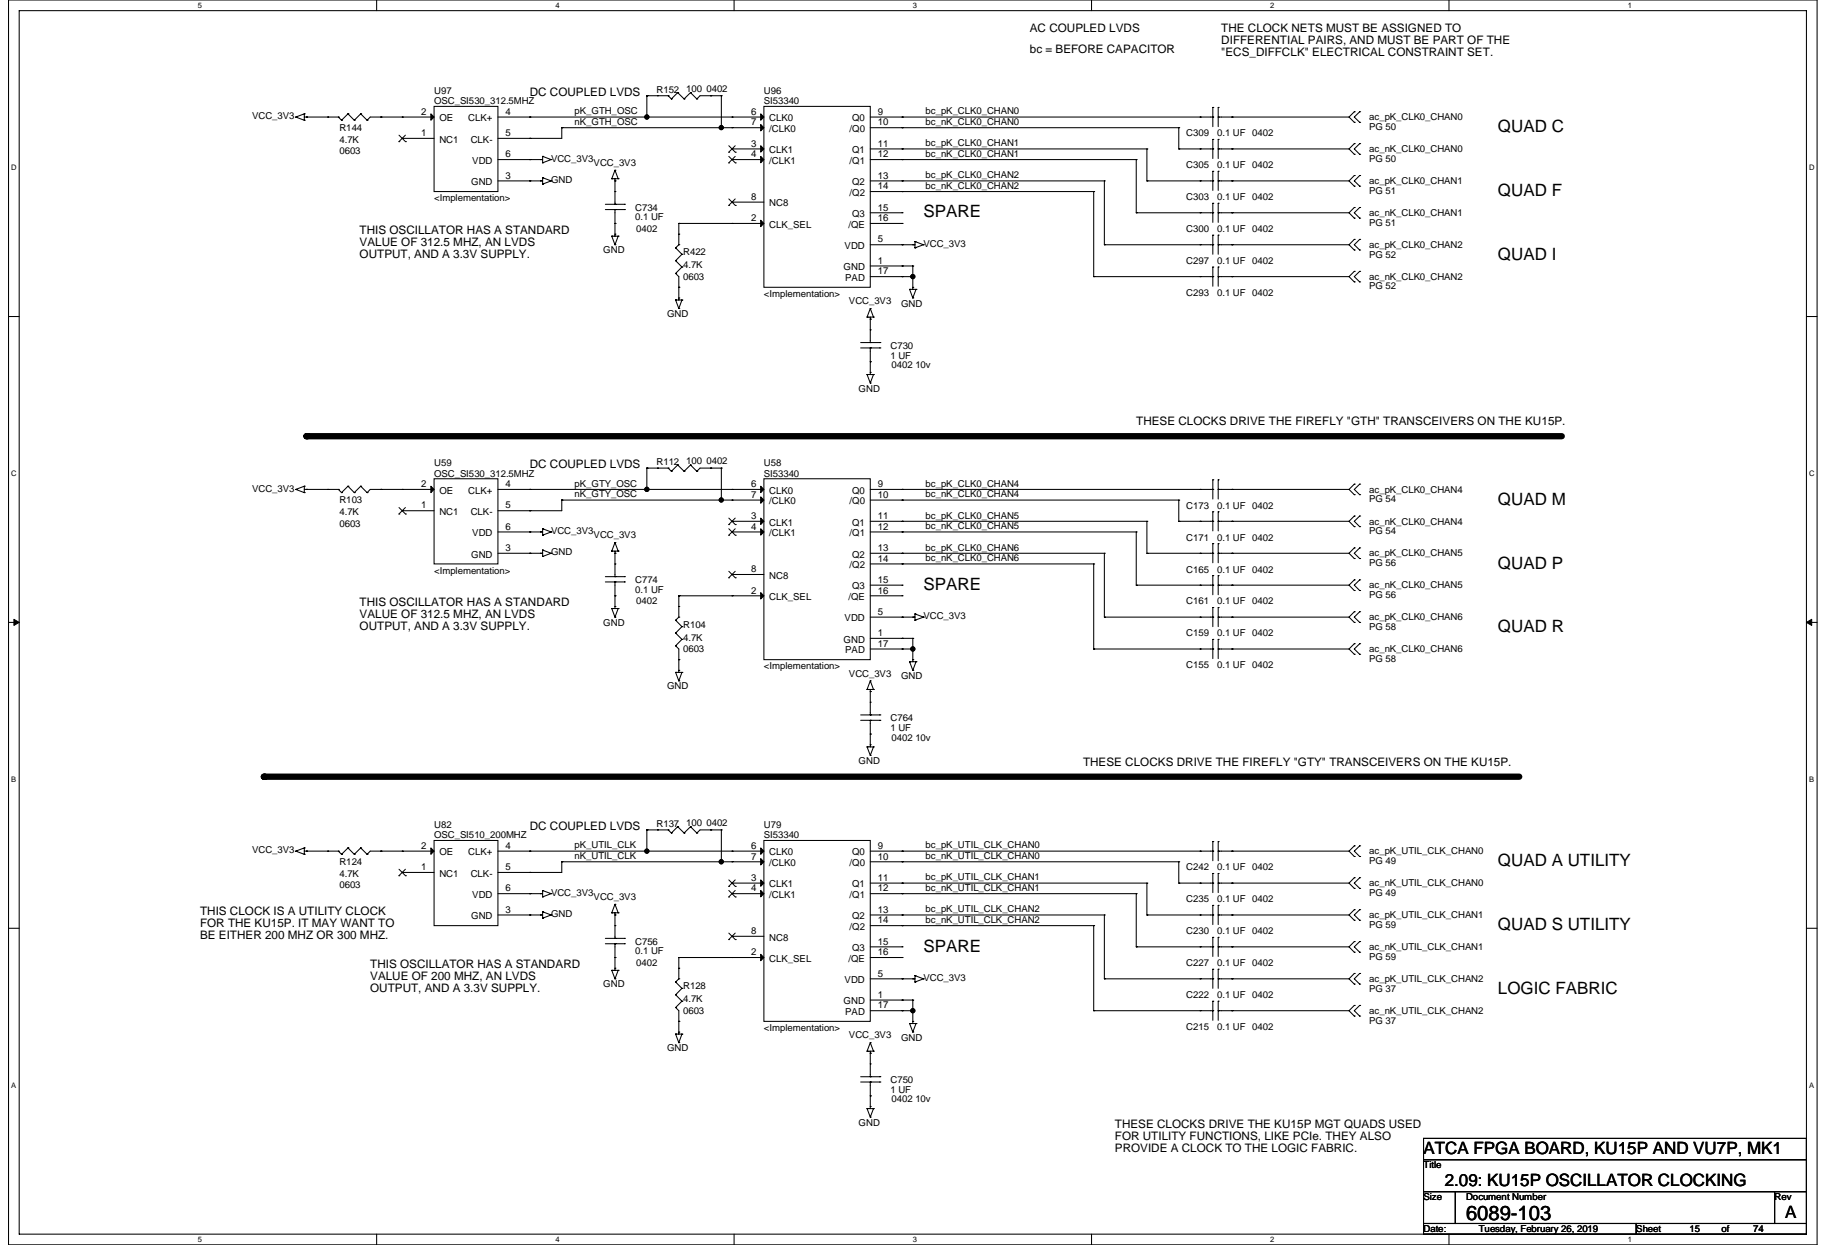
[picture p45: page 15]

DIFFERENTIAL PAIRS, AND MUST BE PART OF THE
"ECS_DIFFCLK" ELECTRICAL CONSTRAINT SET.

THIS OSCILLATOR HAS A STANDARD
VALUE OF 312.5 MHZ, AN LVDS
OUTPUT, AND A 3.3V SUPPLY.

THESE CLOCKS DRIVE THE FIREFLY "GTH" TRANSCEIVERS ON THE KU15P.

B | GND THESE CLOCKS DRIVE THE FIREFLY "GTY" TRANSCEIVERS ON THE KU15P. R137 100 0402 U82 DC COUPLED LVDS U79 | B

THIS CLOCK IS A UTILITY CLOCK
FOR THE KU15P. IT MAY WANT TO
BE EITHER 200 MHZ OR 300 MHZ.

Q3 15 GND | THESE CLOCKS DRIVE THE KU15P MGT QUADS USED FOR UTILITY FUNCTIONS, LIKE PCIe. THEY ALSO PROVIDE A CLOCK TO THE LOGIC FABRIC. | 2.09: KU15P OSCILLATOR CLOCKING 2.09: KU15P OSCILLATOR CLOCKING 2.09: KU15P OSCILLATOR CLOCKING Tuesday, February 26, 2019 Tuesday, February 26, 2019 Tuesday, February 26, 2019 15 15 15 74 74 74

VALUE OF 200 MHZ, AN LVDS

# QUAD B

# QUAD D

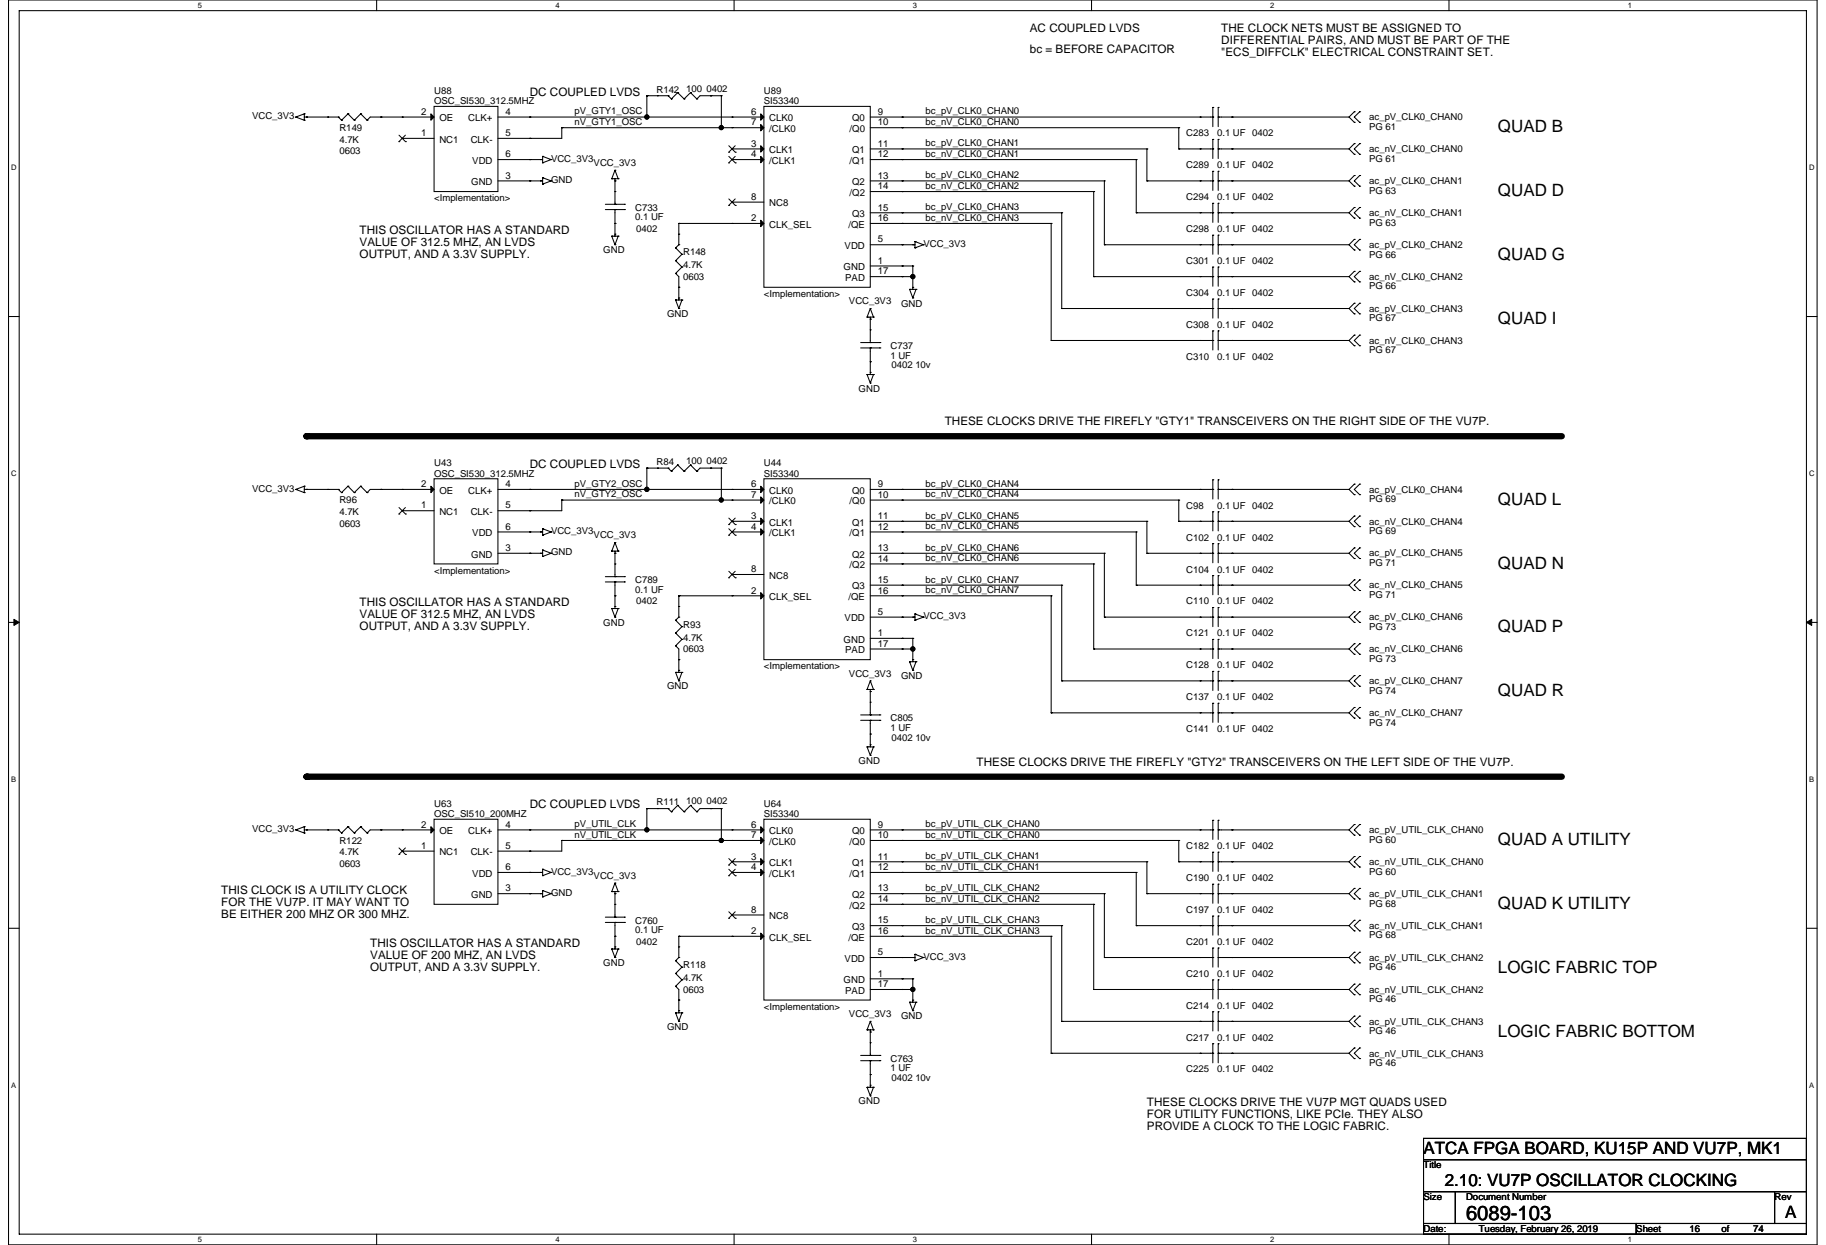
[picture p46: page 16]

DIFFERENTIAL PAIRS, AND MUST BE PART OF THE
"ECS_DIFFCLK" ELECTRICAL CONSTRAINT SET.

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

THESE CLOCKS DRIVE THE FIREFLY "GTY1" TRANSCEIVERS ON THE RIGHT SIDE OF THE VU7P.

B | THESE CLOCKS DRIVE THE FIREFLY "GTY2" TRANSCEIVERS ON THE LEFT SIDE OF THE VU7P. U63 DC COUPLED LVDS R111 100 0402 U64 | B

THIS CLOCK IS A UTILITY CLOCK
FOR THE VU7P. IT MAY WANT TO
BE EITHER 200 MHZ OR 300 MHZ.

VALUE OF 200 MHZ, AN LVDS

bc_nV_UTIL_CLK_CHAN3 | | THESE CLOCKS DRIVE THE VU7P MGT QUADS USED FOR UTILITY FUNCTIONS, LIKE PCIe. THEY ALSO PROVIDE A CLOCK TO THE LOGIC FABRIC. | 2.10: VU7P OSCILLATOR CLOCKING 2.10: VU7P OSCILLATOR CLOCKING 2.10: VU7P OSCILLATOR CLOCKING Tuesday, February 26, 2019 Tuesday, February 26, 2019 Tuesday, February 26, 2019 16 16 16 74 74 74

# TM4C ACTIVE LED

# KU15P DIP SWITCH

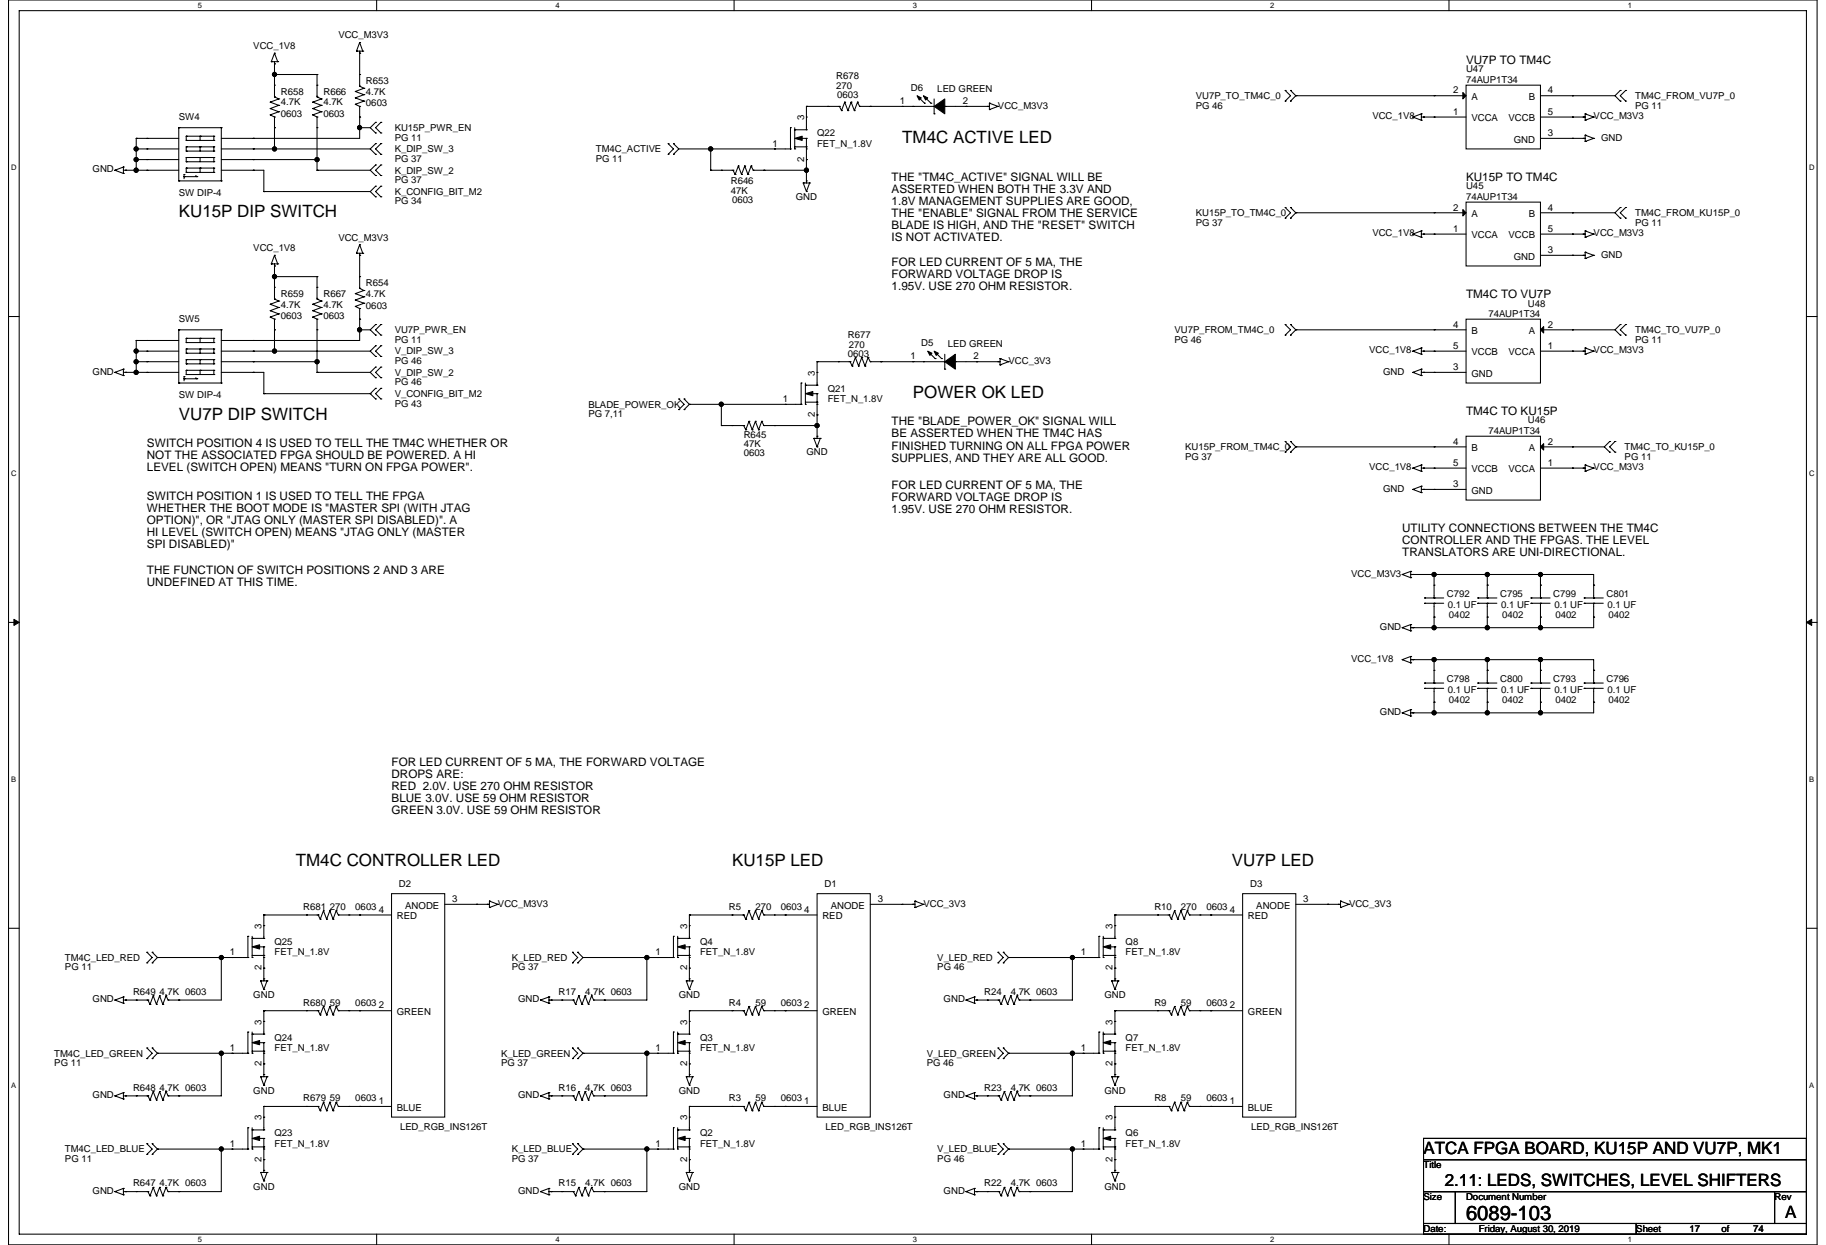
[picture p47: page 17]

THE "TM4C_ACTIVE" SIGNAL WILL BE
ASSERTED WHEN BOTH THE 3.3V AND
1.8V MANAGEMENT SUPPLIES ARE GOOD,
THE "ENABLE" SIGNAL FROM THE SERVICE
BLADE IS HIGH, AND THE "RESET" SWITCH
IS NOT ACTIVATED.
FOR LED CURRENT OF 5 MA, THE
FORWARD VOLTAGE DROP IS
1.95V. USE 270 OHM RESISTOR.

THE "BLADE_POWER_OK" SIGNAL WILL
BE ASSERTED WHEN THE TM4C HAS

C | 4 2 FINISHED TURNING ON ALL FPGA POWER KU15P_FROM_TM4C_0 B A TM4C_TO_KU15P_0 SUPPLIES, AND THEY ARE ALL GOOD. PG 37 PG 11 VCCB 5 1 VCC_1V8 VCCA VCC_M3V3 FOR LED CURRENT OF 5 MA, THE GND 3 GND FORWARD VOLTAGE DROP IS 1.95V. USE 270 OHM RESISTOR. UTILITY CONNECTIONS BETWEEN THE TM4C CONTROLLER AND THE FPGAS. THE LEVEL SPI DISABLED)" TRANSLATORS ARE UNI-DIRECTIONAL. 0.1 UF 0.1 UF 0.1 UF 0.1 UF | C

SWITCH POSITION 4 IS USED TO TELL THE TM4C WHETHER OR
NOT THE ASSOCIATED FPGA SHOULD BE POWERED. A HI
LEVEL (SWITCH OPEN) MEANS "TURN ON FPGA POWER".

SWITCH POSITION 1 IS USED TO TELL THE FPGA
WHETHER THE BOOT MODE IS "MASTER SPI (WITH JTAG
OPTION)", OR "JTAG ONLY (MASTER SPI DISABLED)". A
HI LEVEL (SWITCH OPEN) MEANS "JTAG ONLY (MASTER

THE FUNCTION OF SWITCH POSITIONS 2 AND 3 ARE
UNDEFINED AT THIS TIME.

B | 0.1 UF 0.1 UF 0.1 UF 0.1 UF FOR LED CURRENT OF 5 MA, THE FORWARD VOLTAGE DROPS ARE: RED 2.0V. USE 270 OHM RESISTOR BLUE 3.0V. USE 59 OHM RESISTOR GREEN 3.0V. USE 59 OHM RESISTOR TM4C CONTROLLER LED KU15P LED VU7P LED D2 D1 D3 ANODE 3 ANODE 3 ANODE 3 VCC_M3V3 VCC_3V3 VCC_3V3 R681 270 0603 R5 270 0603 R10 270 0603 RED 4 RED 4 RED 4 | B

R680 59 0603 GREEN 2 R679 59 0603 BLUE 1 | R4 59 0603 GREEN 2 R3 59 0603 BLUE 1 | R9 59 0603 GREEN 2 R8 59 0603 BLUE 1 Friday, August 30, 2019 Friday, August 30, 2019 Friday, August 30, 2019 17 17 17 74 74 74

2.11: LEDS, SWITCHES, LEVEL SHIFTERS

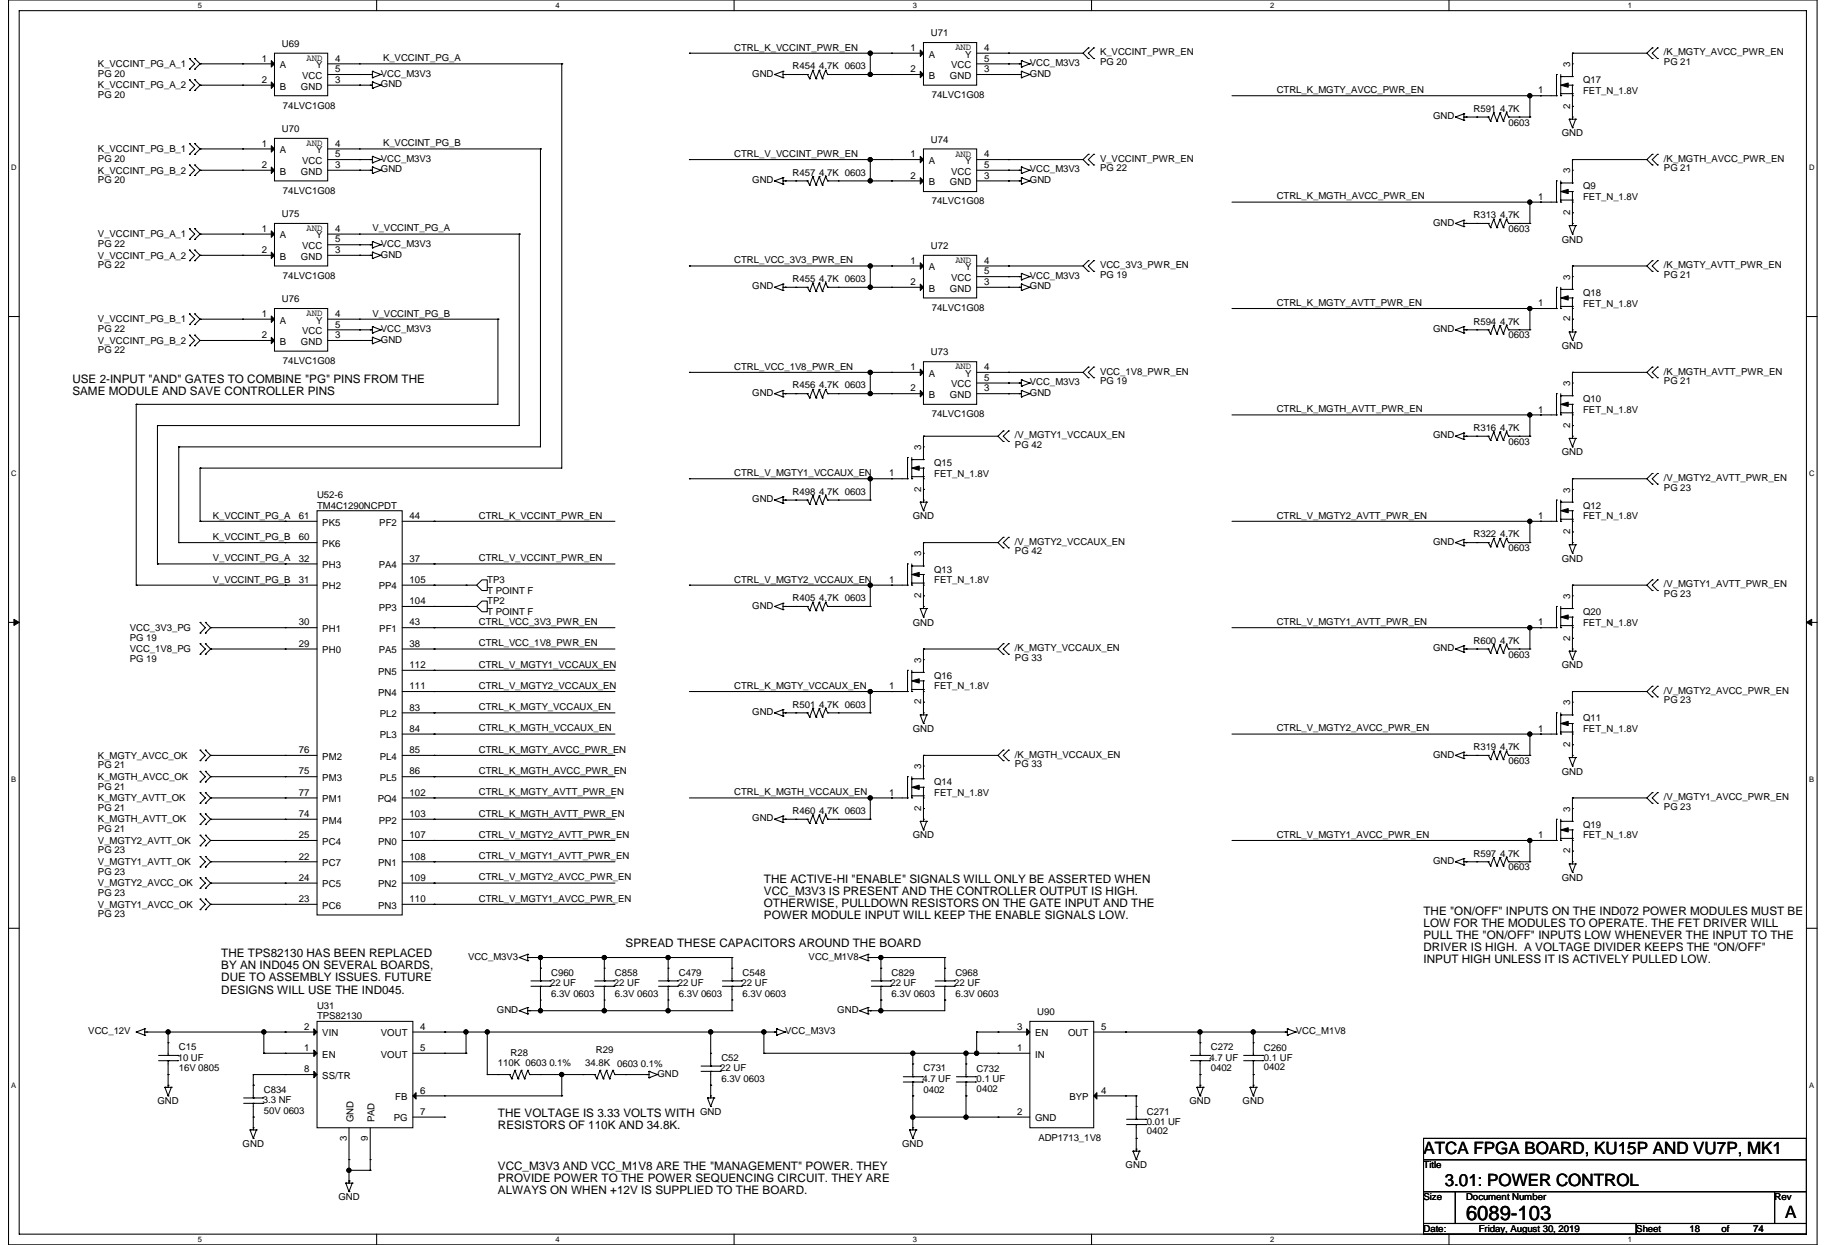
[picture p48: page 18]

U69 | | CTRL_K_VCCINT_PWR_EN | U71 AND

C | V_VCCINT_PG_B_1 A Y VCC 5 VCC_M3V3 2 GND 3 V_VCCINT_PG_B_2 B GND 74LVC1G08 USE 2-INPUT "AND" GATES TO COMBINE "PG" PINS FROM THE SAME MODULE AND SAVE CONTROLLER PINS | | | GND 1 | C

B | PG 23 PC5 24 PN2 109 CTRL_V_MGTY2_AVCC_PWR_EN THE ACTIVE-HI "ENABLE" SIGNALS WILL ONLY BE ASSERTED WHEN V_MGTY2_AVCC_OK PG 23 VCC_M3V3 IS PRESENT AND THE CONTROLLER OUTPUT IS HIGH. PC6 23 PN3 110 CTRL_V_MGTY1_AVCC_PWR_EN OTHERWISE, PULLDOWN RESISTORS ON THE GATE INPUT AND THE V_MGTY1_AVCC_OK PG 23 POWER MODULE INPUT WILL KEEP THE ENABLE SIGNALS LOW. | 0603 THE "ON/OFF" INPUTS ON THE IND072 POWER MODULES MUST BE LOW FOR THE MODULES TO OPERATE. THE FET DRIVER WILL | B

THE TPS82130 HAS BEEN REPLACED | 22 UF TPS82130 VIN 2 VOUT 4 ALWAYS ON WHEN +12V IS SUPPLIED TO THE BOARD. | SPREAD THESE CAPACITORS AROUND THE BOARD 22 UF 22 UF 22 UF 22 UF EN 3 OUT 5 | PULL THE "ON/OFF" INPUTS LOW WHENEVER THE INPUT TO THE DRIVER IS HIGH. A VOLTAGE DIVIDER KEEPS THE "ON/OFF" Friday, August 30, 2019 Friday, August 30, 2019 Friday, August 30, 2019 18 18 18 74 74 74

BY AN IND045 ON SEVERAL BOARDS,
DUE TO ASSEMBLY ISSUES. FUTURE
DESIGNS WILL USE THE IND045.

INPUT HIGH UNLESS IT IS ACTIVELY PULLED LOW.

THE VOLTAGE IS 3.33 VOLTS WITH
RESISTORS OF 110K AND 34.8K.

VCC_M3V3 AND VCC_M1V8 ARE THE "MANAGEMENT" POWER. THEY
PROVIDE POWER TO THE POWER SEQUENCING CIRCUIT. THEY ARE

# I2C ADDR = 0X40 (AND 0X41)

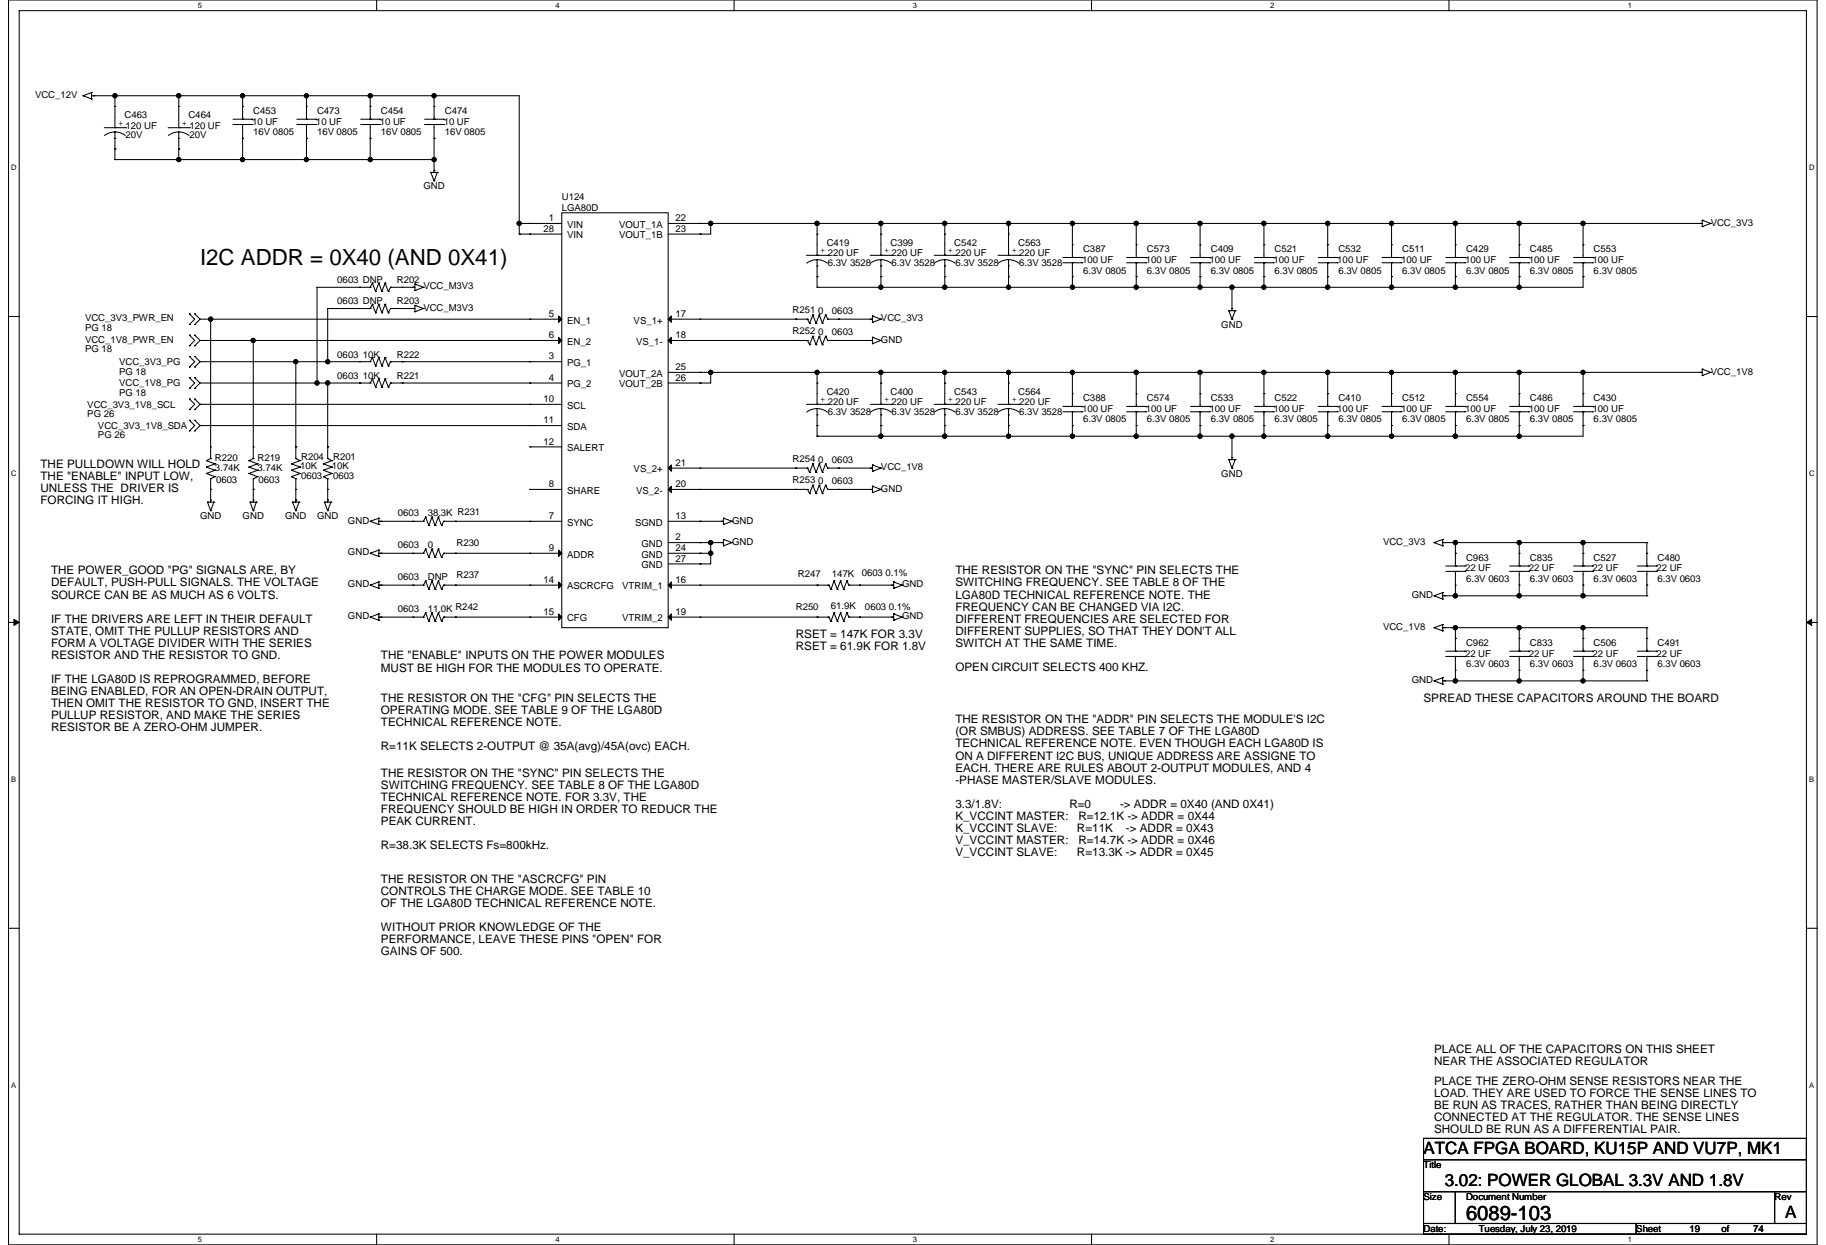
[picture p49: page 19]

THE PULLDOWN WILL HOLD
THE "ENABLE" INPUT LOW,
UNLESS THE DRIVER IS
FORCING IT HIGH.

THE POWER_GOOD "PG" SIGNALS ARE, BY
DEFAULT, PUSH-PULL SIGNALS. THE VOLTAGE
SOURCE CAN BE AS MUCH AS 6 VOLTS.
IF THE DRIVERS ARE LEFT IN THEIR DEFAULT
STATE, OMIT THE PULLUP RESISTORS AND
FORM A VOLTAGE DIVIDER WITH THE SERIES
RESISTOR AND THE RESISTOR TO GND.
IF THE LGA80D IS REPROGRAMMED, BEFORE
BEING ENABLED, FOR AN OPEN-DRAIN OUTPUT,
THEN OMIT THE RESISTOR TO GND, INSERT THE
PULLUP RESISTOR, AND MAKE THE SERIES
RESISTOR BE A ZERO-OHM JUMPER.

THE RESISTOR ON THE "SYNC" PIN SELECTS THE
SWITCHING FREQUENCY. SEE TABLE 8 OF THE
LGA80D TECHNICAL REFERENCE NOTE. THE
FREQUENCY CAN BE CHANGED VIA I2C.
DIFFERENT FREQUENCIES ARE SELECTED FOR
DIFFERENT SUPPLIES, SO THAT THEY DON'T ALL
SWITCH AT THE SAME TIME.
OPEN CIRCUIT SELECTS 400 KHZ.

THE "ENABLE" INPUTS ON THE POWER MODULES
MUST BE HIGH FOR THE MODULES TO OPERATE.

GND
SPREAD THESE CAPACITORS AROUND THE BOARD

THE RESISTOR ON THE "CFG" PIN SELECTS THE
OPERATING MODE. SEE TABLE 9 OF THE LGA80D
TECHNICAL REFERENCE NOTE.
R=11K SELECTS 2-OUTPUT @ 35A(avg)/45A(ovc) EACH.

THE RESISTOR ON THE "ADDR" PIN SELECTS THE MODULE'S I2C
(OR SMBUS) ADDRESS. SEE TABLE 7 OF THE LGA80D
TECHNICAL REFERENCE NOTE. EVEN THOUGH EACH LGA80D IS
ON A DIFFERENT I2C BUS, UNIQUE ADDRESS ARE ASSIGNE TO
EACH. THERE ARE RULES ABOUT 2-OUTPUT MODULES, AND 4
-PHASE MASTER/SLAVE MODULES.
K_VCCINT MASTER: R=12.1K -> ADDR = 0X44
V_VCCINT MASTER: R=14.7K -> ADDR = 0X46

SWITCHING FREQUENCY. SEE TABLE 8 OF THE LGA80D
TECHNICAL REFERENCE NOTE. FOR 3.3V, THE
FREQUENCY SHOULD BE HIGH IN ORDER TO REDUCR THE
PEAK CURRENT.
R=38.3K SELECTS Fs=800kHz.

THE RESISTOR ON THE "ASCRCFG" PIN
CONTROLS THE CHARGE MODE. SEE TABLE 10
OF THE LGA80D TECHNICAL REFERENCE NOTE.
WITHOUT PRIOR KNOWLEDGE OF THE
PERFORMANCE, LEAVE THESE PINS "OPEN" FOR
GAINS OF 500.

PLACE ALL OF THE CAPACITORS ON THIS SHEET
NEAR THE ASSOCIATED REGULATOR

LOAD. THEY ARE USED TO FORCE THE SENSE LINES TO
BE RUN AS TRACES, RATHER THAN BEING DIRECTLY
CONNECTED AT THE REGULATOR. THE SENSE LINES
SHOULD BE RUN AS A DIFFERENTIAL PAIR.

A

# I2C ADDR = 0X44

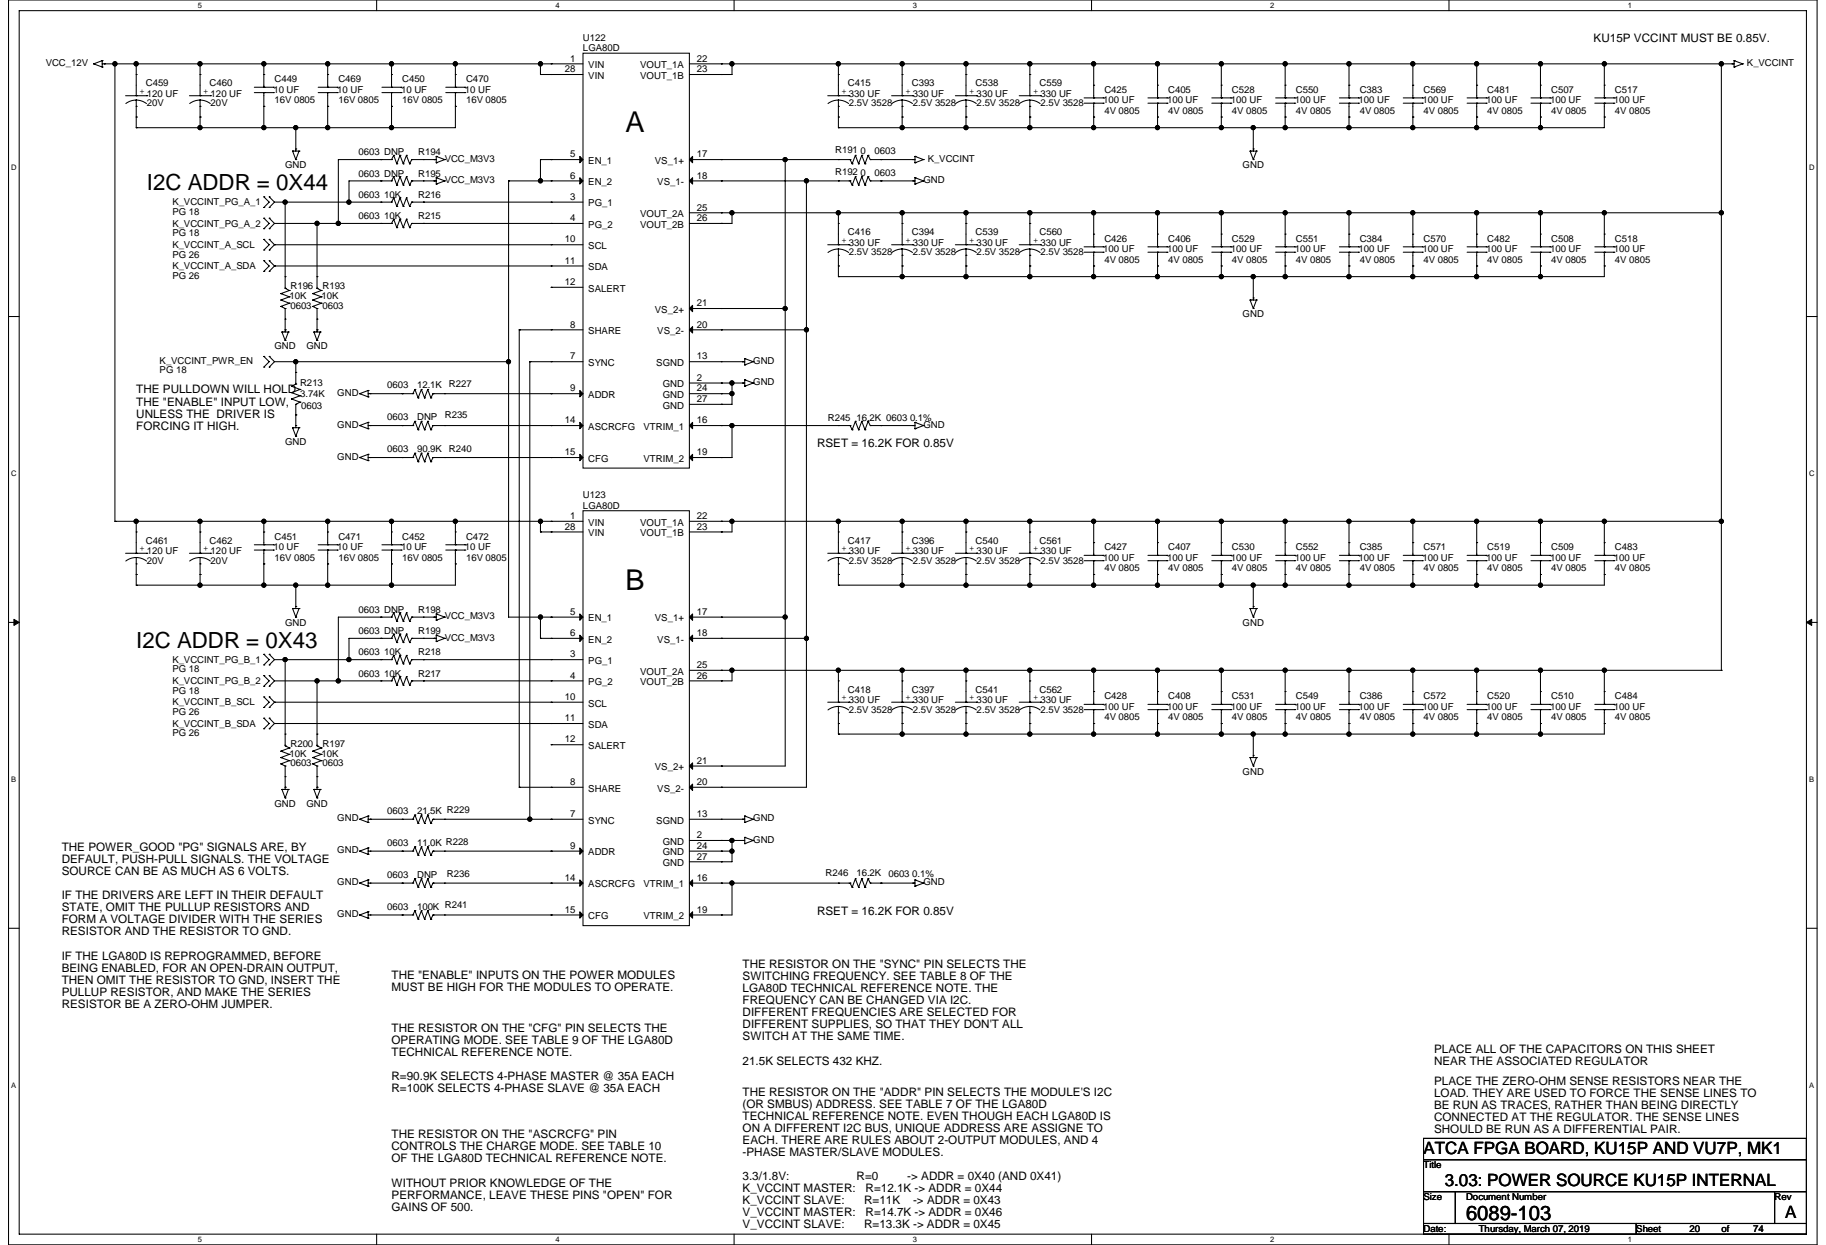
[picture p50: page 20]

U122 LGA80D VIN 1 VOUT_1A 22 | KU15P VCCINT MUST BE 0.85V.

K_VCCINT_PWR_EN
THE PULLDOWN WILL HOLD
THE "ENABLE" INPUT LOW,
UNLESS THE DRIVER IS
FORCING IT HIGH.

C | + + 10 UF 10 UF 10 UF 120 UF 120 UF | | | R245 16.2K 0603 0.1% GND RSET = 16.2K FOR 0.85V 100 UF 100 UF 100 UF 100 UF 100 UF 100 UF 100 UF 100 UF 100 UF 2.5V 3528 2.5V 3528 2.5V 3528 2.5V 3528 | C

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

THE RESISTOR ON THE "SYNC" PIN SELECTS THE
SWITCHING FREQUENCY. SEE TABLE 8 OF THE
LGA80D TECHNICAL REFERENCE NOTE. THE
FREQUENCY CAN BE CHANGED VIA I2C.
DIFFERENT FREQUENCIES ARE SELECTED FOR
DIFFERENT SUPPLIES, SO THAT THEY DON'T ALL
SWITCH AT THE SAME TIME.
21.5K SELECTS 432 KHZ.

THE "ENABLE" INPUTS ON THE POWER MODULES
MUST BE HIGH FOR THE MODULES TO OPERATE.

THE RESISTOR ON THE "CFG" PIN SELECTS THE
OPERATING MODE. SEE TABLE 9 OF THE LGA80D
TECHNICAL REFERENCE NOTE.
R=90.9K SELECTS 4-PHASE MASTER @ 35A EACH
R=100K SELECTS 4-PHASE SLAVE @ 35A EACH

PLACE ALL OF THE CAPACITORS ON THIS SHEET
NEAR THE ASSOCIATED REGULATOR
PLACE THE ZERO-OHM SENSE RESISTORS NEAR THE
LOAD. THEY ARE USED TO FORCE THE SENSE LINES TO
BE RUN AS TRACES, RATHER THAN BEING DIRECTLY
CONNECTED AT THE REGULATOR. THE SENSE LINES
SHOULD BE RUN AS A DIFFERENTIAL PAIR.

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

# K_MGTY_AVCC = 0.9 V

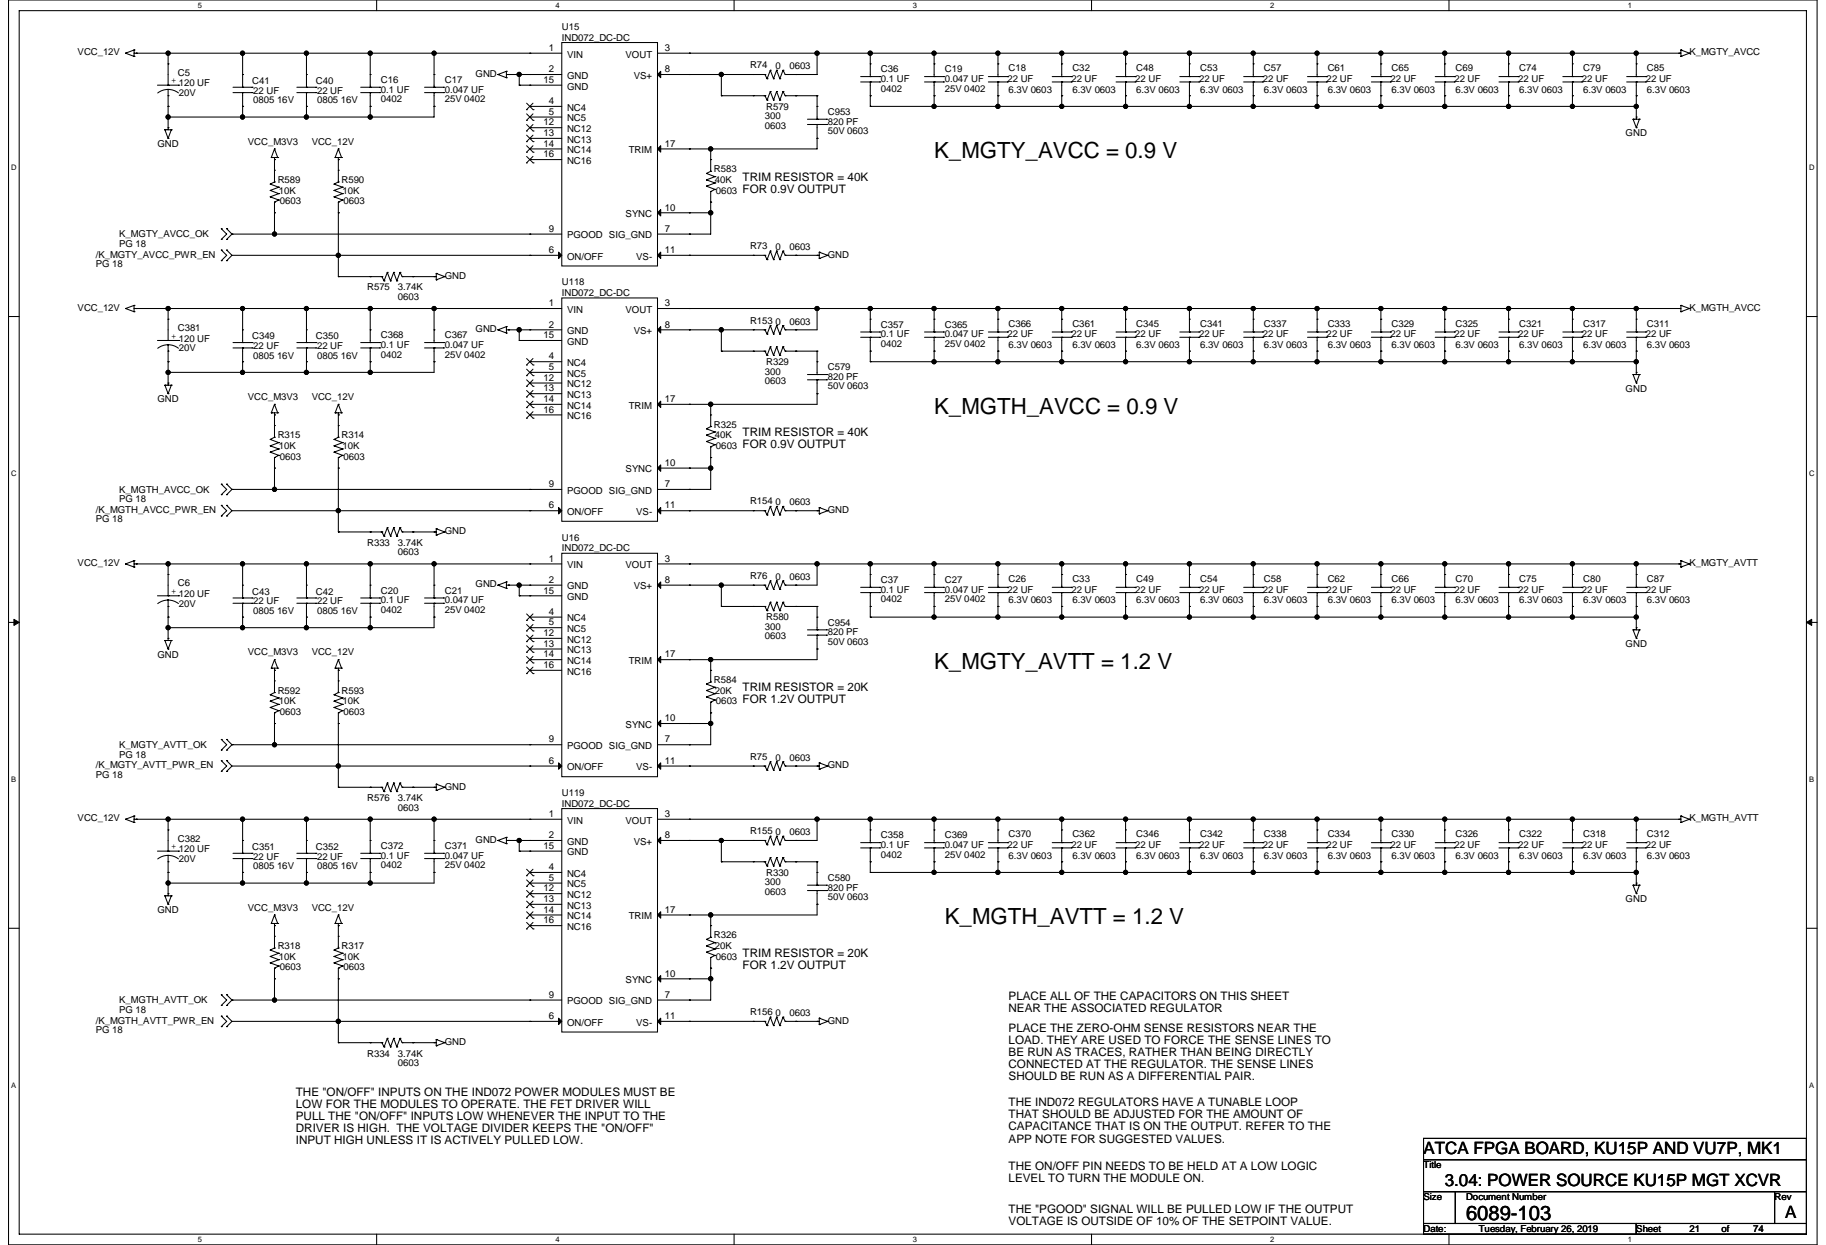
[picture p51: page 21]

U15 IND072_DC-DC VIN 1 VOUT 3 U118 IND072_DC-DC VIN 1 VOUT 3 | FOR 0.9V OUTPUT

C | | U16 IND072_DC-DC VIN 1 VOUT 3 | 0603 FOR 0.9V OUTPUT | C

B | | FOR 1.2V OUTPUT 0603 U119 IND072_DC-DC VIN 1 VOUT 3 NC13 13 50V 0603 | | B

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

THE "ON/OFF" INPUTS ON THE IND072 POWER MODULES MUST BE
LOW FOR THE MODULES TO OPERATE. THE FET DRIVER WILL
PULL THE "ON/OFF" INPUTS LOW WHENEVER THE INPUT TO THE
DRIVER IS HIGH. THE VOLTAGE DIVIDER KEEPS THE "ON/OFF"
INPUT HIGH UNLESS IT IS ACTIVELY PULLED LOW.

THE IND072 REGULATORS HAVE A TUNABLE LOOP
THAT SHOULD BE ADJUSTED FOR THE AMOUNT OF
CAPACITANCE THAT IS ON THE OUTPUT. REFER TO THE
APP NOTE FOR SUGGESTED VALUES.

THE ON/OFF PIN NEEDS TO BE HELD AT A LOW LOGIC
LEVEL TO TURN THE MODULE ON.

3.04: POWER SOURCE KU15P MGT XCVR

THE "PGOOD" SIGNAL WILL BE PULLED LOW IF THE OUTPUT
VOLTAGE IS OUTSIDE OF 10% OF THE SETPOINT VALUE.

A

# I2C ADDR = 0X46

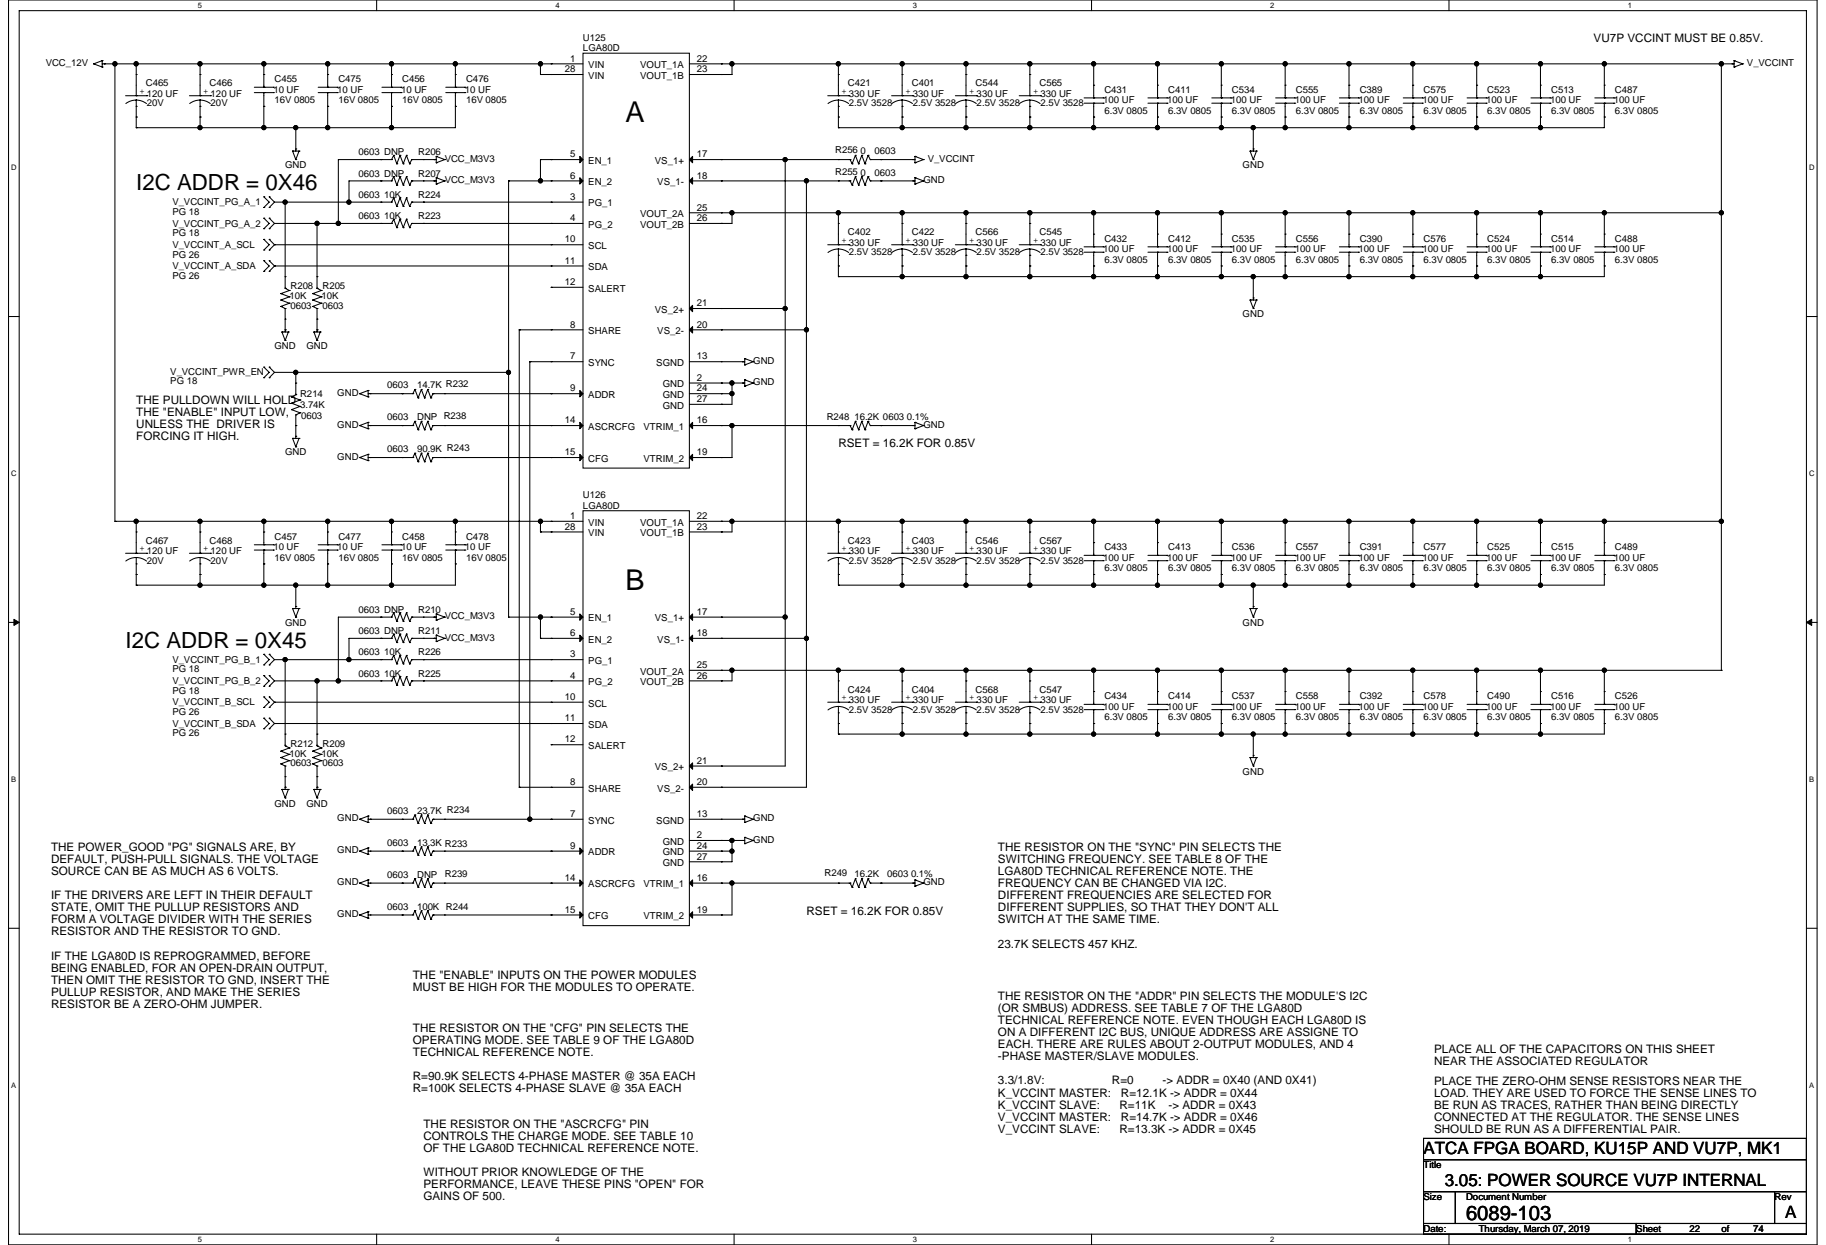
[picture p52: page 22]

U125 LGA80D VIN 1 VOUT_1A 22 | VU7P VCCINT MUST BE 0.85V.

V_VCCINT_PWR_EN
THE PULLDOWN WILL HOLD
THE "ENABLE" INPUT LOW,
UNLESS THE DRIVER IS
FORCING IT HIGH.

C | + + 10 UF 10 UF 10 UF 120 UF 120 UF | | | R248 16.2K 0603 0.1% GND RSET = 16.2K FOR 0.85V 100 UF 100 UF 100 UF 100 UF 100 UF 100 UF 100 UF 100 UF 100 UF 2.5V 3528 2.5V 3528 2.5V 3528 2.5V 3528 | C

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

THE RESISTOR ON THE "SYNC" PIN SELECTS THE
SWITCHING FREQUENCY. SEE TABLE 8 OF THE
LGA80D TECHNICAL REFERENCE NOTE. THE
FREQUENCY CAN BE CHANGED VIA I2C.
DIFFERENT FREQUENCIES ARE SELECTED FOR
DIFFERENT SUPPLIES, SO THAT THEY DON'T ALL
SWITCH AT THE SAME TIME.
23.7K SELECTS 457 KHZ.

THE "ENABLE" INPUTS ON THE POWER MODULES
MUST BE HIGH FOR THE MODULES TO OPERATE.

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

# V_MGTY1_AVCC = 0.9 V

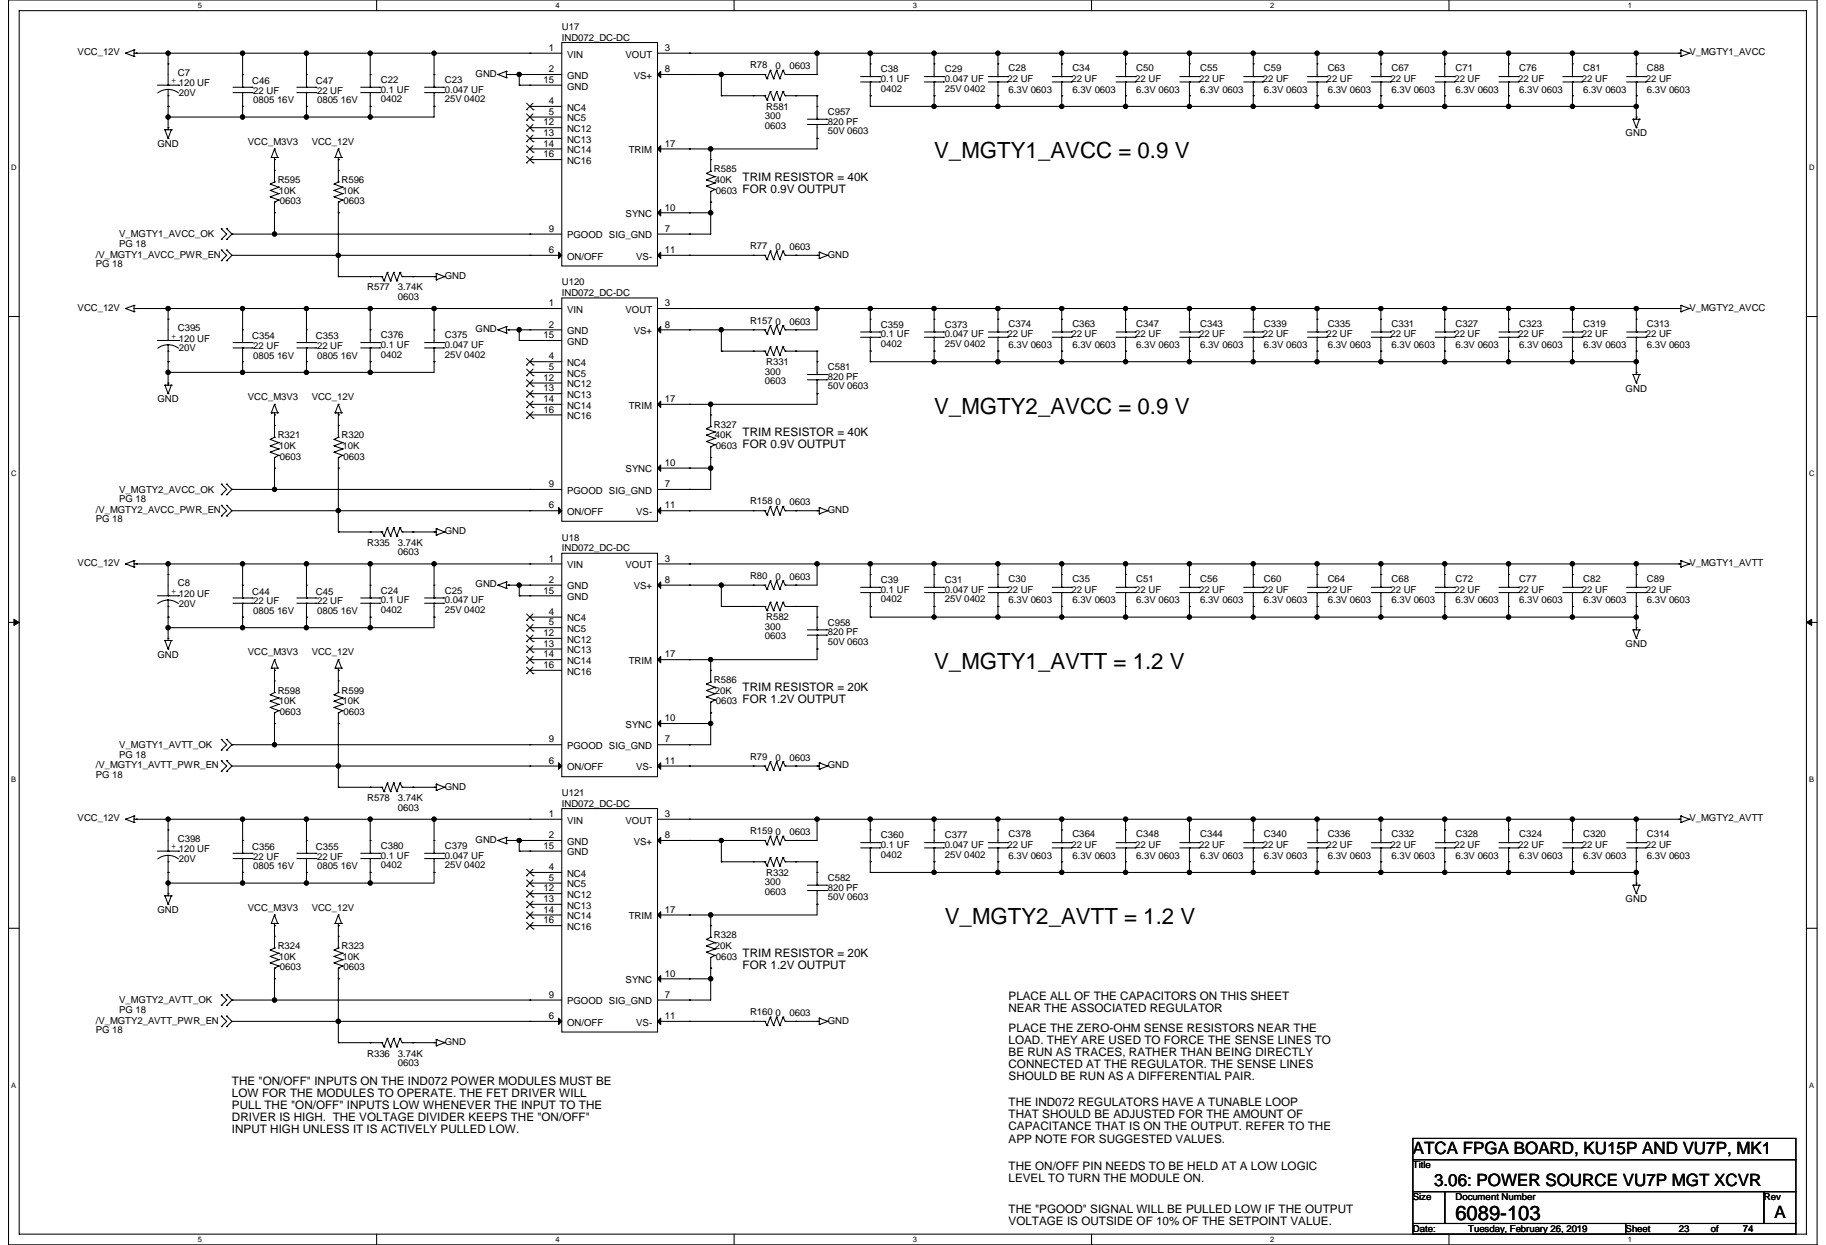
[picture p53: page 23]

U17 IND072_DC-DC VIN 1 VOUT 3 NC13 13 U120 IND072_DC-DC VIN 1 VOUT 3 | 50V 0603 FOR 0.9V OUTPUT

C | | U18 IND072_DC-DC VIN 1 VOUT 3 | FOR 0.9V OUTPUT | C

B | | NC13 13 50V 0603 GND FOR 1.2V OUTPUT U121 IND072_DC-DC VIN 1 VOUT 3 NC13 13 50V 0603 | | B

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

3.06: POWER SOURCE VU7P MGT XCVR

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

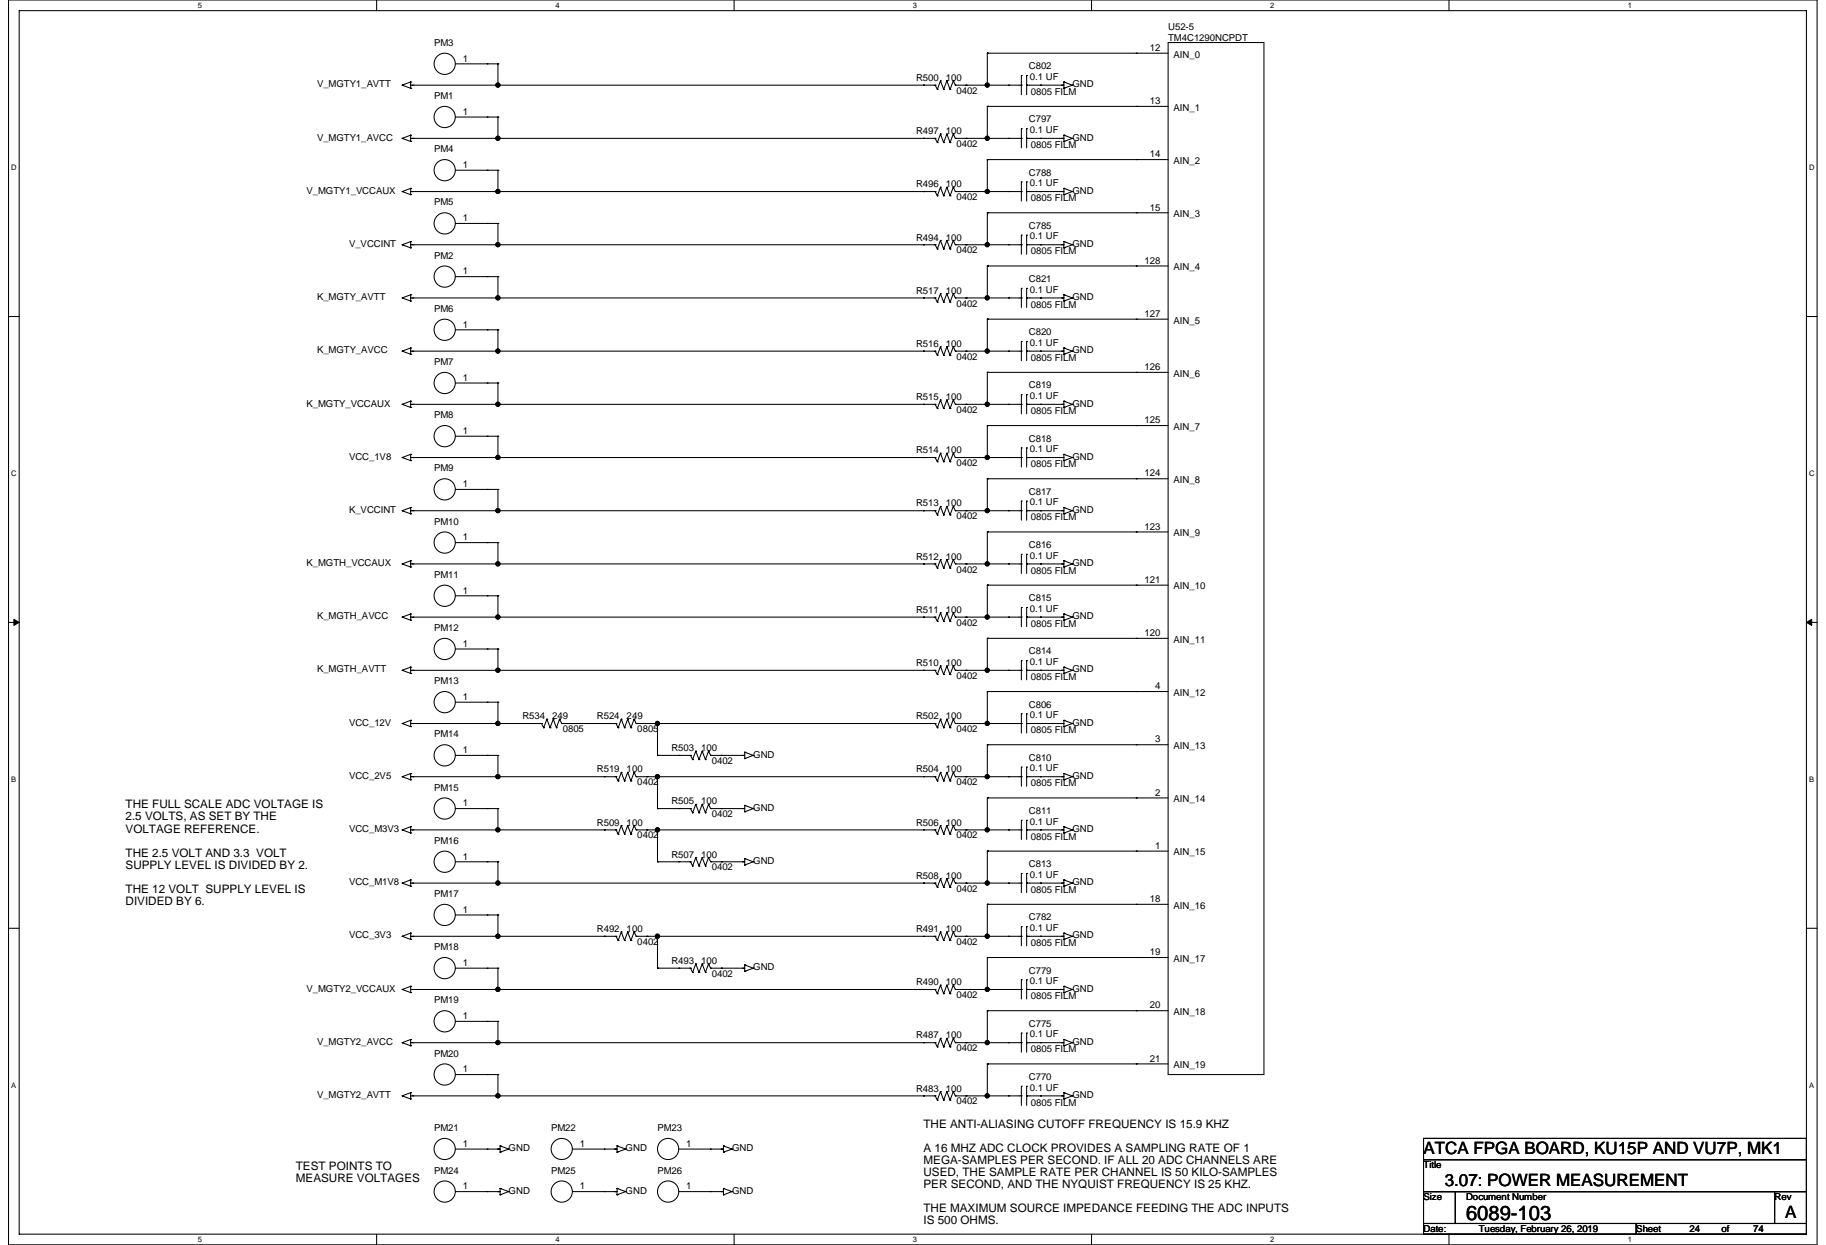
[picture p54: page 24]

PM3 | U52-5 TM4C1290NCPDT AIN_0 12 AIN_1 13 AIN_2 14 AIN_3 15 AIN_4 128

C | AIN_6 126 AIN_7 125 AIN_8 124 AIN_9 123 AIN_10 121 | C

B | DIVIDED BY 6. | | | AIN_11 120 4 0805 FILM PM17 1 AIN_16 18 | B

THE FULL SCALE ADC VOLTAGE IS
2.5 VOLTS, AS SET BY THE
VOLTAGE REFERENCE.
THE 2.5 VOLT AND 3.3 VOLT
SUPPLY LEVEL IS DIVIDED BY 2.
THE 12 VOLT SUPPLY LEVEL IS

PM21 TEST POINTS TO PM24 MEASURE VOLTAGES | THE ANTI-ALIASING CUTOFF FREQUENCY IS 15.9 KHZ PM22 PM23 GND GND GND A 16 MHZ ADC CLOCK PROVIDES A SAMPLING RATE OF 1 MEGA-SAMPLES PER SECOND. IF ALL 20 ADC CHANNELS ARE PM25 PM26 USED, THE SAMPLE RATE PER CHANNEL IS 50 KILO-SAMPLES PER SECOND, AND THE NYQUIST FREQUENCY IS 25 KHZ. GND GND GND THE MAXIMUM SOURCE IMPEDANCE FEEDING THE ADC INPUTS IS 500 OHMS. | AIN_18 20 AIN_19 21 3.07: POWER MEASUREMENT 3.07: POWER MEASUREMENT 3.07: POWER MEASUREMENT 6089-103 6089-103 6089-103 A A A Tuesday, February 26, 2019 Tuesday, February 26, 2019 Tuesday, February 26, 2019 24 24 24 74 74 74
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
