apollo-lhc/Cornell_CM_Rev1_HW/Orcad/SILKSCREEN_TOP.pdf

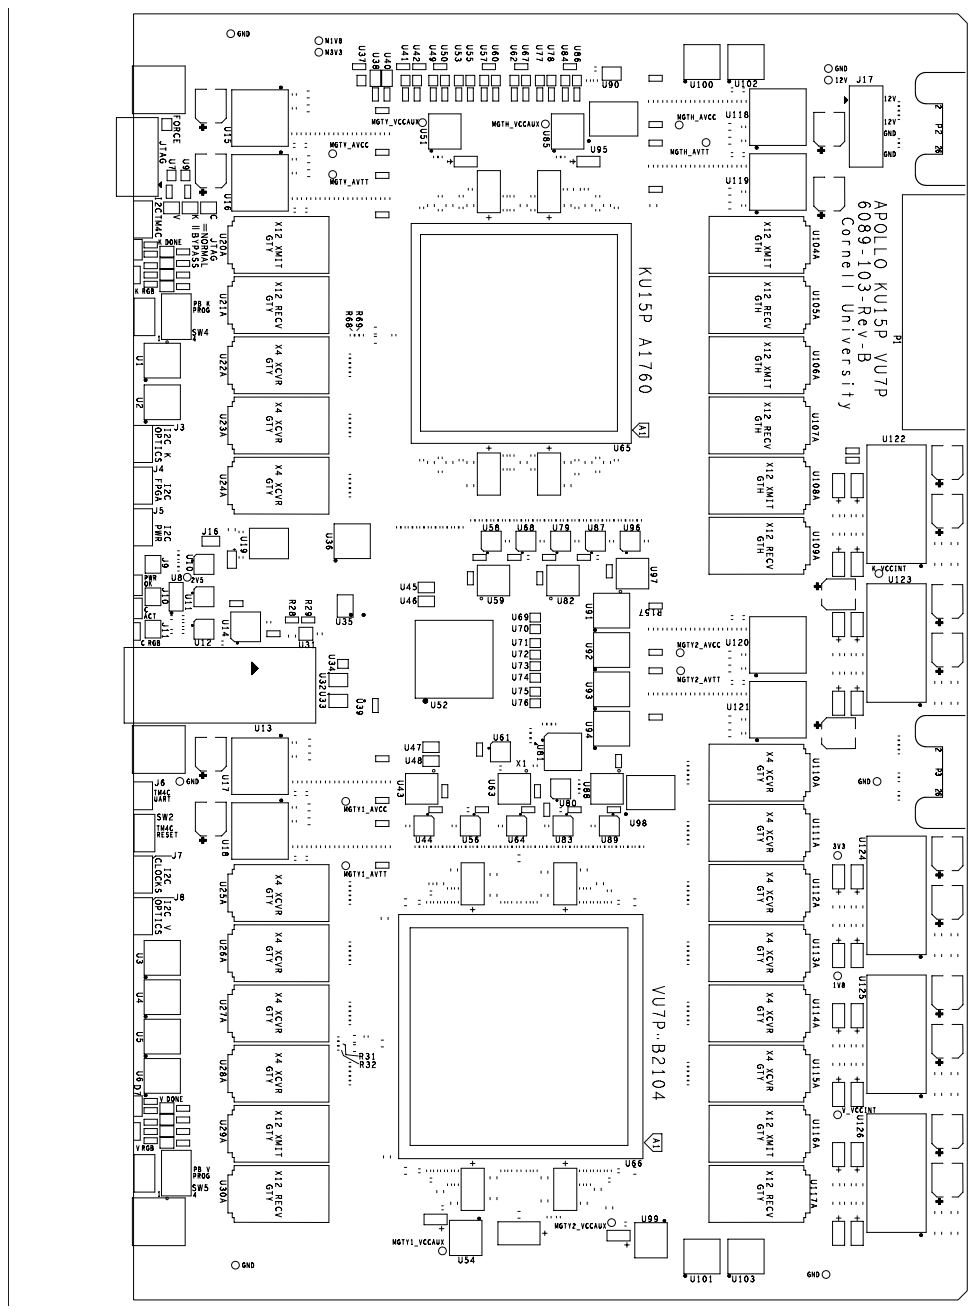
[picture p97: page 1]
