apollo-lhc/Cornell_CM_Rev1_HW/Orcad/Allegro/bottom_assy.pdf

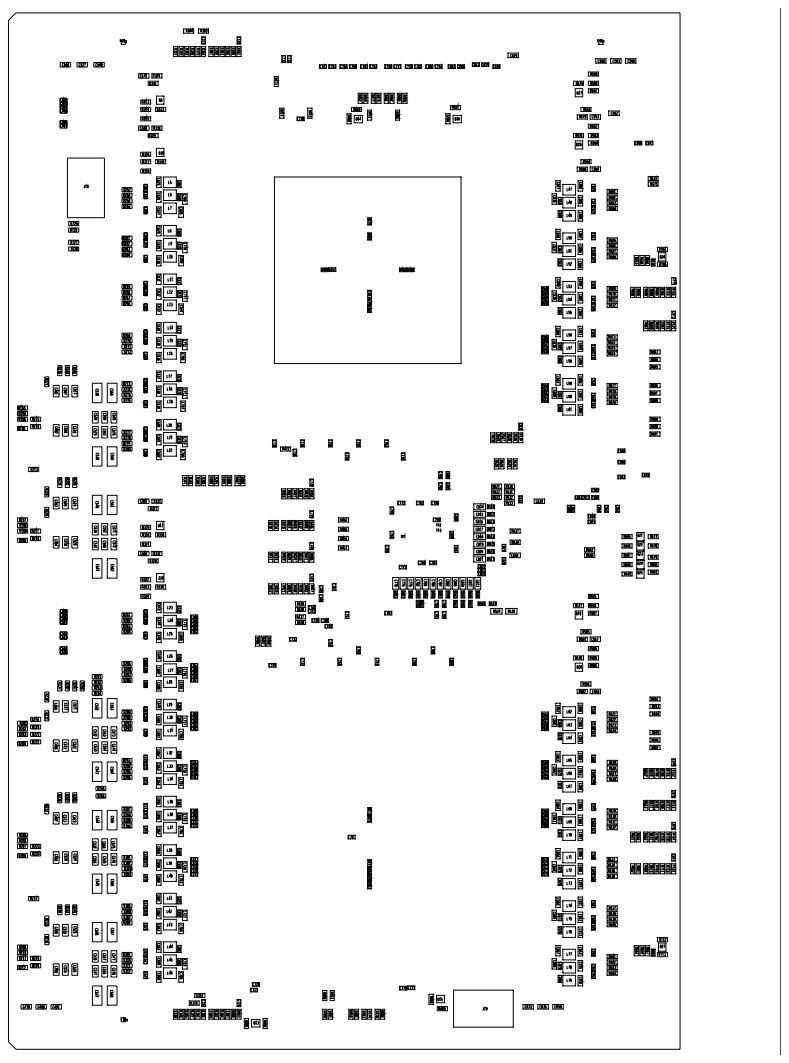
[picture p98: page 1]
