apollo-lhc/Cornell_CM_Rev1_HW/(list of files, drawings)

Other design files:
Orcad/ATCA_MEZZ_KU15P_VU7P.opj
