apollo-lhc/Cornell_CM_Rev1_HW/(commit log)

2019-02-19 Initial files for sharing
    [ATCA_MEZZ_KU15P_VU7P.opj]
2019-02-20 New spreadsheet with TM4C connection specs
    [TM4C_controller_pin_specs.xlsx]
2019-02-21 Adding datasheets, updated PCB layout
2019-02-22 Allegro BRD and Gerbers 22Feb2019
2019-02-22 Update TM4C_controller_pin_specs.xlsx
    update some classifications of some signal lines.
    [TM4C_controller_pin_specs.xlsx]
2019-02-23 BOMs and new Gerbers for brd69
    [6089-103-REVA_summary_BOM.xlsx, bom_raw_23Feb2019.xlsx]
2019-02-26 update Ref values in BOM
    [6089-103-REVA_summary_BOM.xlsx, bom_raw_23Feb2019.xlsx, bom_raw_24Feb2019.xlsx]
2019-02-26 Schematic update with sheet cross-ref
    [ATCA_MEZZ_KU15P_VU7P.opj]
2019-02-27 Daily update
    [6089-103-REVA_summary_BOM.xlsx, ATCA_MEZZ_KU15P_VU7P.opj]
2019-02-28 Daily update, FAB package ready
    [6089-103-REVA_summary_BOM.xlsx, ATCA_MEZZ_KU15P_VU7P.opj]
2019-04-12 Updated BOM
    [6089-103-RevB_summary_BOM_to_MPL.xlsx, 6089-103-RevB_summary_BOM_with_inventory.xlsx]
2019-04-15 Added STEP model
    [6089-103-RevB_summary_BOM_with_inventory.xlsx]
2019-05-13 Updated schematics with I2C addresses
    [6089-103-RevB_summary_BOM_with_inventory.xlsx, ATCA_MEZZ_KU15P_VU7P.opj]
2019-05-17 helper file to generate C code from XLS file and XLS file comment updates
    [TM4C_controller_pin_specs.xlsx]
2019-06-20 Update BOM
    [6089-103-RevB_summary_BOM_to_MPL_18Jun2019.xlsx, 6089-103-RevB_summary_BOM_with_inventory_18Jun2019.xlsx]
2019-07-16 Added heatsink drawings to repository
    [6089-104-RevA_HEATSINK_KU15P.ipt, 6089-107-RevA_HEATSINK_VU7P.ipt, 6089-110_FF_left_heatsink.ipt, 6089-111_FF_right_heatsink.ipt, heat_sink_fpga_CHEH3040.xlsx]
2019-08-02 Update TM4C_controller_pin_specs.xlsx
    change BLADE_ZYNQ_GPIO0 to BLADE_POWER_EN as per discussion with BU folks on 7/25.
    [TM4C_controller_pin_specs.xlsx]
2019-08-04 Update TM4C_controller_pin_specs.xlsx
    document fact that the BLADE_POWER_EN has a weak pull-up now to allow the board to function on a bench, without the SM
    [TM4C_controller_pin_specs.xlsx]
2019-08-26 Create CM_inventory.xlsx
    Created inventory spreadsheet
    [CM_inventory.xlsx]
2019-08-26 Update 6089-103_Hardware_Manual.docx
    Adding assembly instructions
2019-08-26 Create 6089-103-RevB_summary_BOM_with_inventory_23Jul2019.xlsx
    updated
    [6089-103-RevB_summary_BOM_with_inventory_23Jul2019.xlsx]
2019-08-26 Update CM_inventory.xlsx
    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
    [CM_inventory.xlsx]
2019-08-29 Update CM_inventory.xlsx
    Updated inventory and order status
    [CM_inventory.xlsx]
2019-08-30 Create atca_mezz_ku15p_vu7p_30Aug2019.pdf
    updated schematic
2019-10-29 Updated inventory
    [CM_inventory.xlsx]
2020-06-20 SM assignments
    [CM_inventory.xlsx]
2021-01-12 Start assigning boards to CMS/ATLAS
2021-02-18 Updating? Actually lost and confused
    [CM_inventory.xlsx]
2022-06-21 Enter board ID number for SM06
